prs2026/Witness/Hardware/Backplane/backplane v1/sideon_magswitch_output/sideon_preview.png

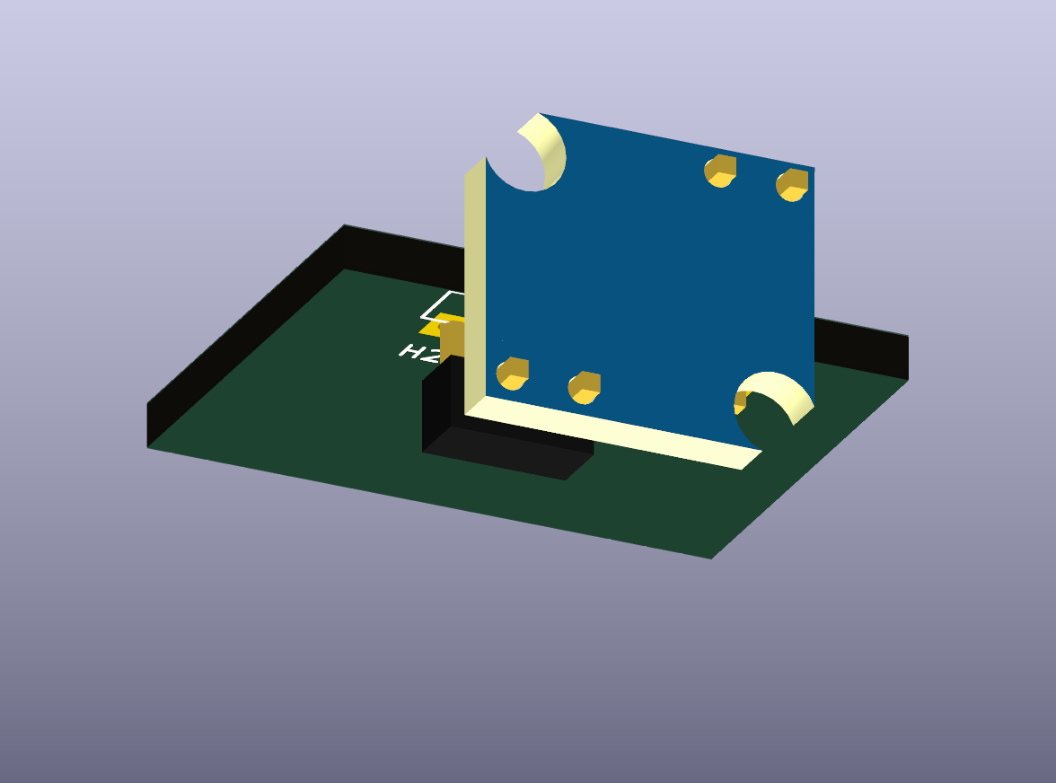
Hardware/Backplane/backplane v1/sideon_magswitch_output/sideon_preview.png
