prs2026/Witness/Hardware/Backplane/backplane v1/sideon_magswitch_output/sideon_front.png

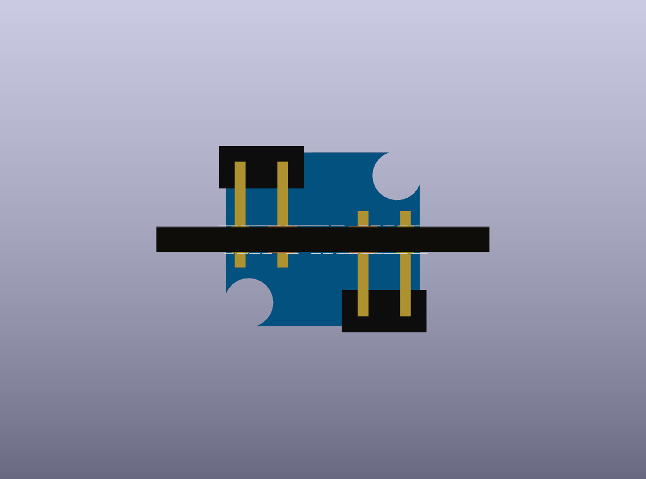
Hardware/Backplane/backplane v1/sideon_magswitch_output/sideon_front.png
