prs2026/Witness/Software/Horizon/GROUND_STATION_PROTOCOL.md

# Witness Ground-Station Communications Standard

This document describes the protocol implemented by the Witness firmware. The
authoritative machine-readable definitions remain in `main/comms.h`; this file
explains how a ground station should encode, transmit, find, and decode them.

## 1. Canonical application frame

All defined application packets use the same framing:

```text
+-----------+----------------------+------------+
| packet ID | fixed-length payload | EOF = 0x0A |
| 1 byte    | determined by ID     | 1 byte     |
+-----------+----------------------+------------+
```

- Multi-byte integers are big-endian.
- Signed integers use two's-complement representation.
- Floating-point values are big-endian IEEE-754 binary32 values.
- There is currently no application-level CRC. LoRa uses the SX1262 hardware
  CRC.
- `0x0A` is not escaped and may occur inside a payload. Never search for the
  next `0x0A` to find a frame boundary. Read the packet ID, select its fixed
  frame length, and check `0x0A` only at that frame's final byte.

Packet lengths include the packet ID and EOF:

| ID | Name | Payload bytes | Frame bytes | Local/USB rate | Default radio rate |
|---:|---|---:|---:|---|---|
| `0x01` | Sensor | 21 | 23 | 10 Hz | latest frame at 1 Hz |
| `0x02` | Estimated state | 63 | 65 | 1 Hz | latest frame at 1 Hz |
| `0x03` | Camera telemetry | 17 | 19 | Iris CAN, 1 Hz | latest frame at 1 Hz |
| `0x05` | Command | 8 | 10 | received externally | immediate; latest local frame at 1 Hz |
| `0x06` | Command acknowledgement | 11 | 13 | reply to each canonical command, on the link it arrived on | same, immediate |
| `0x07` | GPS-assist transfer status | 74 | 76 | reply to GPS-assist STATUS, on the link it arrived on | same, immediate |
| `0x0C` | HITL sensor input | 45 | 47 | host to Witness over USB only, ~100 Hz | never transmitted |
| `0x0E` | HITL IMU batch (8 samples at 960 Hz) | 148 | 150 | host to Witness over USB only, 120 Hz | never transmitted |
| `0xE0` | Witness debug | 101 | 103 | 10 Hz after debug enable | latest frame at 1 Hz |
| `0xE1` | IRIS debug | 12 | 14 | Iris CAN, 10 Hz after debug enable | latest frame at 1 Hz |
| `0xE2` | Kalman filter log | 101 | 103 | flash `P*.BIN` only, 25 Hz | never transmitted |
| `0xFF` | Heartbeat | 6 | 8 | 1 Hz | latest frame at 1 Hz |
| `0xF0` | Ground-station status | 27 | 29 | Aperture USB, 1 Hz | never transmitted |

All offsets in the packet tables below are absolute frame offsets: packet ID
is byte 0, the first payload byte is byte 1, and EOF is the last byte.

## 2. Common field encodings

| Field | Wire type | Conversion |
|---|---|---|
| Witness/IRIS uptime | `uint32` BE | milliseconds since boot; wraps after about 49.7 days |
| Witness/IRIS MCU temperature | `int8` | degrees C = raw |
| Witness/IRIS battery | `uint16` BE | millivolts = raw |
| Filtered acceleration | `int24` BE | g = raw x 0.000040 |
| Quaternion X/Y/Z/W | float32 BE | unitless normalized Hamilton quaternion, scalar last, body to ENU world; all zero = unavailable |
| Position X/Y/Z | float32 BE | meters, estimator local frame |
| Velocity X/Y/Z | float32 BE | meters/second, estimator local frame |
| LSM6 low-g acceleration | `int16` BE | g = raw x 0.000488 |
| LSM6 high-g acceleration | `int16` BE | g = raw x 0.010417 |
| LSM6 angular rate | `int16` BE | degrees/second = raw x 0.070 |
| LSM6 temperature | `int16` BE | degrees C = 25 + raw / 256 |
| MS5607 pressure | `uint24` BE | pascals = raw |
| MS5607 temperature | `int16` BE | degrees C = raw / 100 |
| MS5607 altitude | float32 BE | geometric meters, ISA (all layers to 47 km) relative to 1013.25 mbar |
| Latitude/longitude | `int24` BE | degrees = raw / 10,000; north/east positive |
| GPS time | `uint32` BE | Unix seconds |
| GPS altitude | float32 BE | meters above mean sea level |
| GPS satellites | `uint8` | satellites used in the solution (NMEA GGA field 7) |
| GPS fix quality | `uint8` | NMEA GGA field 6: 0 no fix, 1 GPS, 2 DGPS, ... |
| Channel current | `uint8` | amperes = raw x 0.02 |
| Command | `uint16` BE | enumeration; no scaling |

To decode a signed 24-bit integer:

```python
def i24be(data: bytes) -> int:
    value = int.from_bytes(data, "big", signed=False)
    return value - (1 << 24) if value & 0x800000 else value
```

## 3. Witness status bytes

The two-byte Witness status field appears in packets `0x01`, `0x02`, `0x05`,
`0xE0`, and `0xFF`.

Status byte 0 contains active-high flags:

| Bit | Mask | Meaning |
|---:|---:|---|
| 0 | `0x01` | Heartbeat phase; toggles once per heartbeat |
| 1 | `0x02` | Valid LSM6 low-g acceleration available |
| 2 | `0x04` | Valid LSM6 gyro sample available |
| 3 | `0x08` | Valid LSM6 temperature available |
| 4 | `0x10` | External NAND initialization or startup test failed |
| 5 | `0x20` | Valid LSM6 high-g acceleration available |
| 6 | `0x40` | Valid MS5607 sample available |
| 7 | `0x80` | Flash initialized but logging later failed |

Status byte 1 bits 0 through 2 contain the flight state. Bits 3, 4 and 5 are
flags; bits 6 and 7 are reserved and transmitted as zero.

| Bit | Mask | Meaning |
|---:|---:|---|
| 3 | `0x08` | GPS locked: a fresh GGA fix (quality >= 1, within 3 s) exists |
| 4 | `0x10` | HITL mode active: sensor, GPS and battery values are simulated |
| 5 | `0x20` | MAINTENANCE boot (Wi-Fi OTA / log download mode): flight logging is OFF and Witness is NOT flight ready (`IRIS_WITNESS_STATUS_MAINTENANCE_MASK`) |

In maintenance mode Witness's LoRa sends only one `0x02` state packet every 5 s
(a beacon), so over the radio only state packets arrive, about every 5 s; over
USB everything still arrives. Horizon shows a red banner and a
`MAINTENANCE - NOT FLIGHT READY` window-title prefix while the bit is set, and
clears them when a packet with the bit clear arrives (not on age alone).

Decode the flight state as `byte1 & 0x07`, not as the whole byte.

| Value | Flight state |
|---:|---|
| `0x00` | Pad idle |
| `0x01` | Boost |
| `0x02` | Coast |
| `0x03` | Descent |
| `0x04` | Landed |

## 4. Packet layouts

### `0x01` Sensor packet, 23 bytes

| Frame offset | Size | Field |
|---:|---:|---|
| 0 | 1 | Packet ID `0x01` |
| 1 | 2 | Witness status |
| 3 | 4 | Witness uptime, ms |
| 7 | 3 | Filtered acceleration X, signed int24 |
| 10 | 3 | Filtered acceleration Y, signed int24 |
| 13 | 3 | Filtered acceleration Z, signed int24 |
| 16 | 2 | Gyro X, signed int16 |
| 18 | 2 | Gyro Y, signed int16 |
| 20 | 2 | Gyro Z, signed int16 |
| 22 | 1 | EOF `0x0A` |

Filtered acceleration is the calibrated low-g accelerometer. From the first
sample where any axis of either accelerometer reaches 15 g, it is the high-g
accelerometer instead, back to low-g once all axes stay below 13 g for about
10 ms. It is low-pass filtered (2nd-order Butterworth, 100 Hz, about 2.5 ms
delay) on the 960 Hz sample stream and sent in the 40 micro-g/count format
(range about +/-335 g).

### `0x02` Estimated-state packet, 65 bytes

| Frame offset | Size | Field |
|---:|---:|---|
| 0 | 1 | Packet ID `0x02` |
| 1 | 2 | Witness status |
| 3 | 4 | Witness uptime, ms |
| 7 | 4 | Quaternion X, float32 |
| 11 | 4 | Quaternion Y, float32 |
| 15 | 4 | Quaternion Z, float32 |
| 19 | 4 | Quaternion W, float32 |
| 23 | 4 | Position X, float32 m |
| 27 | 4 | Position Y, float32 m |
| 31 | 4 | Position Z, float32 m |
| 35 | 4 | Velocity X, float32 m/s |
| 39 | 4 | Velocity Y, float32 m/s |
| 43 | 4 | Velocity Z, float32 m/s |
| 47 | 3 | Latitude, signed int24 |
| 50 | 3 | Longitude, signed int24 |
| 53 | 4 | GPS altitude, float32 m MSL |
| 57 | 4 | Kalman altitude, float32 m above the pad (see below) |
| 61 | 2 | Witness/FC battery voltage, uint16 mV |
| 63 | 1 | GPS satellites used, uint8 |
| 64 | 1 | EOF `0x0A` |

Status, uptime, the orientation quaternion, Kalman altitude, battery
voltage, valid UART1 GPS fixes and the satellite count are populated. Position
and velocity come from the position Kalman filter: ENU metres and m/s, origin
at the pad, zero until the attitude is initialized and held at zero while the
vehicle sits still on the pad. Satellites come from the most recent checksum-valid
GGA within 3 s and are reported even when that GGA has no fix (position fields
are then zero); they are 0 when stale.

The altitude at offset 57 is the position Kalman filter's up estimate (equal
to Position Z), in metres above the pad. Firmware before 2026-11-10 sent the
raw MS5607 barometric altitude (m, ISA 1013.25 mbar) in this slot. Raw pressure
is still in `0x01`/`0xE0` and the flash sensor log, from which Horizon
recomputes the barometric altitude.

Quaternion convention (`0x02` and `0xE0`): Hamilton quaternion sent X, Y, Z,
W (scalar last), rotating BODY vectors into WORLD (`v_world = q v_body q^-1`).
WORLD is local ENU (+X east, +Y north, +Z up). BODY is the LSM6 sensor frame,
with +X along the rocket nose axis, so an upright rocket on the pad has body +X
pointing to world +Z. **All four components zero means attitude is not
available**: before the first accepted 1 s stationary window on the pad,
after HITL entry/exit until a new window is accepted, or when no window was
accepted before launch. Heading (rotation about world +Z) is not observable without a
magnetometer; it is fixed arbitrarily by the shortest-arc tilt alignment at
initialization (an exactly upright rocket gets body +Y = north, body +Z =
west), so compare yaw only relative to that start. The attitude is gyro
propagated on the pad with a gated accelerometer tilt correction, purely gyro
integrated in Boost/Coast/Descent, and held constant from Landed onwards.

### `0x03` Camera telemetry packet, 19 bytes

| Frame offset | Size | Field |
|---:|---:|---|
| 0 | 1 | Packet ID `0x03` |
| 1 | 2 | Flight-controller/Witness status |
| 3 | 4 | Flight-controller/Witness uptime, ms |
| 7 | 2 | IRIS status |
| 9 | 4 | IRIS uptime, ms |
| 13 | 1 | Channel 1 current, 0.02 A/count |
| 14 | 1 | Channel 2 current, 0.02 A/count |
| 15 | 1 | Channel 3 current, 0.02 A/count |
| 16 | 2 | IRIS battery voltage, mV |
| 18 | 1 | EOF `0x0A` |

IRIS status flags are defined in `comms.h`: monitor error, battery error, command flag, OUT1/2/3 enabled, and 5 V enabled.

### `0x05` Command packet, 10 bytes

| Frame offset | Size | Field |
|---:|---:|---|
| 0 | 1 | Packet ID `0x05` |
| 1 | 2 | Witness status supplied by sender |
| 3 | 4 | Sender uptime in milliseconds |
| 7 | 2 | Command value, uint16 BE |
| 9 | 1 | EOF `0x0A` |

Example command packet with zero status/uptime and command `0x0051`:

```text
05 00 00 00 00 00 00 00 51 0A
```

Command values currently defined:

| Value | Meaning |
|---:|---|
| `0x0030` | Channel 1 load off |
| `0x0031` | Channel 1 load on |
| `0x0032` | Channel 2 load off |
| `0x0033` | Channel 2 load on |
| `0x0034` | Channel 3 load off |
| `0x0035` | Channel 3 load on |
| `0x0050` | 5 V regulator off |
| `0x0051` | 5 V regulator on |
| `0x00E0` | Enable Witness debug packets at 10 Hz |
| `0x4849` | Enter HITL mode (USB only, Pad Idle only; see section 4a) |
| `0x4858` | Exit HITL mode (USB or LoRa) |
| `0x6868` | Enter read-only USB mass-storage mode. USB only, and only in Pad Idle or Landed; over LoRa it is always refused (`IRIS_ACK_REFUSED`) |
| `0x6869` | Erase all stored log sessions (every block; slow). USB only, Pad Idle or Landed only; refused over LoRa |
| `0x686A` | Clear all stored log sessions (fast: only the two session headers are erased; the session number keeps counting). USB only, Pad Idle or Landed only; refused over LoRa |
| `0x4741` / `0x4744` / `0x4745` / `0x4751` | GPS assistance upload BEGIN / DATA / COMMIT / STATUS (ephemeris for the receiver; chunked, Witness-local, never forwarded; see section 4b) |
| `0x4752` | GPS cold start: the receiver forgets ephemerides, almanac, position and time; Witness then reconfigures it (Pad Idle only; Witness-local, never forwarded) |
| `0x4844` | Pad heading: body axis and azimuth (Pad Idle only; Witness-local; see section 4c) |
| `0x5250` | Radio power, RAM only: d0 target (`0x00` Witness, `0x01` ground station), d1 SX1262 drive in dBm as int8, -9..+3 (Ra-01SH-P output is about 26 dB higher). Both radios boot at -9 dBm. Witness applies target 0 from USB or radio. Aperture applies target 1 to its own radio, acks on USB and does not transmit it. The ack's detail is the drive now in use (int16); out of range is answered with "bad argument". |
| `0x5746` | Wi-Fi OTA / log download, Witness only, USB or radio, Pad Idle or Landed only (otherwise refused): d0 `0` off / `1` on, d1 Wi-Fi max TX power in dBm as int8 (`0` keeps the default +8; 2..20), d2 auto-off minutes (`0` = 15; up to 240). Never starts at boot. `0x5746` now reboots Witness into maintenance mode (status byte 1 bit 5); d0 `2` is a status query whose ack detail is: bit 8 AP up, bit 9 start watchdog fired, low byte last start step (`0xEE` = start failed). While on, Witness stops all LoRa transmission (telemetry and acks) but keeps receiving; the ack of a radio off command is sent after Wi-Fi is off. Turns off by itself without HTTP activity and on any flight state change out of Pad Idle/Landed. Out-of-range arguments are answered with "bad argument". Use `witness_ota.py` on the access point `witness-XXXX` (192.168.4.1). |
| `0x7300` through `0x7304` | Set flight state using the values above. Over LoRa only Landed -> Pad Idle (`0x7300` while Landed, to re-arm after recovery) is accepted; everything else, including the `0x7301` launch trigger, is refused. Over USB any state is accepted from Pad Idle or Landed, but from Boost/Coast/Descent only Landed (`0x7304`) is; other requests are refused. Refusals ack `IRIS_ACK_REFUSED` |

The last three commands also have legacy compact USB forms described in
section 7. Canonical commands received from USB or LoRa are retransmitted
byte-for-byte through the Iris CAN link. The firmware does not rewrite their status or uptime.
Radio commands are additionally interpreted locally.

### `0x06` Command acknowledgement packet, 13 bytes

Witness sends one `0x06` for each canonical 10-byte `0x05` command it handles,
on the link the command arrived on (USB, or radio through Aperture, which
forwards the frame to USB unchanged). Two commands are not acknowledged this
way: GPS-assist DATA (`0x4744`) is confirmed in bulk by `0x07`, and GPS-assist
STATUS (`0x4751`) is answered only by `0x07`. The host matches an
acknowledgement to a command by opcode and the six data bytes.

| Frame offset | Size | Field |
|---:|---:|---|
| 0 | 1 | Packet ID `0x06` |
| 1 | 2 | Opcode of the command acknowledged, uint16 BE (command bytes 7-8) |
| 3 | 6 | The command's six data bytes (frame bytes 1-6), echoed |
| 9 | 1 | Result (table below) |
| 10 | 2 | Detail, uint16 BE; zero unless stated below |
| 12 | 1 | EOF `0x0A` |

| Value | Name | Meaning |
|---:|---|---|
| `0x00` | ok | Applied or accepted |
| `0x01` | refused | Not allowed now (flight state or mode) |
| `0x02` | bad argument | Malformed or out-of-range data, or a GPS-assist BEGIN/COMMIT with no matching transfer |
| `0x03` | unknown command | Opcode not recognized |
| `0x04` | busy | Try again later; GPS-assist COMMIT could not be queued to the receiver |
| `0x05` | incomplete | GPS-assist COMMIT with chunks missing; detail = chunks received; transfer stays open |
| `0x06` | bad CRC | GPS-assist COMMIT: CRC mismatch; transfer discarded |
| `0x07` | bad format | GPS-assist COMMIT: records do not parse; transfer discarded |

Example, pad heading command accepted:

```text
06 48 44 00 69 78 00 00 00 00 00 0A
```

### `0x07` Transfer status packet, 76 bytes

Witness sends this in reply to GPS-assist STATUS (`0x4751`), on the link the
STATUS arrived on. The STATUS data bytes d0-d1 give the first chunk of the
bitmap window; `0xFFFF` (or zero) means the window starts at the first missing
chunk. Chunks are 4 bytes each (section 4b).

| Frame offset | Size | Field |
|---:|---:|---|
| 0 | 1 | Packet ID `0x07` |
| 1 | 1 | Transfer id |
| 2 | 1 | State: 0 idle, 1 receiving, 2 complete (last transfer committed and passed to the receiver), 3 failed (CRC or format) |
| 3 | 2 | Blob length, uint16 BE |
| 5 | 2 | Chunks expected, uint16 BE |
| 7 | 2 | Chunks received, uint16 BE |
| 9 | 2 | First chunk of the bitmap window, uint16 BE |
| 11 | 64 | Bitmap: bit `i` of byte `i // 8` (LSB first) is chunk `window + i`; set = received. Chunks past the end of the blob read as set |
| 75 | 1 | EOF `0x0A` |

### 4b. GPS assistance upload (ground -> Witness -> GPS)

The SkyTraq PX1120S has no almanac-upload message (AN0037), but it accepts
GPS ephemeris over UART: message 0x41 "Set GPS Ephemeris", 87 bytes (SV id,
then subframes 1-3 as a reserved byte plus the 24 data bits of words 2-10),
answered by ACK `83 41` or NACK `84 41`. Ephemeris is more useful than an
almanac: the receiver needs no subframe decoding before its first fix.

The ground builds a blob of records `[u16 length][SkyTraq body]` (at most
4096 bytes; 29 ephemerides are 2,581 bytes) and sends it in ordinary
canonical command frames `05 d0 d1 d2 d3 d4 d5 HH LL 0A`:

| Opcode | Data bytes d0-d5 |
|---|---|
| `0x4741` BEGIN | total length (u16 BE), CRC-16/CCITT-FALSE of the blob (u16 BE), format 1 (SkyTraq), transfer id |
| `0x4744` DATA | byte offset (u16 BE, multiple of 4), 4 data bytes (last chunk zero padded) |
| `0x4745` COMMIT | transfer id |
| `0x4751` STATUS | none; Witness logs the transfer and receiver progress |

Chunks may arrive out of order or repeated. COMMIT checks every chunk and the
CRC; Witness then writes the records to the receiver one at a time (waiting
up to 1 s for each ACK/NACK, one retry) and logs `GPS assist done: A/N
acknowledged, R rejected, U unanswered`. A COMMIT with missing chunks logs
how many arrived, so the ground can resend. The frames work over USB and the
radio; they are never forwarded to CAN or retransmitted by radio.
`Horizon/gps_assist.py` builds them from a RINEX broadcast-ephemeris file;
Horizon's Witness monitor has an "Upload GPS ephemeris…" button and the HITL
bench sends the RF scenario's ephemerides before a run.

**Resume.** A BEGIN with the same id, length and CRC as the transfer in progress
is accepted without clearing it, so chunks already received are kept. A BEGIN
with any other id, length or CRC starts over and discards the chunks. A COMMIT
repeated after a successful commit is answered `ok` again (`AlreadyComplete` in
the firmware) without passing the records to the receiver a second time, so a
lost COMMIT acknowledgement is harmless.

**Acknowledgements.** BEGIN is acknowledged `ok` when accepted (detail 0) and
`bad argument` when rejected. DATA is never acknowledged; a rejected DATA frame
is dropped silently. STATUS is answered only by `0x07`. COMMIT is answered with
the result codes of section 4 (`0x06`).

### 4c. Pad heading command (ground -> Witness)

Canonical command `0x4844` tells Witness which body axis points to which
azimuth while the rocket is on the pad. Witness has no magnetometer, so without
it the heading stays arbitrary until GPS shows the course. The data bytes are
the usual six bytes of frame offsets 1-6:

| Frame offset | Data | Field |
|---:|---:|---|
| 1 | d0 | Body axis: `0` +Y, `1` -Y, `2` +Z, `3` -Z; `0xFF` clears the setting |
| 2-3 | d1-d2 | Azimuth in 0.01 degree clockwise from true north, uint16 BE, 0 to 35999 |
| 4-6 | d3-d5 | Zero |

Examples (the axis is set so that it points to the azimuth):

```text
05 00 69 78 00 00 00 48 44 0A    +Y points to 270.00 degrees
05 FF 00 00 00 00 00 48 44 0A    clear
```

Witness applies the setting by turning its attitude about the vertical, and
re-applies it after every attitude re-initialization on the pad. Pad Idle only:
otherwise the acknowledgement is `refused`. An unknown axis code or an azimuth of
36000 or more is `bad argument`. Accepted over USB and radio. Horizon's
"Set pad heading…" button builds the frame with `build_pad_heading_packet`.

### 4d. Ground-station acknowledgement and retry (Horizon)

Horizon (`command_link.py`, `monitor_core.py`) handles acknowledged commands as
follows:

- Each canonical command except GPS-assist DATA is written and then waited on
  for a matching `0x06`. It waits 0.5 s per try on USB or 1.5 s via TCP
  (Aperture/radio), resending the frame before each retry, for up to 5 tries.
- Console lines: `ACK[target] label: ok`, `NAK[target] label: <result> (detail n)`,
  or `NO_ACK[target] label: no acknowledgement after 5 tries`.

GPS-assist upload (`upload_gps_assist` / `CommandLink.upload_assist`):

1. BEGIN is sent and acknowledged (3 tries per round). Without an answer Horizon
   waits 1 s and tries again, for up to 600 s.
2. All DATA chunks are sent, paced at 3 ms per frame on USB or 60 ms via TCP.
3. A STATUS (window from the first missing chunk) is sent and the `0x07` bitmap is
   read. If there is no reply, Horizon waits 1 s, sends BEGIN again (resume, which
   must be acknowledged) and asks STATUS again, until the 600 s limit.
4. Only the chunks the bitmap reports missing are resent, followed by STATUS, until
   every chunk is held.
5. If the reply shows a different transfer id or a state other than receiving (for
   example after a Witness reboot), Horizon sends BEGIN again and resends every
   chunk. A complete transfer with the same id ends the upload as already complete.
6. COMMIT is sent and acknowledged (5 tries). `ok` ends the upload; any other
   result is reported as a refusal with its detail.

### `0xFF` Heartbeat packet, 8 bytes

| Frame offset | Size | Field |
|---:|---:|---|
| 0 | 1 | Packet ID `0xFF` |
| 1 | 2 | Witness status |
| 3 | 4 | Witness uptime, ms |
| 7 | 1 | EOF `0x0A` |

### `0xF0` Ground-station status packet, 29 bytes

Aperture emits this frame only over USB once per second. It is never sent over
LoRa. Its GPS fields come from Aperture's own Quectel LC86 receiver in the pad
box and give the launch pad position when the Featherweight ground station's
location is not available.

| Frame offset | Size | Field |
|---:|---:|---|
| 0 | 1 | Packet ID `0xF0` |
| 1 | 1 | Last valid LoRa RSSI, int8 dBm (`-127` before the first packet) |
| 2 | 4 | Station uptime, uint32 ms |
| 6 | 1 | GPS fix quality, uint8, NMEA GGA field 6 (0 = no fix) |
| 7 | 1 | GPS satellites used, uint8 (GGA field 7) |
| 8 | 4 | Latitude, int32, 1e-7 degree/count, north positive |
| 12 | 4 | Longitude, int32, 1e-7 degree/count, east positive |
| 16 | 4 | GPS altitude, float32 m above mean sea level |
| 20 | 4 | GPS time, uint32 Unix seconds (0 = unknown) |
| 24 | 2 | HDOP, uint16, 0.01/count (`0xFFFF` = unknown) |
| 26 | 2 | Fix age, uint16 ms since the reported position (`0xFFFF` = none, or 65.535 s or older) |
| 28 | 1 | EOF `0x0A` |

Payload offsets in `comms.h` (`IRIS_PACKET_GROUND_STATION_STATUS_*_OFFSET`)
are these frame offsets minus one. All multi-byte fields are big-endian.

- Fix quality, satellites and HDOP come from the most recent checksum-valid
  GGA, including a no-fix GGA. When that GGA is 3 s old or older (or none has
  arrived), quality and satellites are 0 and HDOP is `0xFFFF`.
- Latitude, longitude and altitude hold the last valid fix (GGA quality 1..8
  with a parseable position), however old; use the fix-age field to judge it.
  They are zero, with fix age `0xFFFF`, until a fix has been seen since boot.
- GPS time is the UTC of the last RMC with status `A`, advanced by the
  station's elapsed time since that RMC arrived, so it keeps counting through a
  dropout. It is 0 until such an RMC has been received.
- Hosts should still accept the pre-GPS 13-byte form (11-byte payload: RSSI,
  uptime, six zero bytes; `IRIS_PACKET_GROUND_STATION_STATUS_LEGACY_DATA_LENGTH`).

### `0xE0` Witness debug packet, 103 bytes

| Frame offset | Size | Field |
|---:|---:|---|
| 0 | 1 | Packet ID `0xE0` |
| 1 | 2 | Witness status |
| 3 | 4 | Witness uptime, ms |
| 7 | 1 | Witness MCU temperature, int8 C |
| 8 | 2 | Witness battery voltage, uint16 mV |
| 10, 13, 16 | 3 each | Filtered acceleration X/Y/Z, int24 |
| 19, 23, 27, 31 | 4 each | Quaternion X/Y/Z/W, float32 |
| 35, 39, 43 | 4 each | Position X/Y/Z, float32 m |
| 47, 51, 55 | 4 each | Velocity X/Y/Z, float32 m/s |
| 59, 61, 63 | 2 each | LSM6 low-g X/Y/Z, int16 |
| 65 | 2 | LSM6 temperature, int16 |
| 67, 69, 71 | 2 each | LSM6 high-g X/Y/Z, int16 |
| 73, 75, 77 | 2 each | LSM6 gyro X/Y/Z, int16 |
| 79 | 3 | MS5607 pressure, uint24 Pa |
| 82 | 2 | MS5607 temperature, int16 centi-C |
| 84 | 4 | Kalman altitude, float32 m above the pad (as `0x02`) |
| 88 | 3 | Latitude, int24 |
| 91 | 3 | Longitude, int24 |
| 94 | 4 | GPS Unix time, uint32 s |
| 98 | 4 | GPS altitude, float32 m MSL |
| 102 | 1 | EOF `0x0A` |

Position and velocity are the Kalman filter estimate, as in `0x02`. MCU
temperature and GPS Unix time remain zero. The
quaternion is populated exactly as in `0x02` (same convention; all zero until
the estimator is initialized), so enabling debug output with command `0x00E0`
gives 10 Hz quaternions on USB (LoRa still sends the newest debug frame at its
1 Hz radio rate). GPS latitude, longitude and MSL altitude come from UART1 NMEA
GGA fixes.

### `0xE2` Kalman filter log packet, 103 bytes (flash log only)

Witness writes one per position-filter update cycle (25 Hz) into the flash
packet stream (`P*.BIN`, record source 5) for post-flight review of the
filter. It is never sent over LoRa, USB or CAN. Floats are big-endian
float32; axes are East, North, Up relative to the pad.

| Frame offset | Size | Field |
|---:|---:|---|
| 0 | 1 | Packet ID `0xE2` |
| 1 | 1 | Flight state (0 Pad Idle .. 4 Landed) |
| 2 | 1 | Flags (below) |
| 3 | 1 | GPS satellites in the latest fix |
| 4, 8, 12 | 4 each | Position E/N/U, m |
| 16, 20, 24 | 4 each | Velocity E/N/U, m/s |
| 28, 32, 36 | 4 each | Position variance P00 E/N/U, m^2 |
| 40, 44, 48 | 4 each | Velocity variance P11 E/N/U, (m/s)^2 |
| 52, 56, 60 | 4 each | Position-velocity covariance P01 E/N/U, m^2/s |
| 64 | 4 | Barometer innovation (measurement - prediction), m |
| 68 | 4 | Barometer innovation variance S = P00 + R, m^2 |
| 72 | 4 | Barometer measurement sigma (sqrt R) of the latest update, m |
| 76, 80, 84 | 4 each | GPS innovation E/N/U, m |
| 88 | 4 | Mach (filter speed / ISA speed of sound) |
| 92 | 2 | Barometer updates used, uint16 running total |
| 94 | 2 | Barometer updates skipped by the Mach gate, uint16 |
| 96 | 2 | Barometer updates rejected by the 5-sigma gate, uint16 |
| 98 | 2 | GPS fixes used, uint16 |
| 100 | 2 | GPS axis updates rejected, uint16 |
| 102 | 1 | EOF `0x0A` |

Variances are after the cycle's updates. Innovations are NaN when that
measurement was not offered in the cycle; they are recorded whether or not the
gate accepted them. GPS R is (2.5 m horizontal, 5 m vertical, doubled below 6
satellites)^2. Counters wrap at 65536.

Flags: `0x01` filter initialized (attitude known), `0x02` IMU ignored (attitude
lost after gyro saturation), `0x04` pad hold, `0x08` barometer Mach gate
active, `0x10` barometer update accepted this cycle, `0x20` at least one GPS
axis accepted this cycle, `0x40` GPS origin set, `0x80` HITL active.

Horizon `converter.py` decodes it in `P*.BIN` exports (`packet_type`
`kalman_log`), adding `kf_*` flag columns and `position_sigma_*` /
`velocity_sigma_*` (square roots of the variances).

### `0xE1` IRIS debug packet, 14 bytes

| Frame offset | Size | Field |
|---:|---:|---|
| 0 | 1 | Packet ID `0xE1` |
| 1 | 2 | IRIS status |
| 3 | 4 | IRIS uptime, ms |
| 7 | 1 | IRIS MCU temperature, int8 C |
| 8 | 2 | IRIS battery voltage, uint16 mV |
| 10 | 1 | Channel 1 current, 0.02 A/count |
| 11 | 1 | Channel 2 current, 0.02 A/count |
| 12 | 1 | Channel 3 current, 0.02 A/count |
| 13 | 1 | EOF `0x0A` |

## 4a. HITL (hardware-in-the-loop) mode

HITL replaces Witness's IMU, barometer, GPS and battery readings with values
from host `0x0C` packets, so the flight state machine, telemetry and flash
logging run on simulated data. Real IMU, barometer and battery reads stop;
LoRa, CAN and logging continue.

- **Enter**: canonical 10-byte command `0x4849` (for example
  `05 00 00 00 00 00 00 48 49 0A`), accepted only from USB and only in Pad
  Idle. From LoRa, in another flight state, or in compact `05 48 49` form it is
  rejected and logged. Reboot always starts with HITL off.
- **Exit**: canonical command `0x4858` from USB or LoRa, or automatically when
  no valid `0x0C` packet arrives for 1000 ms (from entry or from the last
  packet). Exit does not change the flight state; send `0x7300` to return to
  Pad Idle if the simulation launched.
- **Detect**: status byte 1 bit 4 (`0x10`) is set while HITL is active.
- **Between enter and the first `0x0C` packet** all readiness flags (byte 0
  bits 1, 2, 3, 5, 6) are clear, battery and barometer fields are zero, the
  GPS reports no fix and 0 satellites, no `0x01` packet is produced and the
  flight state machine receives no input. No real reading is mixed in. The
  same reset happens on exit until real sensors produce new data.
- While active, each `0x0C` packet sets the low-g, high-g, gyro and IMU
  temperature ready flags; the barometer flag is set when pressure is non-zero.
  Barometric altitude is computed from the pressure with the MS5607 formula.
  The GPS fields feed state, debug and the GPS-locked bit exactly like a UART
  GGA (quality 1..8 is a fix; satellites are reported without one).
- The attitude estimator is reset on HITL entry and exit, then runs on the
  `0x0C` gyro and low-g accelerometer counts exactly as on real data: the
  quaternion stays all zero until a 1 s stationary window of simulated
  samples is accepted in Pad Idle (every |a| 0.95..1.05 g, accel scatter
  <= 0.02 g, gyro median <= 5 dps with at most 40% of samples more than 10 dps
  from it). Its time step is the Witness time of the sensor pass that consumed
  each frame (the `sim_time_ms` field is not used); a pass without a new frame
  is skipped and the next step spans 20 ms. The gyro passes through a 5-sample
  running median, so the reported attitude lags by 2 samples (20 ms). Send
  frames at a steady 100 Hz.
- HITL commands are bridged to Iris like any other `0x05` command (Iris ignores
  them). `0x0C` packets are never forwarded to CAN or LoRa.
- **`0x0E` HITL IMU batch** (optional, USB only): payload u32 index of the first
  sample (counting from 0 in each run), then 8 samples of int16 low-g x,y,z,
  high-g x,y,z, gyro x,y,z in the same counts as `0x0C`, followed by EOF
  `0x0A`. The samples are consecutive at 960 Hz. While these arrive, Witness
  runs its estimators and IMU log on them at 960 Hz and ignores the IMU fields
  of `0x0C`.
- Witness stops its attitude (all-zero quaternion) for the rest of a flight
  once any gyro axis saturates (>= 1950 dps for 2 samples) in Boost, Coast or
  Descent. Its position filter then ignores the IMU.

### `0x0C` HITL sensor input packet, 47 bytes (host to Witness, USB only)

| Frame offset | Size | Field |
|---:|---:|---|
| 0 | 1 | Packet ID `0x0C` |
| 1 | 2 | Sender status, ignored |
| 3 | 4 | Simulation time, uint32 ms (logged only) |
| 7, 9, 11 | 2 each | LSM6 low-g X/Y/Z, int16, 0.488 mg/count |
| 13, 15, 17 | 2 each | LSM6 high-g X/Y/Z, int16, 10.417 mg/count |
| 19, 21, 23 | 2 each | LSM6 gyro X/Y/Z, int16, 70 mdps/count |
| 25 | 2 | LSM6 temperature, int16, C = 25 + raw / 256 |
| 27 | 3 | Pressure, uint24 Pa (0 = no barometer data) |
| 30 | 2 | Barometer temperature, int16 centi-C |
| 32 | 3 | Latitude, int24, 0.0001 degree |
| 35 | 3 | Longitude, int24, 0.0001 degree |
| 38 | 4 | GPS altitude, float32 m MSL |
| 42 | 1 | GPS satellites used, uint8 |
| 43 | 1 | GGA fix quality, uint8 (0 = no fix) |
| 44 | 2 | Battery voltage, uint16 mV |
| 46 | 1 | EOF `0x0A` |

Send one complete frame per write, back to back at about 100 Hz (at least
every 1000 ms to stay in HITL). Witness frames them by fixed length and checks
EOF at byte 46; on a bad EOF it resynchronizes on the next `0x0C` byte. A `0x0C`
byte starts a frame unless an unfinished binary `0x05` command is in
progress; a `0x0C` or `0x05` byte discards any unterminated text line first.
Send commands as complete canonical frames between `0x0C` frames. Bytes consumed as `0x0C` frames, valid or not,
are **not echoed**; all other USB input is still echoed. Frames received while
HITL is inactive are discarded with a rate-limited log line.

## 5. LoRa/RA-01 settings

Witness radio is enabled in the checked-in configuration (`HW_RADIO_ENABLED=1`).
The RA-01/SX1262 link uses:

| Setting | Value |
|---|---|
| Packet type | LoRa |
| RF frequency | 926,000,000 Hz |
| TX power | -8 dBm (Witness), -2 dBm (Aperture) |
| Spreading factor | SF7 |
| Bandwidth | 500 kHz (SX1262 erratum 15.1 applied before every TX; see HITL/LORA_MODULATION_OPTIONS.md) |
| Coding rate | 4/5 |
| Preamble | 8 symbols |
| Header | Explicit |
| Payload CRC | Enabled |
| IQ | Normal, not inverted |
| Payload length | Variable; set to the canonical frame length for TX |

The firmware does not currently program the LoRa sync-word registers. Both
ends must use the same SX1262 reset/default sync-word setting, or the firmware
should be updated to configure an explicit value before deployment.

Every locally generated canonical packet updates a latest-frame cache keyed by
packet ID. The radio scheduler sends the newest cached frame at the independent
per-type rates declared as `kRadio*PacketRateHz` in `main/sensors.h`. All seven
rates default to 1 Hz. Changing a radio rate does not change the packet's normal
producer or USB rate. A packet type that has not yet been produced is skipped.
Rates must be non-zero integer divisors of 1000 Hz.

Only one scheduled frame is transmitted per sensor-task pass. Due packet types
are serviced round-robin, so simultaneous deadlines do not permanently favor
one ID. The requested rates are upper targets: LoRa airtime and immediate
traffic can reduce the achieved aggregate rate. Transmission is non-blocking:
the sensor task loads the frame and issues SetTx, then checks DIO1 for TxDone on
later 10 ms passes (about 43 ms of airtime for a 103-byte frame at SF7/500
kHz), so radio traffic no longer slows the 100 Hz sensor loop. A new frame is
started only after the previous one completes; reception is impossible while
transmitting. After each transmission the radio is returned to continuous
receive mode. DIO1 indicates RX or TX completion, and all radio work is
performed by the sensor task so SPI3 access does not race the sensors.

`SpiDataForwarder::kForwardExternalPacketsImmediately` controls the immediate
forwarding path and defaults to `true`. With it enabled, complete command frames
received over USB are
queued ahead of scheduled telemetry. Radio-originated packets are never sent
back to the radio, preventing an RF echo loop. Set the flag to `false` to make
all radio output use only the per-packet latest-frame schedule.

Every valid received radio packet up to the canonical maximum of 103 bytes is
forwarded unchanged to USB. A received packet beginning with `0x05` is also
queued unchanged for Iris CAN transmission and local interpretation. Debug enable,
debug enable and HITL-exit execute locally; mass storage and log erase/clear are refused over LoRa (USB only, Pad Idle/Landed); flight-state commands are limited to Landed -> Pad Idle over LoRa;
HITL enter is rejected over LoRa. Load and
5 V regulator commands have no Witness-local hardware action because they are
implemented by the external device. The GPS UART never receives these
AMA load/regulator commands. SX1262 packets with a CRC error are
discarded.

## 6. Iris CAN and GPS UART1 interfaces

### Iris CAN device link

Iris and Witness use TCAN3414-compatible transceivers with the ESP32 Classical
CAN controller at **500 kbit/s**, standard 11-bit identifiers. Witness TX is
GPIO37 and RX GPIO36. Iris TX is GPIO3 and RX GPIO1. Witness-to-Iris uses
`0x120`; Iris-to-Witness uses `0x121`. CAN FD is not used.

Each CAN data frame carries `[sequence, fragment_index, canonical_length]`
followed by up to five consecutive application-frame bytes. Indices start at
zero; every fragment repeats the sequence and total length. DLC is exactly
three plus the bytes carried. Reassembly requires ordered fragments, matching
sequence/length, and completion within 250 ms. The common implementation is
`Software/Intercomm/can_transport.h`; packets retain their canonical ID and EOF.

USB compact commands are normalized to canonical 10-byte command frames;
malformed commands are rejected before forwarding. Commands go to Iris through
CAN, never to the GPS UART. Iris replies and camera/debug telemetry are mirrored
to Witness USB and cached for the normal radio schedule; replies are not echoed
back to CAN. Witness sends a 1 Hz heartbeat over CAN, and Iris uses its status
and uptime in camera telemetry, clearing those FC fields after 3 s without a
fresh heartbeat. Iris current fields use **20 mA/count**, with a 5.10 A maximum.
Camera currents are one-second peaks; debug currents are latest samples.

Both bus ends require 120 ohm termination and a common ground. TCAN3414 STB must
be low and SHDN low or left at its specified internal pull-down for normal mode;
these boards ground STB and have no MCU standby-control signal.

### GPS UART1 receiver

GPS uses UART1; the I2C driver is not started or included in the build.

| Setting | Value |
|---|---|
| ESP32 RX | GPIO4 <- GPS TX (GPIO5 while `HW_MCU_UART_SWAP_RX_TX` is 1, as currently built) |
| ESP32 TX | GPIO5 -> GPS RX (GPIO4 while swapped) |
| Ground | Shared with receiver |
| Logic voltage | 3.3 V |
| Operational baud | 115200, 8N1, no flow control |

At startup `GpsReceiver` (`main/gps_receiver.h`) identifies the receiver as a
SkyTraq PX1120S or a u-blox NEO-M8N by which binary protocol answers a poll,
then sets airborne 4 g dynamics, the receiver's maximum update rate, and NMEA
output of GGA + RMC only. A receiver already streaming NMEA at 115200 is never
baud-probed; only a silent link is retried at 9600 (the u-blox factory rate),
and a u-blox found there is switched to 115200. A five-second `GPS RX`
diagnostic reports host baud, total bytes, valid GGA sentence count, fix
validity and time since the last UART byte. A failed startup configuration does
not stop raw collection, sensors, heartbeat or flash logging.

| Receiver | Dynamics | Update rate | NMEA output |
|---|---|---|---|
| PX1120S | navigation mode 5, airborne (4 g rated) | 25 Hz (part maximum) | GGA + RMC |
| NEO-M8N | `dynModel` 8, airborne <4 g | 10 Hz (concurrent-GNSS maximum) | GGA + RMC |

Checksum-validated NMEA GGA sentences (including GP/GN talkers) populate
latitude, longitude and GPS MSL altitude in state (0x02) and Witness debug (0xE0)
packets. Arbitrarily fragmented UART reads are supported. Coordinates convert
from NMEA degrees/minutes and hemisphere into signed decimal degrees, then are
rounded to the canonical signed int24 scale of 0.0001 degree/count.
Altitude is big-endian float32 metres above mean sea level, not ellipsoid height.
GPS Unix time remains zero (GGA contains no date).

A no-fix GGA invalidates the current fix immediately, but its satellite count
is still reported. A GGA (and its fix) expires after
`NmeaGps::kFixTimeoutMs` (3000 ms). Invalid/missing/stale fixes emit zero in all
three GPS position fields and clear status byte 1 bit 3 (GPS locked); stale
GGA data also reports 0 satellites. Zero is not a unique invalid marker: a
legitimate zero coordinate/altitude has the same representation; use the
GPS-locked bit. Bad checksums are discarded and cannot refresh the fix age.
Raw UART bytes are logged unchanged regardless of fix validity.

Settings are in `main/gps_receiver.h`: `kConfigureAtStartup`,
`kSkytraqAirborneMode`, `kSkytraqUpdateRateHz`, `kUbloxAirborne4gModel`,
`kUbloxMeasurementPeriodMs`, startup delay, reply timeout and retry count. All
settings go to receiver RAM and are reapplied on every boot without writing
receiver flash. The PX1120S datasheet specifies a 4 g dynamics capability; its
binary protocol selects `airborne` rather than a separate numeric `4 g` profile.

SkyTraq binary frames use `A0 A1`, a two-byte big-endian payload length, the
payload, its XOR checksum, and `0D 0A`. PX1120S commands (SRAM-only attributes):

| Action | Complete frame (hex) | Reply |
|---|---|---|
| Query navigation mode (also the identification poll) | `A0 A1 00 02 64 18 7C 0D 0A` | `A0 A1 00 03 64 8B 05 EA 0D 0A` when airborne |
| Set airborne navigation | `A0 A1 00 04 64 17 05 00 76 0D 0A` | ACK `83 64 17` |
| NMEA output GGA + RMC every fix | `A0 A1 00 09 08 01 00 00 00 01 00 00 00 08 0D 0A` | ACK `83 08` |
| Position update rate 25 Hz | `A0 A1 00 03 0E 19 00 17 0D 0A` | ACK `83 0E` |
| Query update rate | `A0 A1 00 01 10 10 0D 0A` | `A0 A1 00 02 86 19 9F 0D 0A` at 25 Hz |

u-blox UBX frames use `B5 62`, class, id, a little-endian payload length, the
payload and a two-byte Fletcher checksum. NEO-M8N commands (RAM only):

| Action | Complete frame (hex) | Reply |
|---|---|---|
| Identification poll `MON-VER` | `B5 62 0A 04 00 00 0E 34` | any valid UBX frame |
| `CFG-PRT` UART1 115200, UBX+NMEA (only when found at 9600) | `B5 62 06 00 14 00 01 00 00 00 D0 08 00 00 00 C2 01 00 03 00 03 00 00 00 00 00 BC 5E` | host follows after 150 ms |
| `CFG-MSG` GLL / GSA / GSV / VTG off | `B5 62 06 01 03 00 F0 01 00 FB 11`, `… F0 02 00 FC 13`, `… F0 03 00 FD 15`, `… F0 05 00 FF 19` | `ACK-ACK` each |
| `CFG-MSG` GGA / RMC on every fix | `B5 62 06 01 03 00 F0 00 01 FB 10`, `… F0 04 01 FF 18` | `ACK-ACK` each |
| `CFG-NAV5` dynamic model 8 (mask 0x0001) | `B5 62 06 24 24 00 01 00 08 00` + 32 zero bytes + `57 F8` | `ACK-ACK` |
| `CFG-RATE` 100 ms, 1 cycle, GPS time | `B5 62 06 08 06 00 64 00 01 00 01 00 7A 12` | `ACK-ACK` |
| Readback | `CFG-NAV5` and `CFG-RATE` polls (empty payload) | `dynModel` 8, `measRate` 100 |

References: [SkyTraq AN0037 binary message protocol](https://www.skytraq.com.tw/homesite/AN0037.pdf)
and the u-blox M8 receiver description (UBX-13003221).
The supplied [PX1120S manual](c4dba7.pdf) lists the receiver's dynamics rating
and factory baud rate on PDF page 3.

Every received UART byte is also queued unchanged for flash before USB forwarding or
GPS parsing. Each boot exports three files with a
matching hexadecimal session number:

| File | Contents |
|---|---|
| `U0000001.BIN` | Raw external GPS payload bytes, received over UART1 |
| `S0000001.BIN` | Existing 48-byte sensor records, using the flight-state logging gate |
| `S0000001.TXT` | ESP-IDF diagnostic output |

GPS capture runs in every flight state, including Pad Idle and Landed. A
32 KiB RAM queue absorbs flash write delays. Flash staging uses 4,080-byte batches and flushes partial batches every
second. Entering read-only mass storage (`05 68 68`) stops capture and writes
all accepted bytes before publishing the files. GPS data arriving after
capture stops is not part of the exported snapshot. Sudden power loss can lose
the bytes still buffered in RAM; use the export command before disconnecting.

New sessions use storage layout version 4, built for one flight at a time:
two slots of 502 blocks. Each holds:
- 96 NAND blocks for the 24-byte IMU stream (`I*.BIN`, 960 Hz until Descent,
  then 96 Hz);
- 40 for sensor data (24-byte WL v2 records at 50 Hz: status, uptime, pressure
  and temperatures; the IMU samples and altitude/battery live in the I*/P* streams);
- 24 for diagnostics;
- 120 for the packet stream (`P*.BIN`: Witness state packets at 50 Hz, every
  packet sent or received over CAN, and radio commands);
- 221 (about 28.8 MB) for external GPS data.

The diagnostic, packet and GPS sections are circular on the pad, so a long pad
wait loses only the oldest pad data. From launch on they keep everything
written since launch. The slot holding the newest flight is kept until the
next flight; pad-only power cycles reuse the other slot. Version 3 sessions
(no packet stream) still export; older versions do not. No format or erase is required to upgrade. Buffer overflow or
flash write failure sets the existing flash-log-failed status bit. When the IMU,
sensor or diagnostic allocation fills, that stream stops with a diagnostic and
the other streams continue. These are
finite buffers, not an unlimited lossless recorder.

Radio initialization failure disables radio RX/TX for the rest of the boot,
without repeated initialization attempts in the sensor loop. An SPI packet-RAM
round trip rejects an absent radio even when SPI writes return success.
`HW_RADIO_ENABLED` in `hardware_pins.h` may be set to `0` to skip initialization
entirely on boards with no radio fitted. GPS logging, USB, sensors and flash
continue operating without a radio.

## 7. USB command input

The preferred ground-station command format is a complete canonical 10-byte
binary frame. For command `0x0051`:

```text
05 00 00 00 00 00 00 00 51 0A
```

USB also accepts a newline-terminated ASCII-hex representation:

```text
05 00 00 00 00 00 00 00 51 0A\r\n
```

The spaces are part of the ASCII representation. They are removed during hex
decoding, and the ten decoded bytes are queued for Iris CAN. A terminal's "send hex"
mode should instead send the ten binary bytes with no extra newline.

Legacy compact binary commands are accepted after a 20 ms idle interval:

```text
05 68 68       enter mass storage
05 68 69       erase stored sessions
05 73 00..04   set flight state
05 43 47       IMU calibration: capture gyro bias (4 s, board still)
05 43 41       IMU calibration: capture one face (2 s); six faces solve the accels
05 43 58       IMU calibration: clear
05 43 53       IMU calibration: log status
```

IMU calibration commands are USB-only and accepted only in Pad Idle with real
sensors. The calibration is stored in Witness NVS. Telemetry IMU values (`0x01`
gyro and filtered acceleration, `0xE0` low-g, high-g and gyro) are calibrated
counts; the gyro also has the attitude estimator's live pad bias removed. The
NAND `I*.BIN` stream keeps raw counts.

HITL enter/exit (`0x4849`/`0x4858`) are accepted only as canonical 10-byte
frames (binary or ASCII hex), not in compact form.

The same compact commands may be typed as ASCII hex followed by Enter. `TX 05
...` is another accepted ASCII form and queues the decoded bytes for Iris CAN.

USB input is echoed back byte-for-byte, except bytes consumed as `0x0C` HITL
frames (section 4a). A ground station using the same USB connection for
commands and telemetry must therefore recognize or suppress its own echoed
command bytes.

## 8. USB stream parsing

USB Serial/JTAG is not currently a telemetry-only channel. It may contain:

- canonical binary telemetry frames;
- received GPS UART1 or radio bytes;
- echoed ground-station input; and
- human-readable ESP-IDF log lines.

A practical stream decoder should scan for known binary packet IDs and accept
a candidate only when the fixed-length final byte is `0x0A`:

```python
FRAME_LENGTH = {
    0x01: 23,
    0x02: 65,
    0x03: 19,
    0x05: 10,
    0x06: 13,
    0x07: 76,
    0xE0: 103,
    0xE1: 14,
    0xFF: 8,
    0xF0: 29,  # pre-GPS Aperture firmware sent 13
}

def extract_frames(buffer: bytearray):
    frames = []
    while buffer:
        length = FRAME_LENGTH.get(buffer[0])
        if length is None:
            del buffer[0]
            continue
        if len(buffer) < length:
            break
        if buffer[length - 1] != 0x0A:
            del buffer[0]
            continue
        frames.append(bytes(buffer[:length]))
        del buffer[:length]
    return frames
```

This is a resynchronizing parser, not a guarantee against false positives in a
mixed byte stream. For flight use, a dedicated binary channel or an additional
sync word plus application CRC would be more robust. `0x0C` is input only and
is never emitted by Witness, so it is absent from this table.

## 9. Ground-station transmit checklist

1. Configure the LoRa modem exactly as described in section 5.
2. Build the complete canonical command frame in a byte array.
3. Encode status and uptime even if both are zero.
4. Encode the command as a big-endian uint16 at bytes 7 and 8.
5. Put `0x0A` at byte 9.
6. Send exactly ten LoRa payload bytes; do not send ASCII hexadecimal text over
   LoRa.
7. By default, expect the newest available frame of every produced packet type
   as its own LoRa payload at 1 Hz. Packet `0x02` remains a complete 65-byte
   payload.

## Aperture host input

Aperture accepts only full canonical 10-byte binary command frames. ASCII-hex
and compact forms in section 7 apply to a direct Witness USB connection. Horizon
shortcuts emit full frames for both routes. Aperture transparently forwards
received LoRa payloads unchanged to USB. CAN fragment headers are never carried
over LoRa or exposed to the host.

Shared CAN transport reference: [Intercomm](../Intercomm/README.md).
