prs2026/Witness/Software/Aperture/softwareattempt2/main/GROUND_STATION_PROTOCOL.md

# Witness Ground-Station Communications Standard

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

## 1. Canonical application frame

All defined application packets use the same framing:

```text
+-----------+----------------------+------------+
| packet ID | fixed-length payload | EOF = 0x0A |
| 1 byte    | determined by ID     | 1 byte     |
+-----------+----------------------+------------+
```

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

Packet lengths include the packet ID and EOF:

| ID | Name | Payload bytes | Frame bytes | Local/USB rate | Default radio rate |
|---:|---|---:|---:|---|---|
| `0x01` | Sensor | 21 | 23 | 10 Hz | latest frame at 1 Hz |
| `0x02` | Estimated state | 63 | 65 | 1 Hz | latest frame at 1 Hz |
| `0x03` | Camera telemetry | 17 | 19 | Iris CAN, 1 Hz | latest frame at 1 Hz |
| `0x05` | Command | 8 | 10 | received externally | immediate; latest local frame at 1 Hz |
| `0x0C` | HITL sensor input | 45 | 47 | host to Witness over USB only, ~100 Hz | never transmitted |
| `0xE0` | Witness debug | 101 | 103 | 10 Hz after debug enable | latest frame at 1 Hz |
| `0xE1` | IRIS debug | 12 | 14 | Iris CAN, 10 Hz after debug enable | latest frame at 1 Hz |
| `0xFF` | Heartbeat | 6 | 8 | 1 Hz | latest frame at 1 Hz |
| `0xF0` | Ground-station status | 27 | 29 | Aperture USB, 1 Hz | never transmitted |

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

## 2. Common field encodings

| Field | Wire type | Conversion |
|---|---|---|
| Witness/IRIS uptime | `uint32` BE | milliseconds since boot; wraps after about 49.7 days |
| Witness/IRIS MCU temperature | `int8` | degrees C = raw |
| Witness/IRIS battery | `uint16` BE | millivolts = raw |
| Filtered acceleration | `int24` BE | g = raw x 0.000040 |
| Quaternion X/Y/Z/W | float32 BE | unitless normalized Hamilton quaternion, scalar last, body to ENU world; all zero = unavailable |
| Position X/Y/Z | float32 BE | meters, estimator local frame |
| Velocity X/Y/Z | float32 BE | meters/second, estimator local frame |
| LSM6 low-g acceleration | `int16` BE | g = raw x 0.000488 |
| LSM6 high-g acceleration | `int16` BE | g = raw x 0.010417 |
| LSM6 angular rate | `int16` BE | degrees/second = raw x 0.070 |
| LSM6 temperature | `int16` BE | degrees C = 25 + raw / 256 |
| MS5607 pressure | `uint24` BE | pascals = raw |
| MS5607 temperature | `int16` BE | degrees C = raw / 100 |
| MS5607 altitude | float32 BE | meters relative to 1013.25 mbar |
| Latitude/longitude | `int24` BE | degrees = raw / 10,000; north/east positive |
| GPS time | `uint32` BE | Unix seconds |
| GPS altitude | float32 BE | meters above mean sea level |
| GPS satellites | `uint8` | satellites used in the solution (NMEA GGA field 7) |
| GPS fix quality | `uint8` | NMEA GGA field 6: 0 no fix, 1 GPS, 2 DGPS, ... |
| Channel current | `uint8` | amperes = raw x 0.02 |
| Command | `uint16` BE | enumeration; no scaling |

To decode a signed 24-bit integer:

```python
def i24be(data: bytes) -> int:
    value = int.from_bytes(data, "big", signed=False)
    return value - (1 << 24) if value & 0x800000 else value
```

## 3. Witness status bytes

The two-byte Witness status field appears in packets `0x01`, `0x02`, `0x05`,
`0xE0`, and `0xFF`.

Status byte 0 contains active-high flags:

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

Status byte 1 bits 0 through 2 contain the flight state. Bits 3 and 4 are
flags; bits 5 through 7 are reserved and transmitted as zero.

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

Decode the flight state as `byte1 & 0x07`, not as the whole byte.

| Value | Flight state |
|---:|---|
| `0x00` | Pad idle |
| `0x01` | Boost |
| `0x02` | Coast |
| `0x03` | Descent |
| `0x04` | Landed |

## 4. Packet layouts

### `0x01` Sensor packet, 23 bytes

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

No acceleration filter is implemented yet. The firmware currently generates the
"filtered acceleration" fields from the most recent low-g accelerometer
samples, converted to the defined 40 micro-g/count format.

### `0x02` Estimated-state packet, 65 bytes

| Frame offset | Size | Field |
|---:|---:|---|
| 0 | 1 | Packet ID `0x02` |
| 1 | 2 | Witness status |
| 3 | 4 | Witness uptime, ms |
| 7 | 4 | Quaternion X, float32 |
| 11 | 4 | Quaternion Y, float32 |
| 15 | 4 | Quaternion Z, float32 |
| 19 | 4 | Quaternion W, float32 |
| 23 | 4 | Position X, float32 m |
| 27 | 4 | Position Y, float32 m |
| 31 | 4 | Position Z, float32 m |
| 35 | 4 | Velocity X, float32 m/s |
| 39 | 4 | Velocity Y, float32 m/s |
| 43 | 4 | Velocity Z, float32 m/s |
| 47 | 3 | Latitude, signed int24 |
| 50 | 3 | Longitude, signed int24 |
| 53 | 4 | GPS altitude, float32 m MSL |
| 57 | 4 | MS5607 barometric altitude, float32 m |
| 61 | 2 | Witness/FC battery voltage, uint16 mV |
| 63 | 1 | GPS satellites used, uint8 |
| 64 | 1 | EOF `0x0A` |

Status, uptime, the orientation quaternion, barometric altitude, battery
voltage, valid UART1 GPS fixes and the satellite count are populated; position
and velocity remain zero. Satellites come from the most recent checksum-valid
GGA within 3 s and are reported even when that GGA has no fix (position fields
are then zero); they are 0 when stale.

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

### `0x03` Camera telemetry packet, 19 bytes

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

### `0x05` Command packet, 10 bytes

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

Example command packet with zero status/uptime and command `0x0051`:

```text
05 00 00 00 00 00 00 00 51 0A
```

Command values currently defined:

| Value | Meaning |
|---:|---|
| `0x0030` | Channel 1 load off |
| `0x0031` | Channel 1 load on |
| `0x0032` | Channel 2 load off |
| `0x0033` | Channel 2 load on |
| `0x0034` | Channel 3 load off |
| `0x0035` | Channel 3 load on |
| `0x0050` | 5 V regulator off |
| `0x0051` | 5 V regulator on |
| `0x00E0` | Enable Witness debug packets at 10 Hz |
| `0x4849` | Enter HITL mode (USB only, Pad Idle only; see section 4a) |
| `0x4858` | Exit HITL mode (USB or LoRa) |
| `0x6868` | Enter read-only USB mass-storage mode |
| `0x6869` | Erase all stored log sessions |
| `0x7300` through `0x7304` | Set flight state using the values above |

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

### `0xFF` Heartbeat packet, 8 bytes

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

### `0xF0` Ground-station status packet, 29 bytes

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

### `0xE0` Witness debug packet, 103 bytes

| Frame offset | Size | Field |
|---:|---:|---|
| 0 | 1 | Packet ID `0xE0` |
| 1 | 2 | Witness status |
| 3 | 4 | Witness uptime, ms |
| 7 | 1 | Witness MCU temperature, int8 C |
| 8 | 2 | Witness battery voltage, uint16 mV |
| 10, 13, 16 | 3 each | Filtered acceleration X/Y/Z, int24 |
| 19, 23, 27, 31 | 4 each | Quaternion X/Y/Z/W, float32 |
| 35, 39, 43 | 4 each | Position X/Y/Z, float32 m |
| 47, 51, 55 | 4 each | Velocity X/Y/Z, float32 m/s |
| 59, 61, 63 | 2 each | LSM6 low-g X/Y/Z, int16 |
| 65 | 2 | LSM6 temperature, int16 |
| 67, 69, 71 | 2 each | LSM6 high-g X/Y/Z, int16 |
| 73, 75, 77 | 2 each | LSM6 gyro X/Y/Z, int16 |
| 79 | 3 | MS5607 pressure, uint24 Pa |
| 82 | 2 | MS5607 temperature, int16 centi-C |
| 84 | 4 | MS5607 altitude, float32 m |
| 88 | 3 | Latitude, int24 |
| 91 | 3 | Longitude, int24 |
| 94 | 4 | GPS Unix time, uint32 s |
| 98 | 4 | GPS altitude, float32 m MSL |
| 102 | 1 | EOF `0x0A` |

MCU temperature, position, velocity and GPS Unix time remain zero. The
quaternion is populated exactly as in `0x02` (same convention; all zero until
the estimator is initialized), so enabling debug output with command `0x00E0`
gives 10 Hz quaternions on USB (LoRa still sends the newest debug frame at its
1 Hz radio rate). GPS latitude, longitude and MSL altitude come from UART1 NMEA
GGA fixes.

### `0xE1` IRIS debug packet, 14 bytes

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

## 4a. HITL (hardware-in-the-loop) mode

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

### `0x0C` HITL sensor input packet, 47 bytes (host to Witness, USB only)

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

## 5. LoRa/RA-01 settings

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

Every valid received radio packet up to the canonical maximum of 103 bytes is
forwarded unchanged to USB. A received packet beginning with `0x05` is also
queued unchanged for Iris CAN transmission and local interpretation. Debug enable,
mass storage, log erase, flight-state and HITL-exit commands execute locally;
HITL enter is rejected over LoRa. Load and
5 V regulator commands have no Witness-local hardware action because they are
implemented by the external device. The GPS UART never receives these
AMA load/regulator commands. SX1262 packets with a CRC error are
discarded.

## 6. Iris CAN and GPS UART1 interfaces

### Iris CAN device link

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

### GPS UART1 receiver

GPS uses UART1; the I2C driver is not started or included in the build.

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

New sessions use storage layout version 2: 10 NAND blocks for sensor data,
40 for external GPS data and 12 for diagnostics, retaining 16 rotating sessions.
The GPS allocation holds up to 5,222,400 raw bytes per session; recording duration
depends on the receiver's actual output rate.
Old version-1 sensor and diagnostic sessions remain readable. No format or
erase is required to upgrade. Buffer overflow or flash write failure sets the
existing flash-log-failed status bit. When a file's allocation fills, that
stream stops with a diagnostic and the other streams continue. These are
finite buffers, not an unlimited lossless recorder.

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

## 7. USB command input

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

```text
05 00 00 00 00 00 00 00 51 0A
```

USB also accepts a newline-terminated ASCII-hex representation:

```text
05 00 00 00 00 00 00 00 51 0A\r\n
```

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

Legacy compact binary commands are accepted after a 20 ms idle interval:

```text
05 68 68       enter mass storage
05 68 69       erase stored sessions
05 73 00..04   set flight state
```

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

## 8. USB stream parsing

USB Serial/JTAG is not currently a telemetry-only channel. It may contain:

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

```python
FRAME_LENGTH = {
    0x01: 23,
    0x02: 65,
    0x03: 19,
    0x05: 10,
    0xE0: 103,
    0xE1: 14,
    0xFF: 8,
    0xF0: 29,  # pre-GPS Aperture firmware sent 13
}

def extract_frames(buffer: bytearray):
    frames = []
    while buffer:
        length = FRAME_LENGTH.get(buffer[0])
        if length is None:
            del buffer[0]
            continue
        if len(buffer) < length:
            break
        if buffer[length - 1] != 0x0A:
            del buffer[0]
            continue
        frames.append(bytes(buffer[:length]))
        del buffer[:length]
    return frames
```

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

## 9. Ground-station transmit checklist

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

## Aperture host input

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

Shared CAN transport reference: [Intercomm](../../../Intercomm/README.md).
