prs2026/Witness/candiagram.png

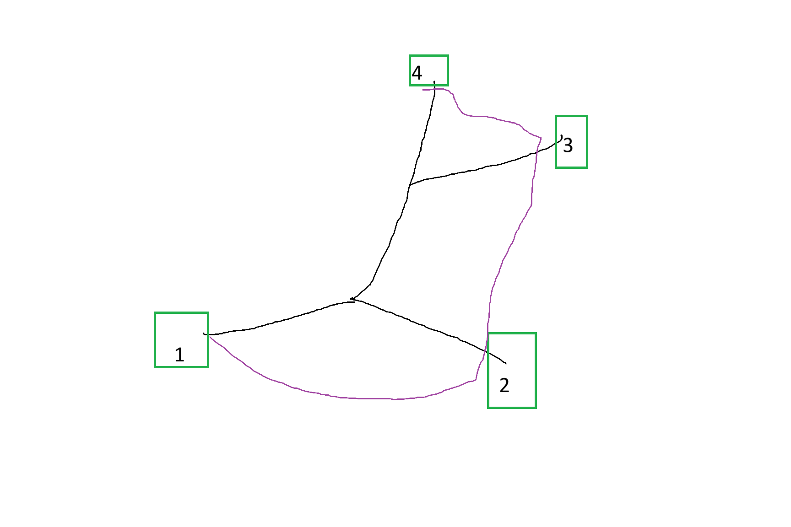
candiagram.png
