prs2026/Witness/Hardware/Backplane/backplane v1/emi_bracket_output/EMI_Bracket_1101008_preview.png

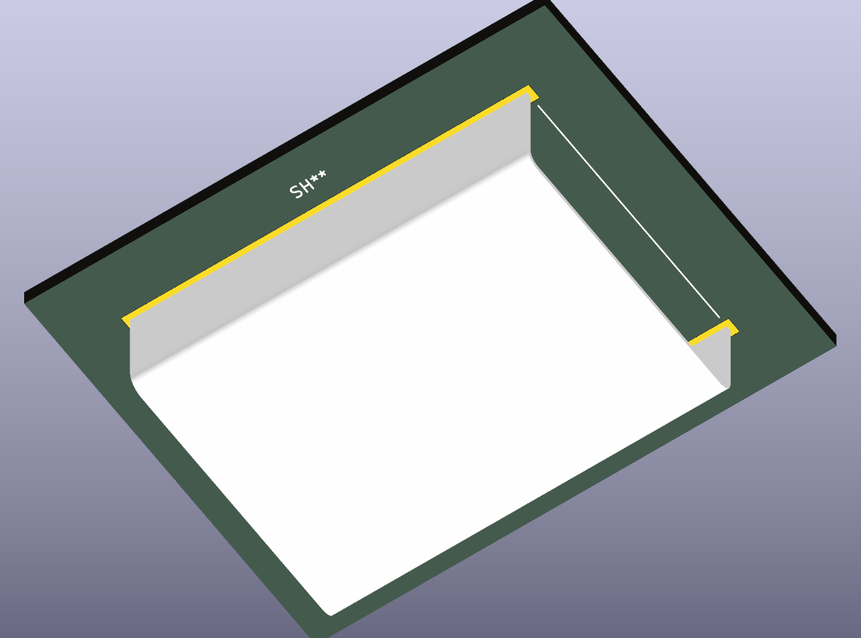
Hardware/Backplane/backplane v1/emi_bracket_output/EMI_Bracket_1101008_preview.png
