prs2026/Witness/Hardware/Backplane/backplane v1/emi_bracket_output/EMI_Bracket_1101008_assembly.step

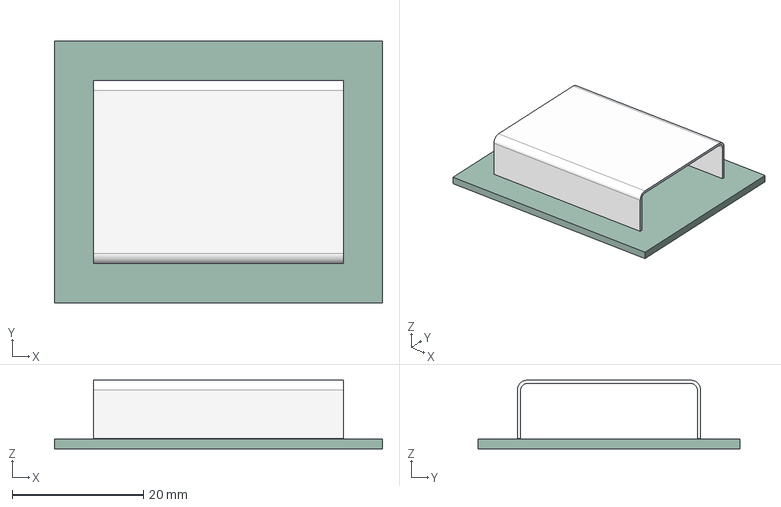
[picture p6: CAD file, 2026-11-05]
Hardware/Backplane/backplane v1/emi_bracket_output/EMI_Bracket_1101008_assembly.step
50.0 x 40.0 x 10.5 mm
1101008 - EMI bracket
EMI_Bracket_1101008_preview_PCB
