prs2026/Witness/Hardware/Backplane/backplane v1/emi_bracket_widened_output/EMI_Bracket_Widened_assembly.step

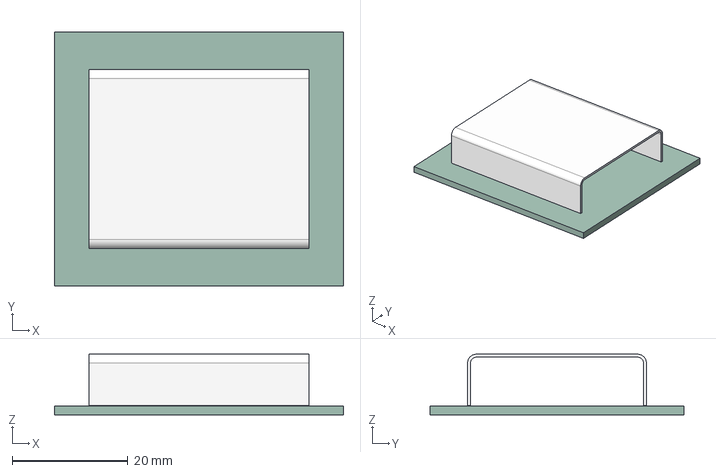
[picture p7: CAD file, 2026-11-05]
Hardware/Backplane/backplane v1/emi_bracket_widened_output/EMI_Bracket_Widened_assembly.step
50.0 x 44.0 x 10.5 mm
1101008 - EMI bracket
EMI_Bracket_Widened_preview_PCB
