prs2026/Witness/Hardware/Backplane/backplane v1/sideon_magswitch_output/sideon_assembly.step

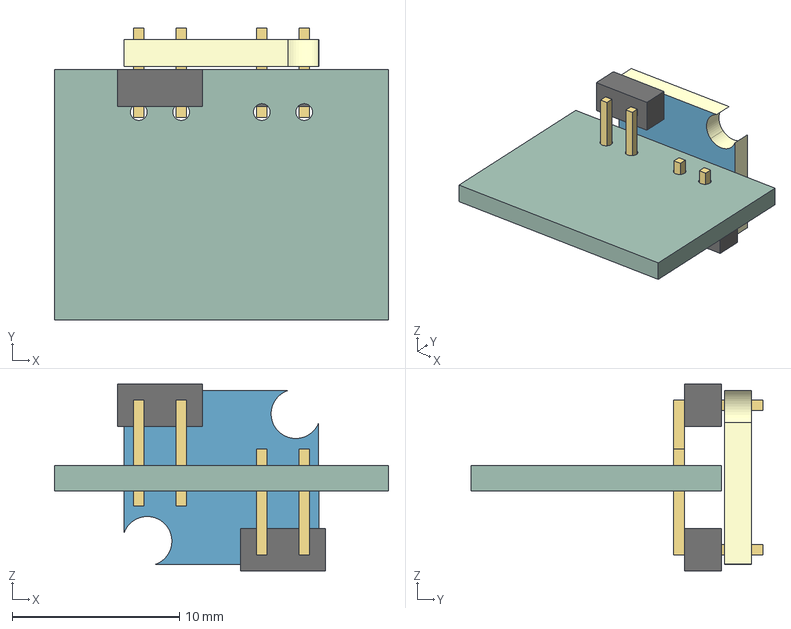
[picture p8: CAD file, 2026-11-04]
Hardware/Backplane/backplane v1/sideon_magswitch_output/sideon_assembly.step
20.0 x 17.5 x 11.2 mm
TopTrack
BottomTrack
Board
Dual right-angle headers
sideon_preview_PCB
