prs2026/Witness/Hardware/Breakouts/ubloxm8breakout/ubloxbreakout.step

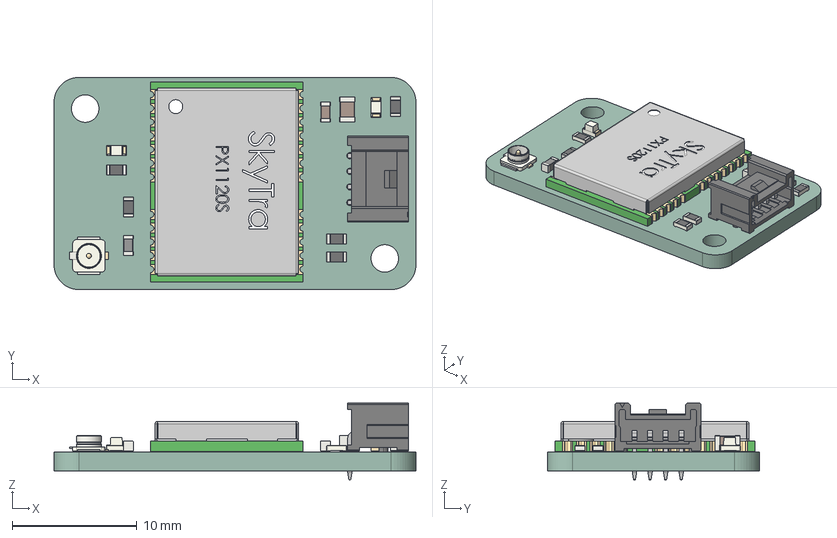
[picture p10: CAD file, 2026-11-05]
Hardware/Breakouts/ubloxm8breakout/ubloxbreakout.step
29.0 x 17.0 x 6.15 mm
LED_0603_1608Metric x 2
R_0603_1608Metric x 5
L_0603_1608Metric
C_0603_1608Metric
U.FL_Hirose_U.FL-R-SMT-1_Vertical
C_0805_2012Metric
ubloxm8breakout_PCB
