prs2026/Witness/Hardware/KicadLibs/1101 - Nosecone - 1101008 - EMI bracket(1).step

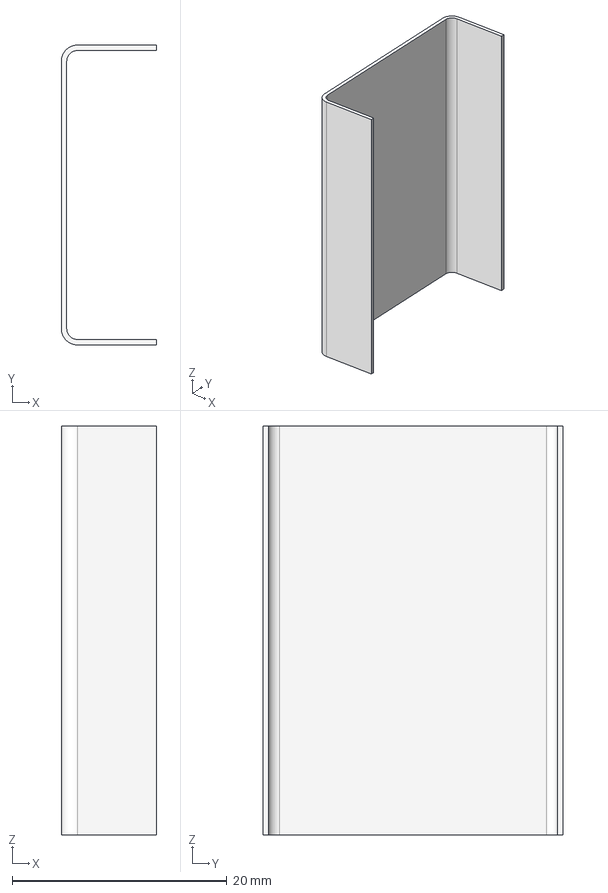
[picture p11: CAD file, 2026-11-05]
Hardware/KicadLibs/1101 - Nosecone - 1101008 - EMI bracket(1).step
8.89 x 27.9 x 38.1 mm
