prs2026/Witness/Hardware/R2/IRIS R2/1101 - Nosecone - 1101005 - Foward Sled.dxf

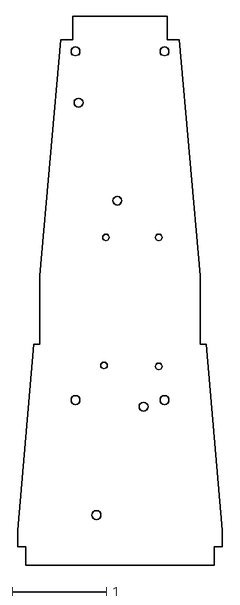
[picture p12: CAD file, 2026-11-04]
Hardware/R2/IRIS R2/1101 - Nosecone - 1101005 - Foward Sled.dxf
2.17 x 5.83
