prs2026/Witness/Hardware/witnessv0.2/witness/witnessv0.2.step

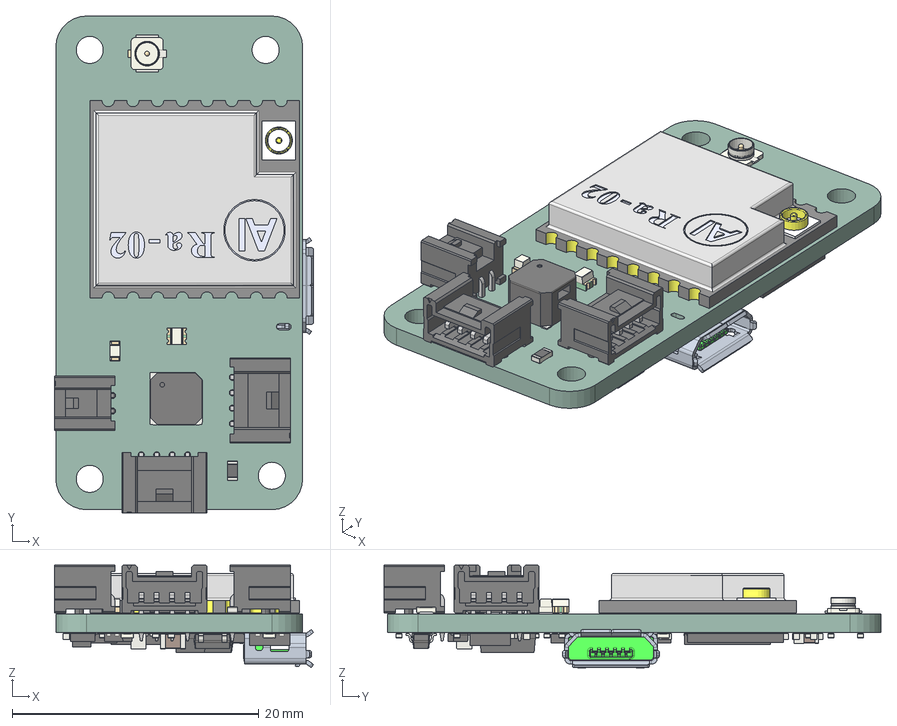
[picture p13: CAD file, 2026-09-03]
Hardware/witnessv0.2/witness/witnessv0.2.step
21.0 x 40.3 x 8.31 mm
User_Library-RA-02__Imported1
U.FL_Hirose_U.FL-R-SMT-1_Vertical
R_0603_1608Metric
LED_RGB_1210
PUIAudio_SMT_0825_S_4_R
LED_0603_1608Metric
C_0402_1005Metric x 16
WSON-8-1EP_6x5mm_P1.27mm_EP3.4x4.3mm
R_0402_1005Metric x 20
VSON_8_33x33mm_Pitch065mm_NexFET
A4A0504-MODIFY-1106_ASM
C_0603_1608Metric x 2
SOT-23
a48c614c-8773-11ed-8f9d-58fb8493fcfb_part
a48c63fe-8773-11ed-8f9d-58fb8493fcfb_part
a48c65a2-8773-11ed-8f9d-58fb8493fcfb_part
a48c66d8-8773-11ed-8f9d-58fb8493fcfb_part
DFN-6-1EP_2x2mm_Pitch0.65mm x 2
LGA_8_3x5mm_P125mm
D_SOD_123F
C_0805_2012Metric x 2
D_SOD_523 x 2
L_0402_1005Metric
Bosch_LGA_14_3x25mm_P05mm
adbeea57-9c39-11ed-93f0-dde97e994e83_part
adbeea58-9c39-11ed-93f0-dde97e994e83_part
adbeea59-9c39-11ed-93f0-dde97e994e83_part
Oscillator_SMD_SeikoEpson_SG210-4Pin_2.5x2.0mm
SOT-23-6
witness_PCB
