prs2026/Witness/Hardware/KicadLibs/GPS Tracker 2.step

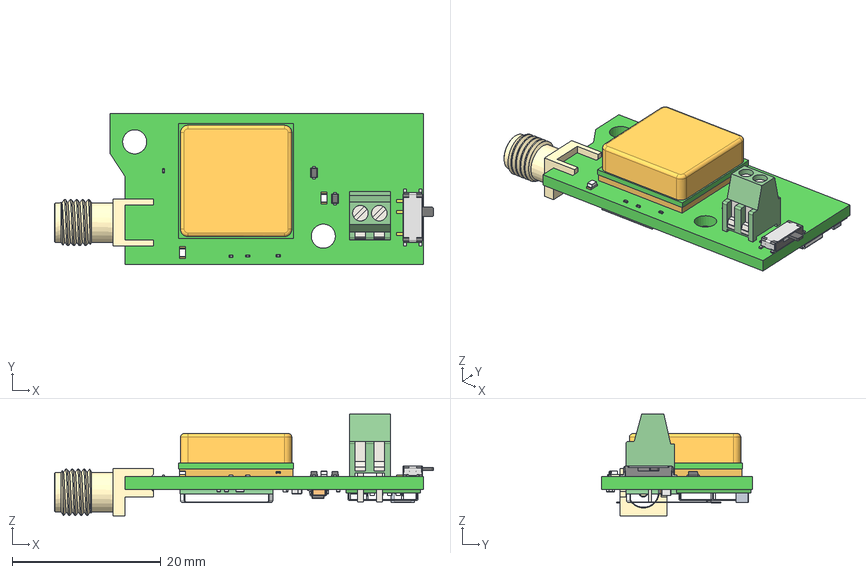
[picture p14: CAD file, 2026-11-05]
Hardware/KicadLibs/GPS Tracker 2.step
51.0 x 20.3 x 13.7 mm
Wire Terminal 2 Pin v4:1__Body2
SOD-523 v1:1__Body1 x 2
Part 2:1__Body1 x 19
Part 3:1__Body1 x 19
Part 1:1__Body1 x 19
SAMTEC_SMA-J-P-H-ST-EM1 v2:1__Body2
SAMTEC_SMA-J-P-H-ST-EM1 v2:1__Body3
SAMTEC_SMA-J-P-H-ST-EM1 v2:1__Body1
SOT23-5 v1:1__Body5
SOT23-5 v1:1__Body3
SOT23-5 v1:1__Body2
SOT23-5 v1:1__Body1
SOT23-5 v1:1__Body6
SOT23-5 v1:1__Body4
Part 4:1__Body1 x 12
Part 6:1__Body1 x 12
Part 5:1__Body1 x 12
PCB:1__Body1
Shield:1__Body2
Label:1__Body1
0603 v1:1__Body3 x 2
0603 v1:1__Body2 x 2
0603 v1:1__Body1 x 2
SOT-666 v1:1__Body1
_CUS-12-body:1__Body1
_CUS-12-slider:1__Body1
SAM-MQ8-0-10 v1:1__13
SAM-MQ8-0-10 v1:1__2
SAM-MQ8-0-10 v1:1__19
SAM-MQ8-0-10 v1:1__6
SAM-MQ8-0-10 v1:1__15
SAM-MQ8-0-10 v1:1__10
SAM-MQ8-0-10 v1:1__4
SAM-MQ8-0-10 v1:1__1
SAM-MQ8-0-10 v1:1__12
SAM-MQ8-0-10 v1:1__3
SAM-MQ8-0-10 v1:1__Substrate
SAM-MQ8-0-10 v1:1__7
SAM-MQ8-0-10 v1:1__8
SAM-MQ8-0-10 v1:1__Antenna
SAM-MQ8-0-10 v1:1__9
SAM-MQ8-0-10 v1:1__14
SAM-MQ8-0-10 v1:1__18
SAM-MQ8-0-10 v1:1__11
SAM-MQ8-0-10 v1:1__5
SAM-MQ8-0-10 v1:1__PCB
SAM-MQ8-0-10 v1:1__16
SAM-MQ8-0-10 v1:1__20
SAM-MQ8-0-10 v1:1__17
Cap0603x030(0201):1__Body1 x 15
L0603x033(0201):1__Body1 x 2
Sheild:1__Body1
Xtal 2.5x2.0x0:1__Body6
Xtal 2.5x2.0x0:1__Body3
Xtal 2.5x2.0x0:1__Body5
Xtal 2.5x2.0x0:1__Body2
Xtal 2.5x2.0x0:1__Body1
Xtal 2.5x2.0x0:1__Body4
Xtal 1.6x1.0x0:1__Body3
Xtal 1.6x1.0x0:1__Body4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
