prs2026/Witness/Hardware/R2/IRIS R2/irisv0.2.step

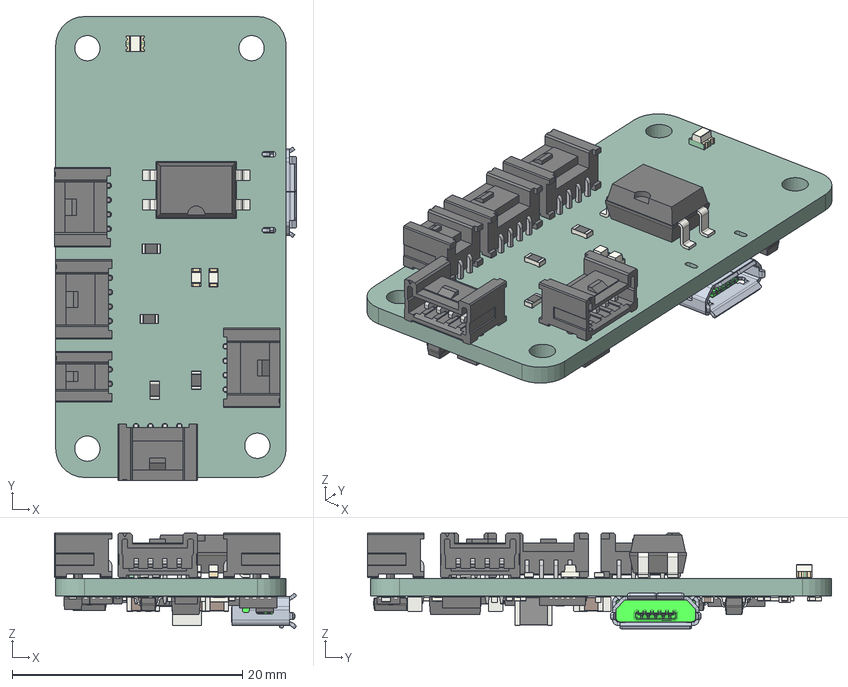
[picture p15: CAD file, 2026-09-03]
Hardware/R2/IRIS R2/irisv0.2.step
21.0 x 40.3 x 8.31 mm
R_0603_1608Metric x 7
SMDIP_4_W953mm
LED_RGB_1210
LED_0603_1608Metric x 2
R_0402_1005Metric x 34
C_0805_2012Metric x 7
DFN-6-1EP_2x2mm_Pitch0.65mm x 5
VSON_8_33x33mm_Pitch065mm_NexFET
C_0402_1005Metric x 13
C_0603_1608Metric x 2
A4A0504-MODIFY-1106_ASM
D_SOD_523
SOT-23 x 2
QFN-20-1EP_4x4mm_Pitch0.5mm
WSON-8-1EP_6x5mm_P1.27mm_EP3.4x4.3mm
QFN-32-1EP_5x5mm_P0.5mm_EP3.7x3.7mm
D_SOD_123F
QFN-24-1EP_4x4mm_Pitch0.5mm
L_1210_3225Metric
adbeea57-9c39-11ed-93f0-dde97e994e83_part
adbeea58-9c39-11ed-93f0-dde97e994e83_part
adbeea59-9c39-11ed-93f0-dde97e994e83_part
Oscillator_SMD_SeikoEpson_SG210-4Pin_2.5x2.0mm
SOT-23-6
iris_PCB
