prs2026/Witness/Hardware/Backplane/backplane v1/avsled.step

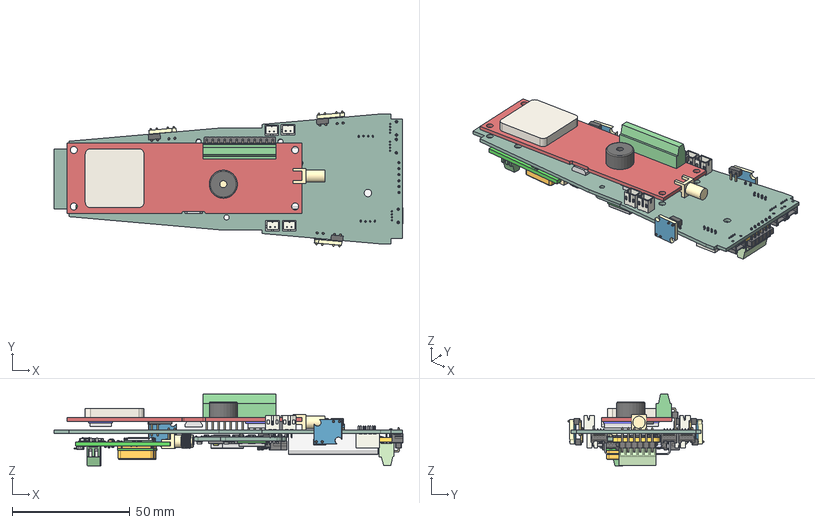
[picture p16: CAD file, 2026-11-05]
Hardware/Backplane/backplane v1/avsled.step
148.2 x 57.7 x 30.4 mm
JST_B2B_PH_K x 4
Boss-Extrude16
PinHeader_1x12_P254mm_Horizontal
TopTrack x 3
BottomTrack x 3
Board x 3
Dual right-angle headers x 3
1101008 - EMI bracket
LED_0603_1608Metric x 3
L_0603_1608Metric
C_0603_1608Metric x 3
R_0603_1608Metric x 4
U.FL_Hirose_U.FL-R-SMT-1_Vertical x 2
ubloxm8breakout_PCB
JST_B4B_PH_K x 2
a48c65a2-8773-11ed-8f9d-58fb8493fcfb_part x 57
SOT-23
C_0402_1005Metric_1
R_0402_1005Metric_3
R_0402_1005Metric_1
LGA_8_3x5mm_P125mm
R_0402_1005Metric_7
R_0402_1005Metric_2
a48c66d8-8773-11ed-8f9d-58fb8493fcfb_part
Oscillator_SMD_SeikoEpson_SG210-4Pin_2.5x2.0mm x 8
C_0402_1005Metric_10
C_0805_2012Metric_1
PUIAudio_SMT_0825_S_4_R
WSON-8-1EP_6x5mm_P1.27mm_EP3.4x4.3mm
R_0402_1005Metric_18
R_0402_1005Metric_5
SOT-23-6
C_0402_1005Metric_6
C_0805_2012Metric
R_0402_1005Metric_8
C_0402_1005Metric_8
witness_PCB
DFN-6-1EP_2x2mm_Pitch0.65mm
C_0402_1005Metric_2
R_0402_1005Metric_15
C_0402_1005Metric_13
R_0402_1005Metric_14
D_SOD_523
R_0402_1005Metric_13
R_0402_1005Metric_11
R_0402_1005Metric_12
R_0402_1005Metric_4
C_0402_1005Metric_15
adbeea58-9c39-11ed-93f0-dde97e994e83_part
C_0402_1005Metric_11
L_0402_1005Metric
R_0402_1005Metric_16
C_0402_1005Metric
C_0402_1005Metric_7
C_0402_1005Metric_4
LED_RGB_1210
C_0402_1005Metric_12
VSON_8_33x33mm_Pitch065mm_NexFET
adbeea57-9c39-11ed-93f0-dde97e994e83_part
adbeea59-9c39-11ed-93f0-dde97e994e83_part x 3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
