prs2026/Witness/Hardware/KicadLibs/gpsbreakout.step

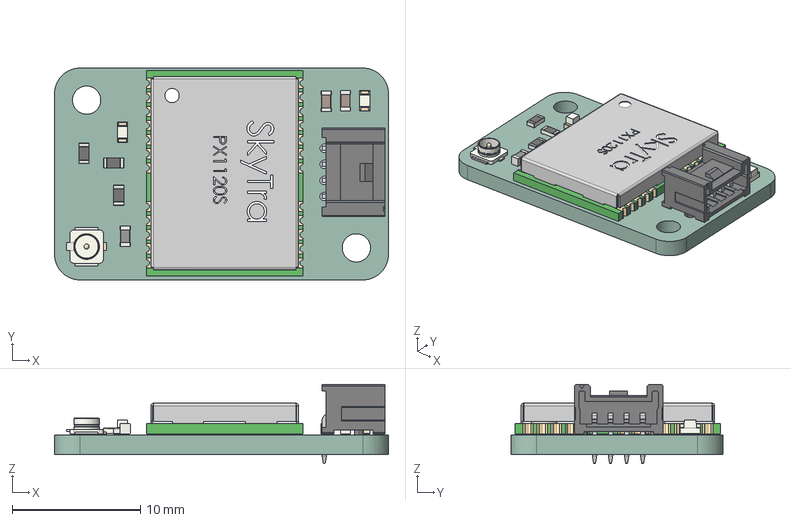
[picture p17: CAD file, 2026-11-05]
Hardware/KicadLibs/gpsbreakout.step
26.0 x 16.5 x 6.15 mm
LED_0603_1608Metric x 2
L_0603_1608Metric
C_0603_1608Metric x 2
R_0603_1608Metric x 3
U.FL_Hirose_U.FL-R-SMT-1_Vertical
ubloxm8breakout_PCB
