prs2026/Witness/Hardware/R2/IRIS R2/witnessv0.2.step

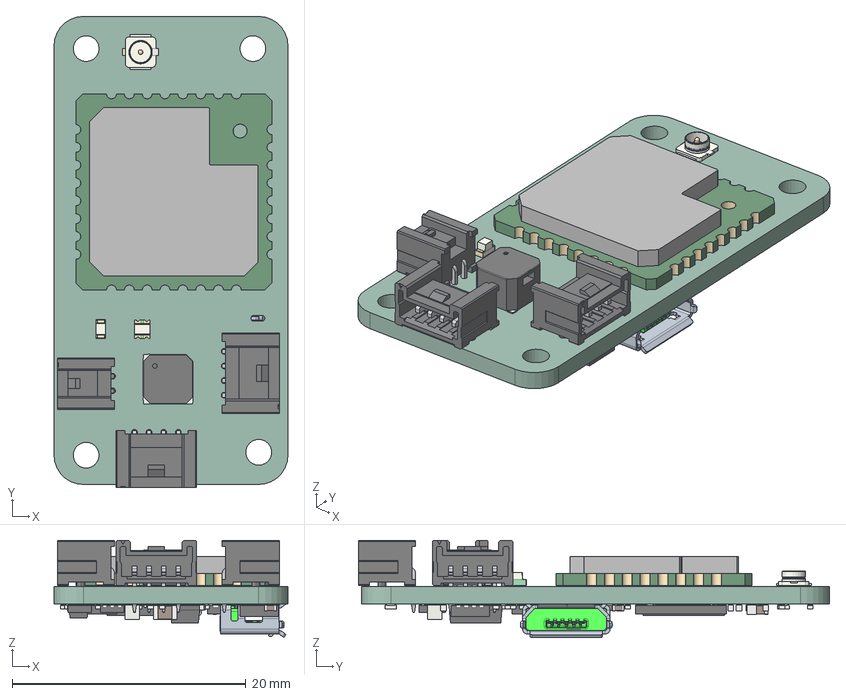
[picture p18: CAD file, 2026-09-01]
Hardware/R2/IRIS R2/witnessv0.2.step
20.0 x 40.3 x 8.31 mm
MonoWireless_TWE-L-WX
U.FL_Hirose_U.FL-R-SMT-1_Vertical
LED_RGB_1210
PUIAudio_SMT_0825_S_4_R
LED_0603_1608Metric
C_0402_1005Metric x 15
WSON-8-1EP_6x5mm_P1.27mm_EP3.4x4.3mm
R_0402_1005Metric x 18
VSON_8_33x33mm_Pitch065mm_NexFET
C_0603_1608Metric x 2
A4A0504-MODIFY-1106_ASM
a48c614c-8773-11ed-8f9d-58fb8493fcfb_part
a48c63fe-8773-11ed-8f9d-58fb8493fcfb_part
a48c65a2-8773-11ed-8f9d-58fb8493fcfb_part
a48c66d8-8773-11ed-8f9d-58fb8493fcfb_part
DFN-6-1EP_2x2mm_Pitch0.65mm x 2
LGA_8_3x5mm_P125mm
D_SOD_123F
C_0805_2012Metric x 2
L_0402_1005Metric
Bosch_LGA_14_3x25mm_P05mm
adbeea57-9c39-11ed-93f0-dde97e994e83_part
adbeea58-9c39-11ed-93f0-dde97e994e83_part
adbeea59-9c39-11ed-93f0-dde97e994e83_part
Oscillator_SMD_SeikoEpson_SG210-4Pin_2.5x2.0mm
SOT-23-6
wit56DC_PCB
