prs2026/Witness/Hardware/Backplane/backplane v1/bluraven_2025_v9 - 16-copper-1__Body1.step

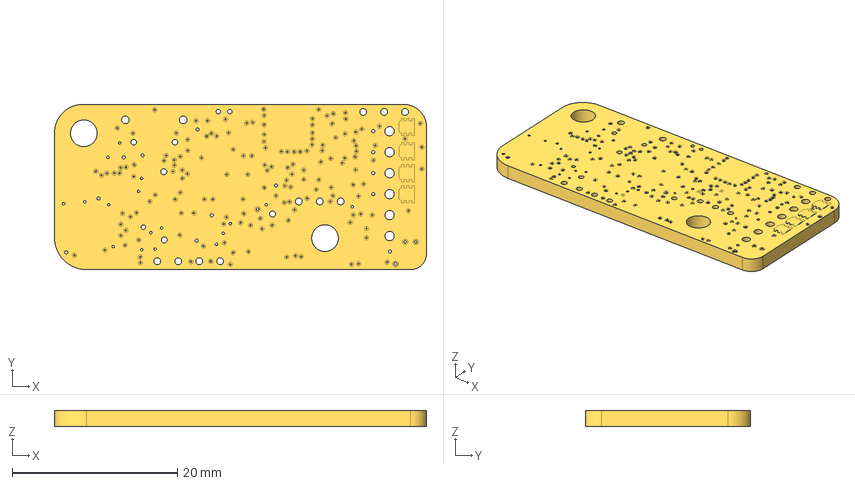
[picture p19: CAD file, 2026-11-04]
Hardware/Backplane/backplane v1/bluraven_2025_v9 - 16-copper-1__Body1.step
45.1 x 20.0 x 1.99 mm
