prs2026/Witness/Hardware/Backplane/backplane v1/GPS Tracker v15 parts - FWGPS.step

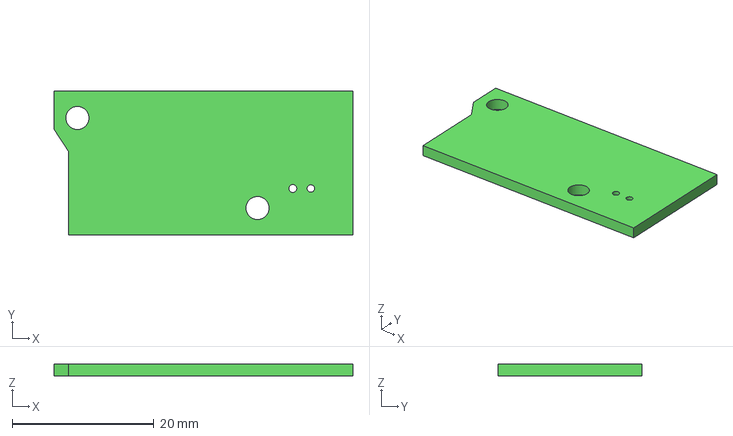
[picture p20: CAD file, 2026-11-04]
Hardware/Backplane/backplane v1/GPS Tracker v15 parts - FWGPS.step
42.2 x 20.3 x 1.73 mm
