prs2026/Witness/Hardware/KicadLibs/Blue Raven.step

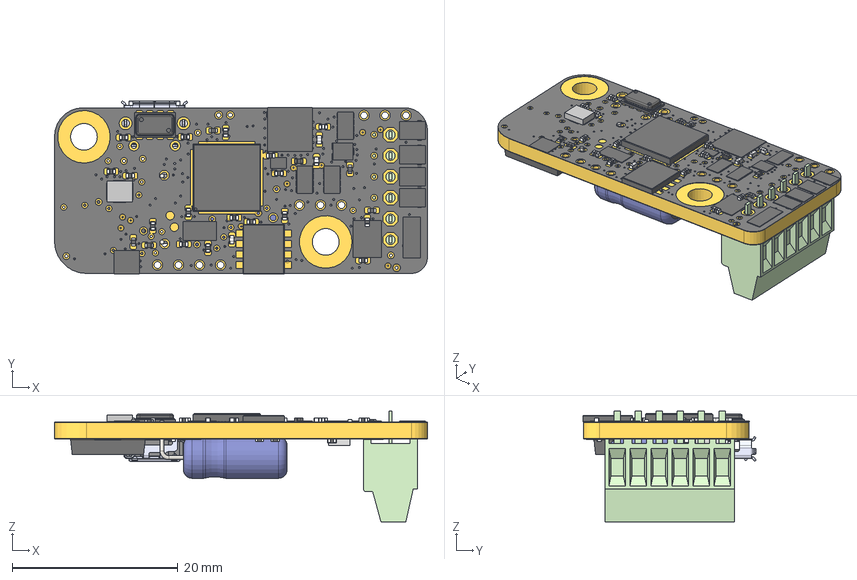
[picture p22: CAD file, 2026-11-04]
Hardware/KicadLibs/Blue Raven.step
45.1 x 20.9 x 13.4 mm
Model:1__Body2_10
Model:1__Body2_11
Model:1__Body1_19
Model (1):1__Body2_1
1-soldermask:1__Body1 x 2
Model:1__Body3_14
Model:1__Body2_2
Model:1__Body1_7
10118194-0001LF v1:1__Body13
Model (5):1__Body7
Model (4):1__Body1
Model:1__Body1_4
Model:1__Body3_23
Model:1__Body3_5
Model:1__Body2_7
Model:1__Body2_6
3P2X1P5:X2__Body1
10118194-0001LF v1:1__Body5
Model (5):1__Body2
Model:1__Body3_17
603X4:R16__Body1_1
2X3_CHIPFET:Q2__Body1 x 2
c-ms560702ba03-50-a-3d v1:1__Body1
Model (1):1__Body3_3
Model:1__Body1_1
Model:1__Body3_11
SOT23-5L:U5__Body1
WQFN14_BQA_TEX v1:1__Body16
10118194-0001LF v1:1__Body10
16-copper:1__Body1
Model (1):1__Body3_1
Model:1__Body1_13
10118194-0001LF v1:1__Body14
Model:1__Body3_18
Model (1):1__Body2_3
LED-0603:BLUE__Body1 x 3
Model (1):1__Body3_5
Model (5):1__Body4
Model:1__Body3_9
603X4:R16__Body1 x 2
Model (6):1__Body1
Model (1):1__Body3_6
10118194-0001LF v1:1__Body8
Model (1):1__Body1_7
Model:1__Body1_3
NN02-101_MID:A1__Body1
Model:1__Body1_21
10118194-0001LF v1:1__Body7
Model (5):1__Body8
Model (1):1__Body1
Model (4):1__Body3
Model:1__Body2_15
Model:1__Body3_13
Model (1):1__Body1_6
Model:1__Body2_4
Model (1):1__Body3_4
Model:1__Body3_10
Model:1__Body1_20
Model (5):1__Body6
282834-6 v1:1__Body18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
