prs2026/Witness/Hardware/KicadLibs/AIM_XTRA_4.0_No_Antenna - Boss-Extrude16.step

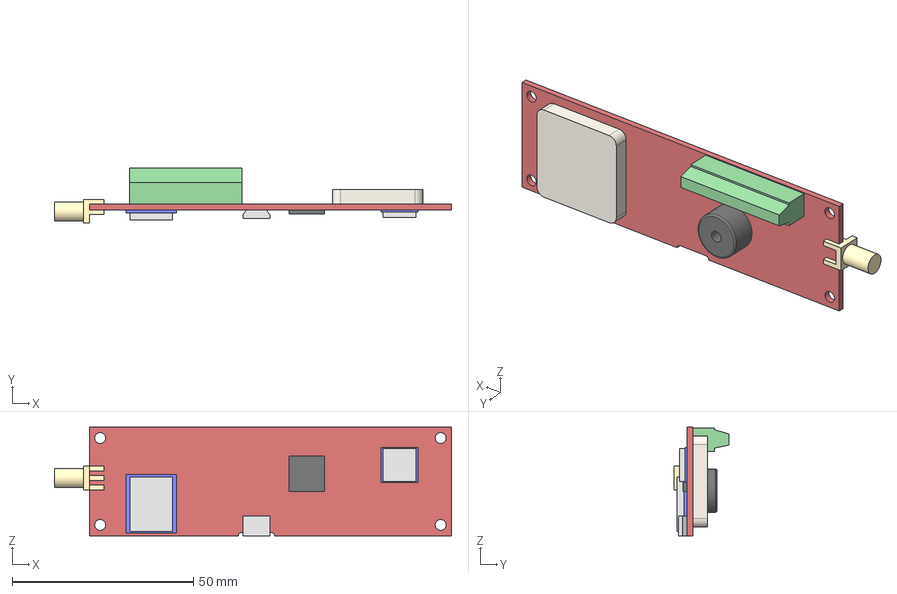
[picture p23: CAD file, 2026-11-04]
Hardware/KicadLibs/AIM_XTRA_4.0_No_Antenna - Boss-Extrude16.step
109.6 x 15.2 x 30.0 mm
