prs2026/Witness/Hardware/KicadLibs/PX1120S.STEP

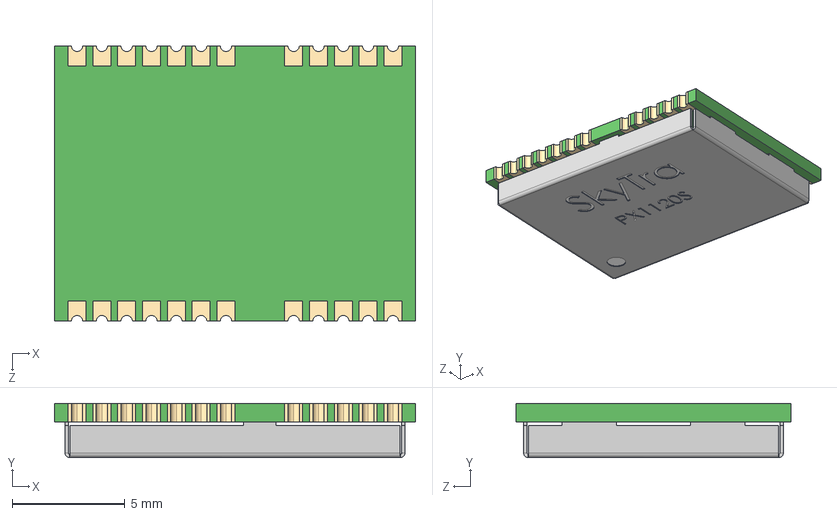
[picture p24: CAD file, 2026-11-01]
Hardware/KicadLibs/PX1120S.STEP
16.0 x 2.40 x 12.2 mm
