prs2026/Witness/Hardware/KicadLibs/User Library-l86-1.STEP

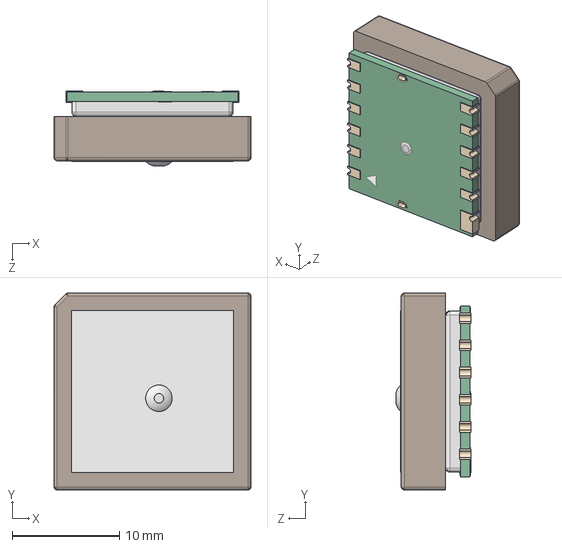
[picture p25: CAD file, 2026-09-06]
Hardware/KicadLibs/User Library-l86-1.STEP
18.4 x 18.4 x 7.05 mm
