prs2026/Witness/Hardware/KicadLibs/RA-01 SH.step

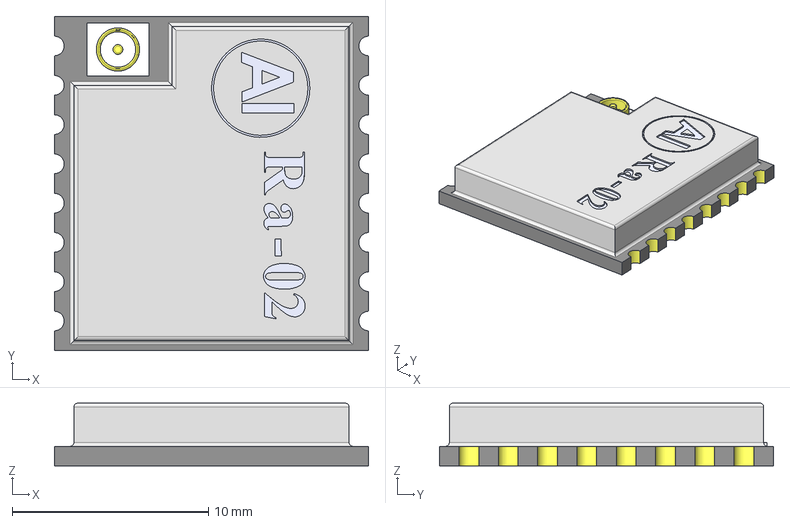
[picture p26: CAD file, 2026-09-03]
Hardware/KicadLibs/RA-01 SH.step
16.0 x 17.0 x 3.20 mm
