prs2026/Witness/Hardware/KicadLibs/Micro SD Card.STEP

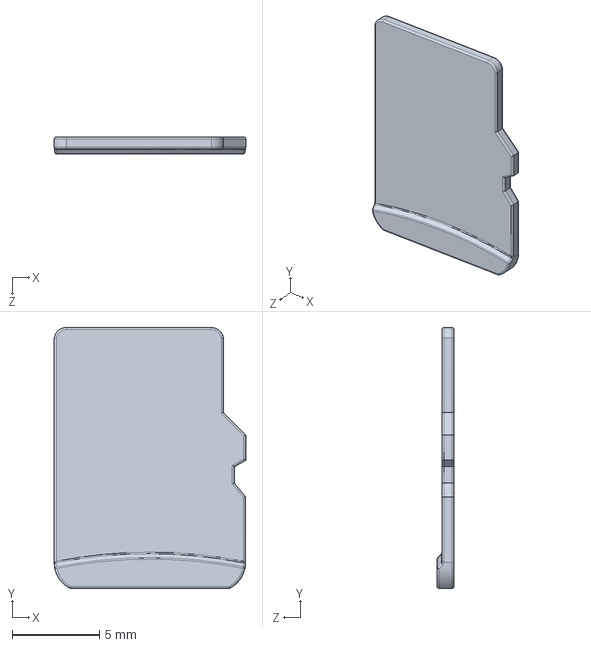
[picture p27: CAD file, 2026-08-29]
Hardware/KicadLibs/Micro SD Card.STEP
11.0 x 15.0 x 1.00 mm
