prs2026/Witness/(list of files, cad)

Other CAD files:
Hardware/Backplane/backplane v1/backplane.step
Hardware/KicadLibs/GPS Tracker.step
Hardware/Backplane/backplane v1/emi_bracket_widened_output/1101008_EMI_Bracket_Wide_30.94mm.step
Hardware/KicadLibs/10118193-0001lfc.stp
Hardware/KicadLibs/10164359-00011LF.STEP
Hardware/KicadLibs/2200980271.stp
Hardware/KicadLibs/2200980471.stp
