prs2026/Witness/Software/Witness/softwarev1/build/px1120s_eval.jpg

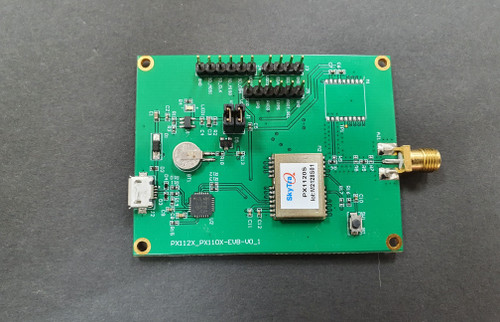
Software/Witness/softwarev1/build/px1120s_eval.jpg
