prs2026/Witness/Hardware/R2/IRIS R2/irisv0.2.pdf

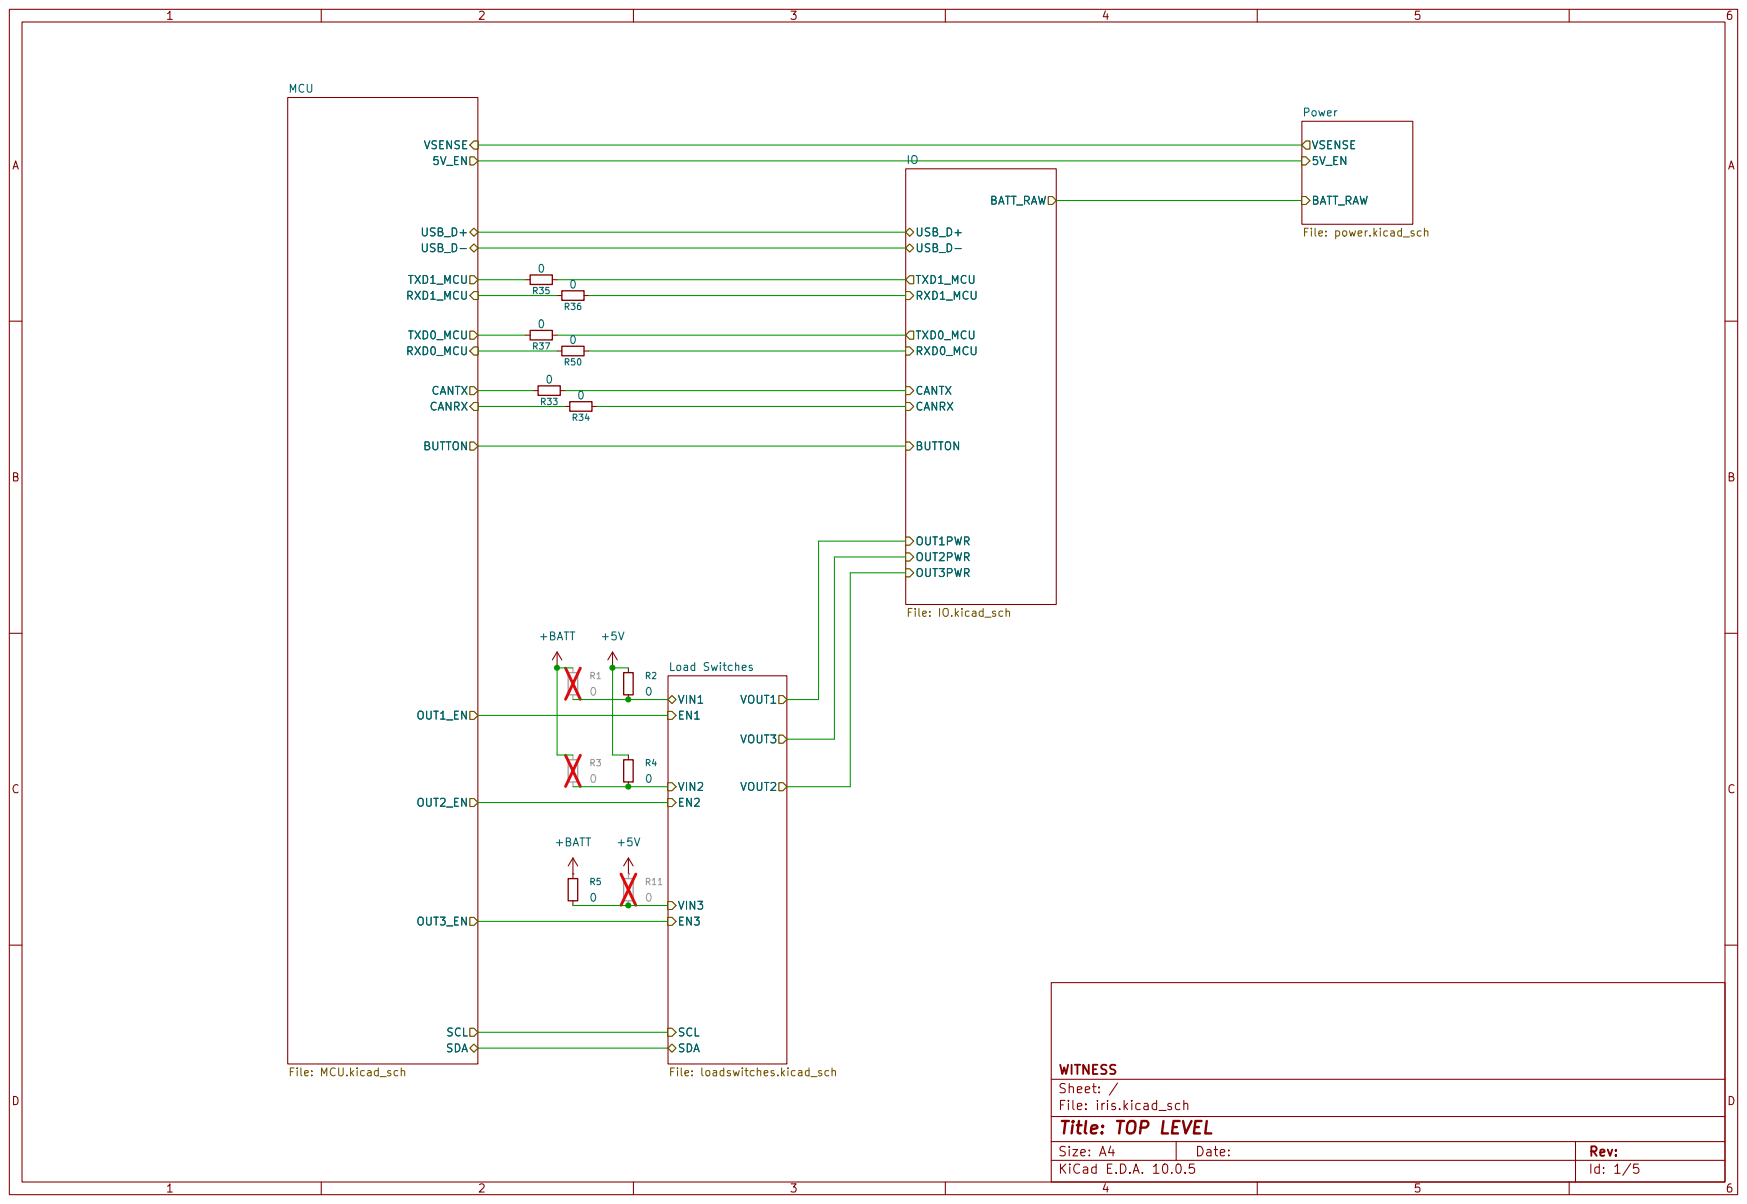
[picture p29: page 1]

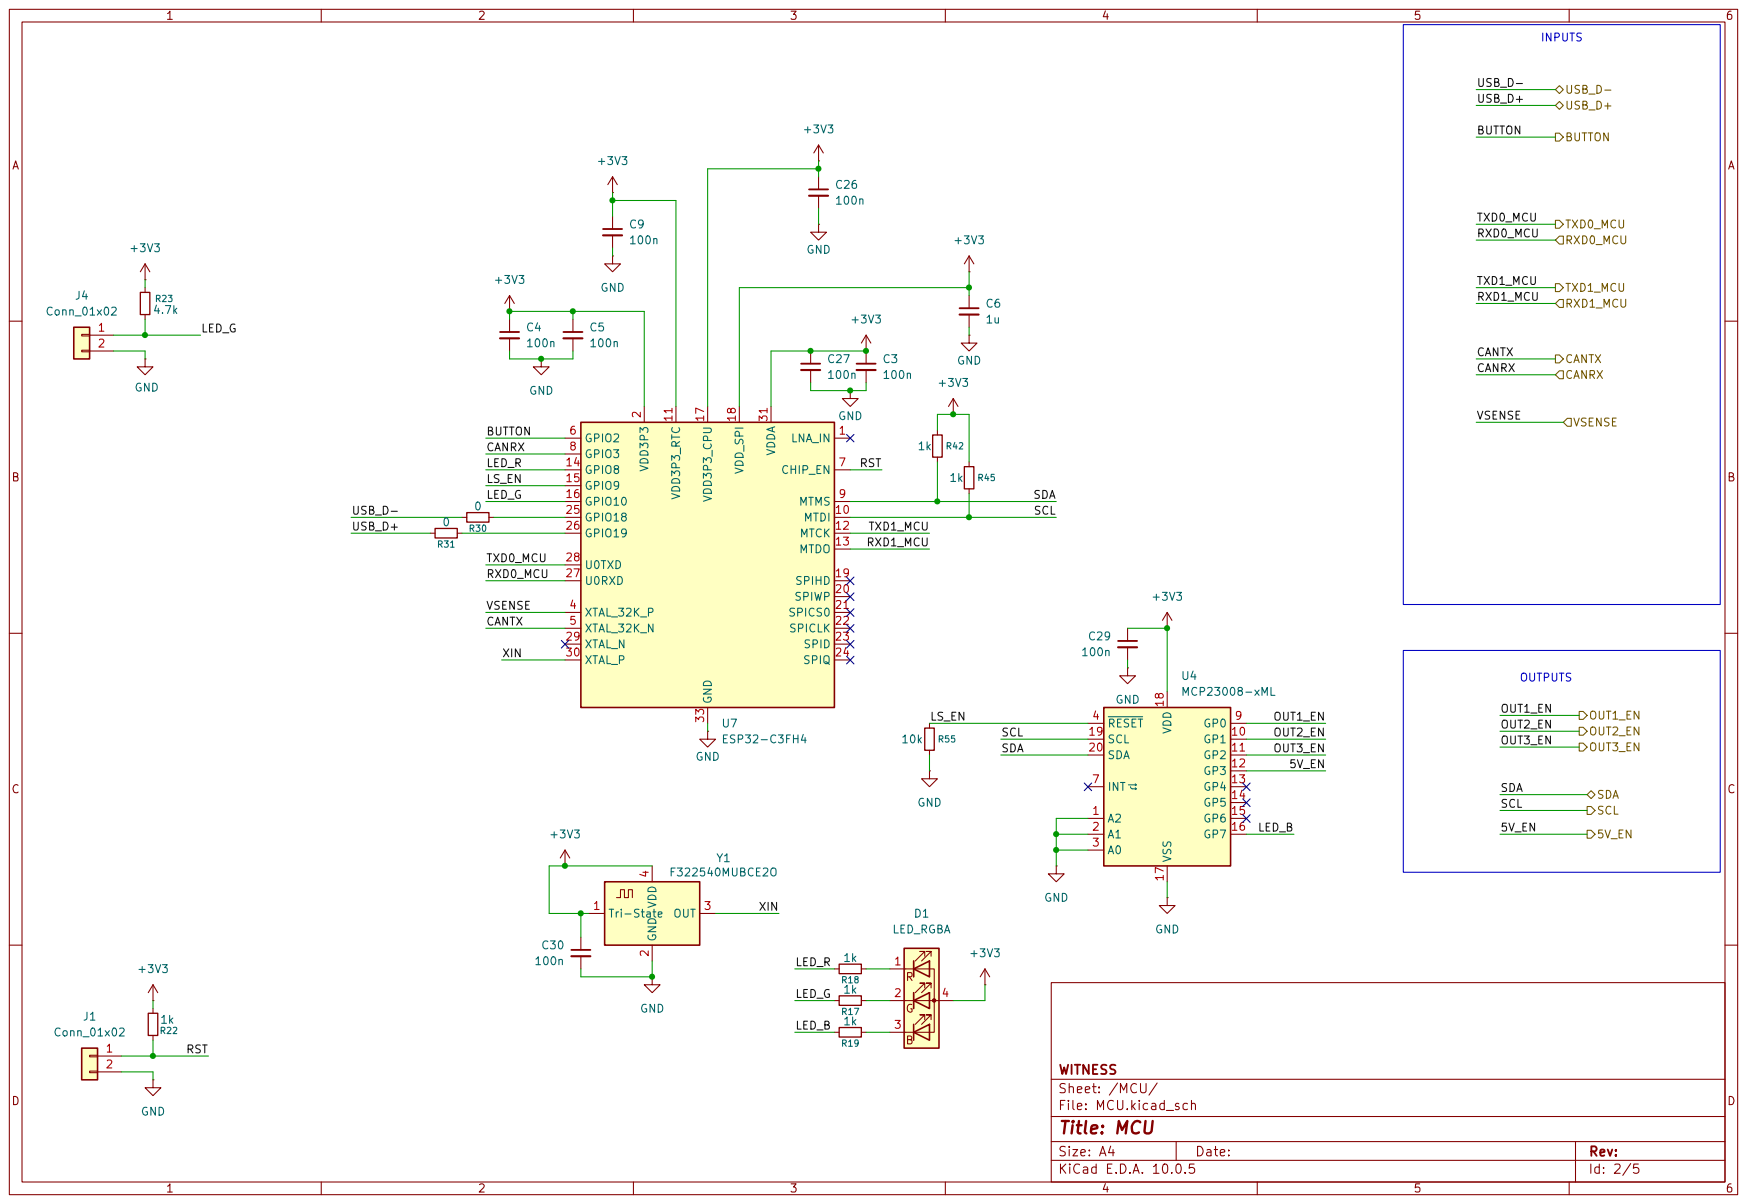
[picture p30: page 2]

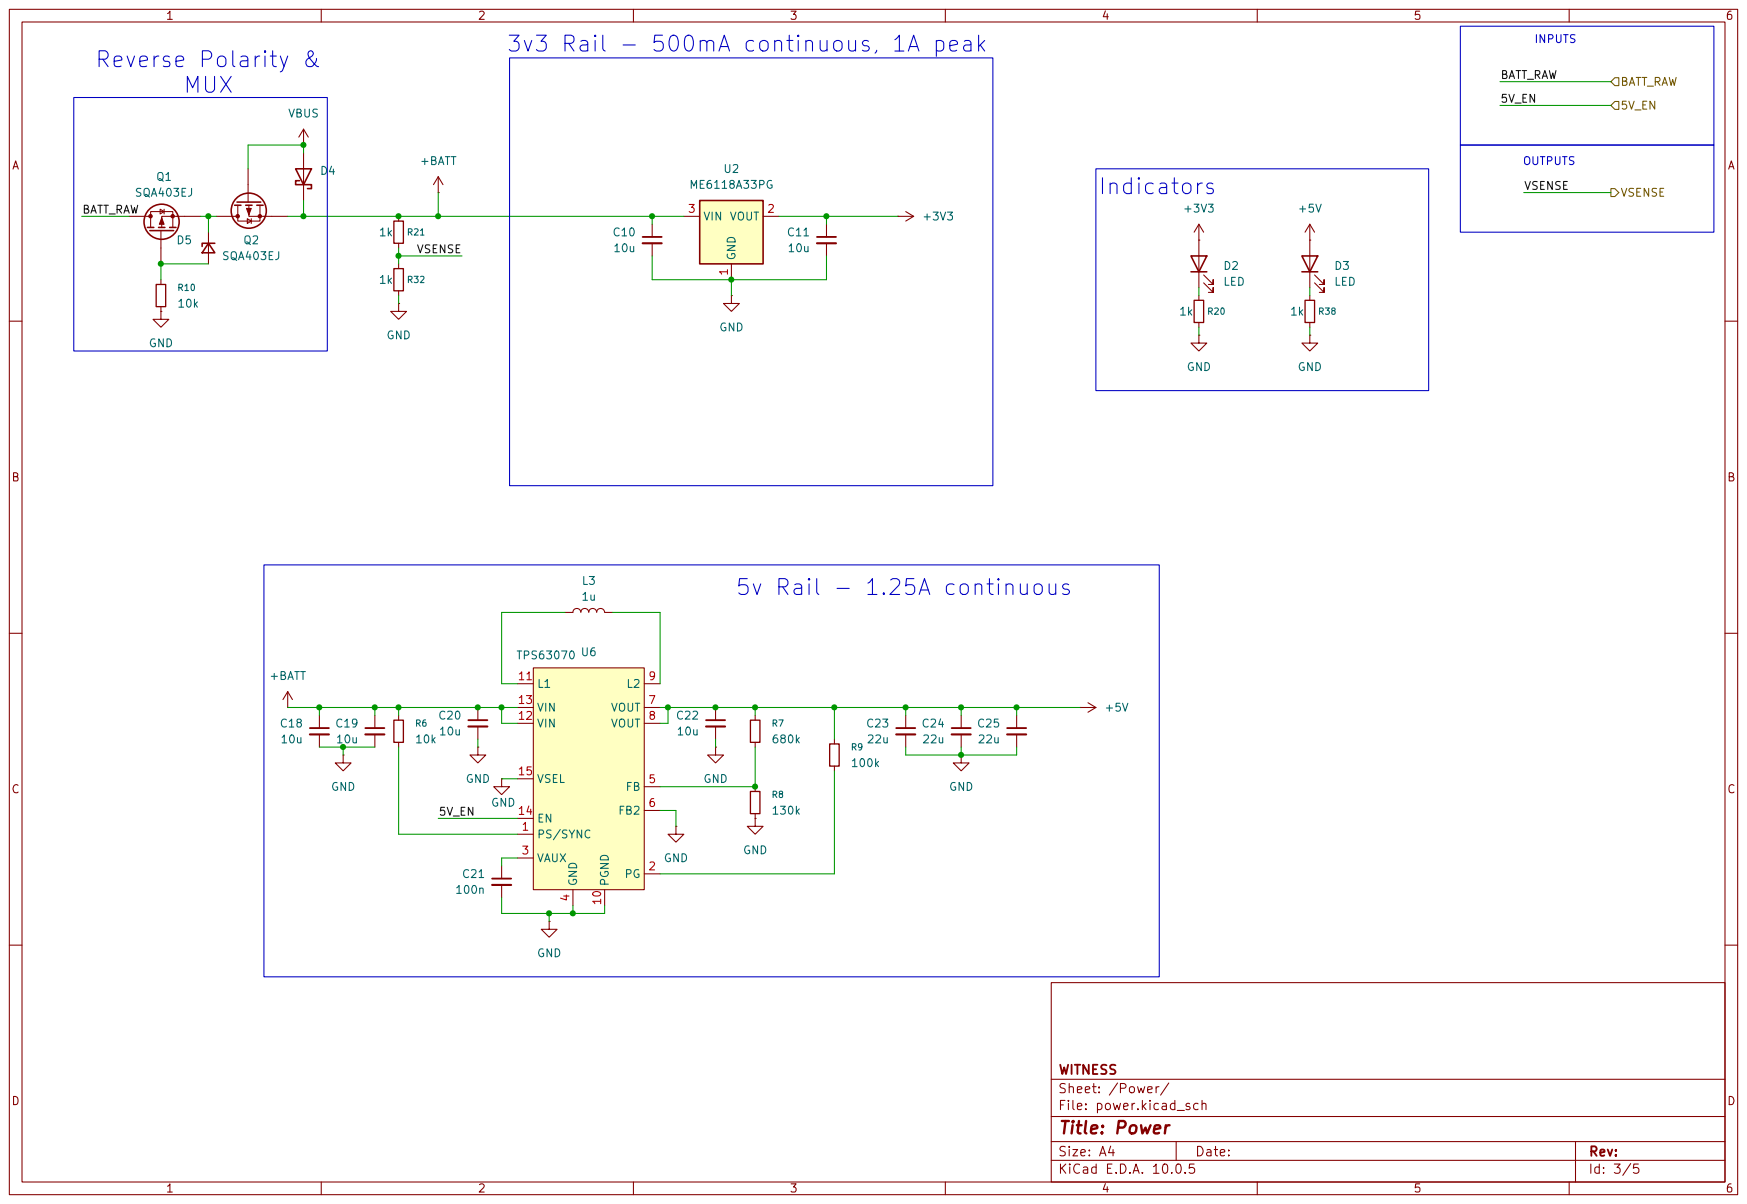
[picture p31: page 3]

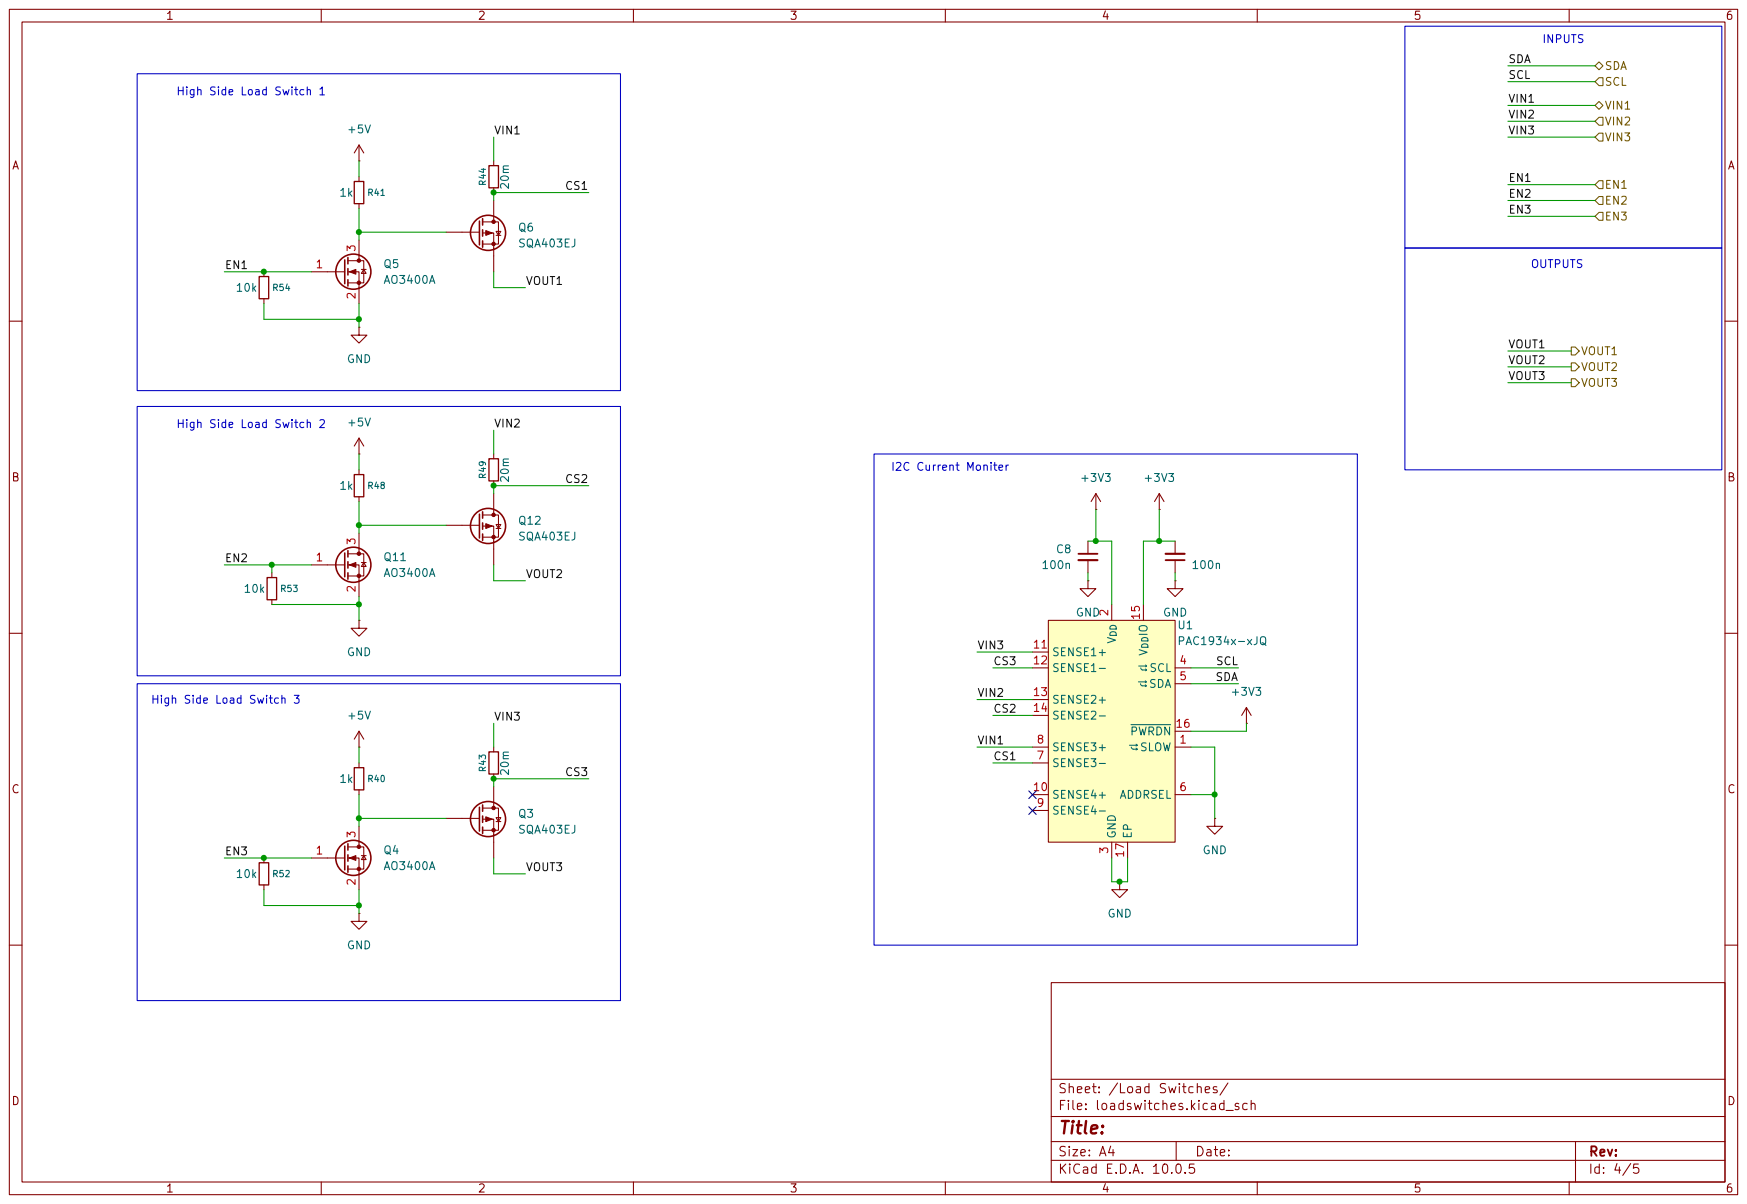
[picture p32: page 4]

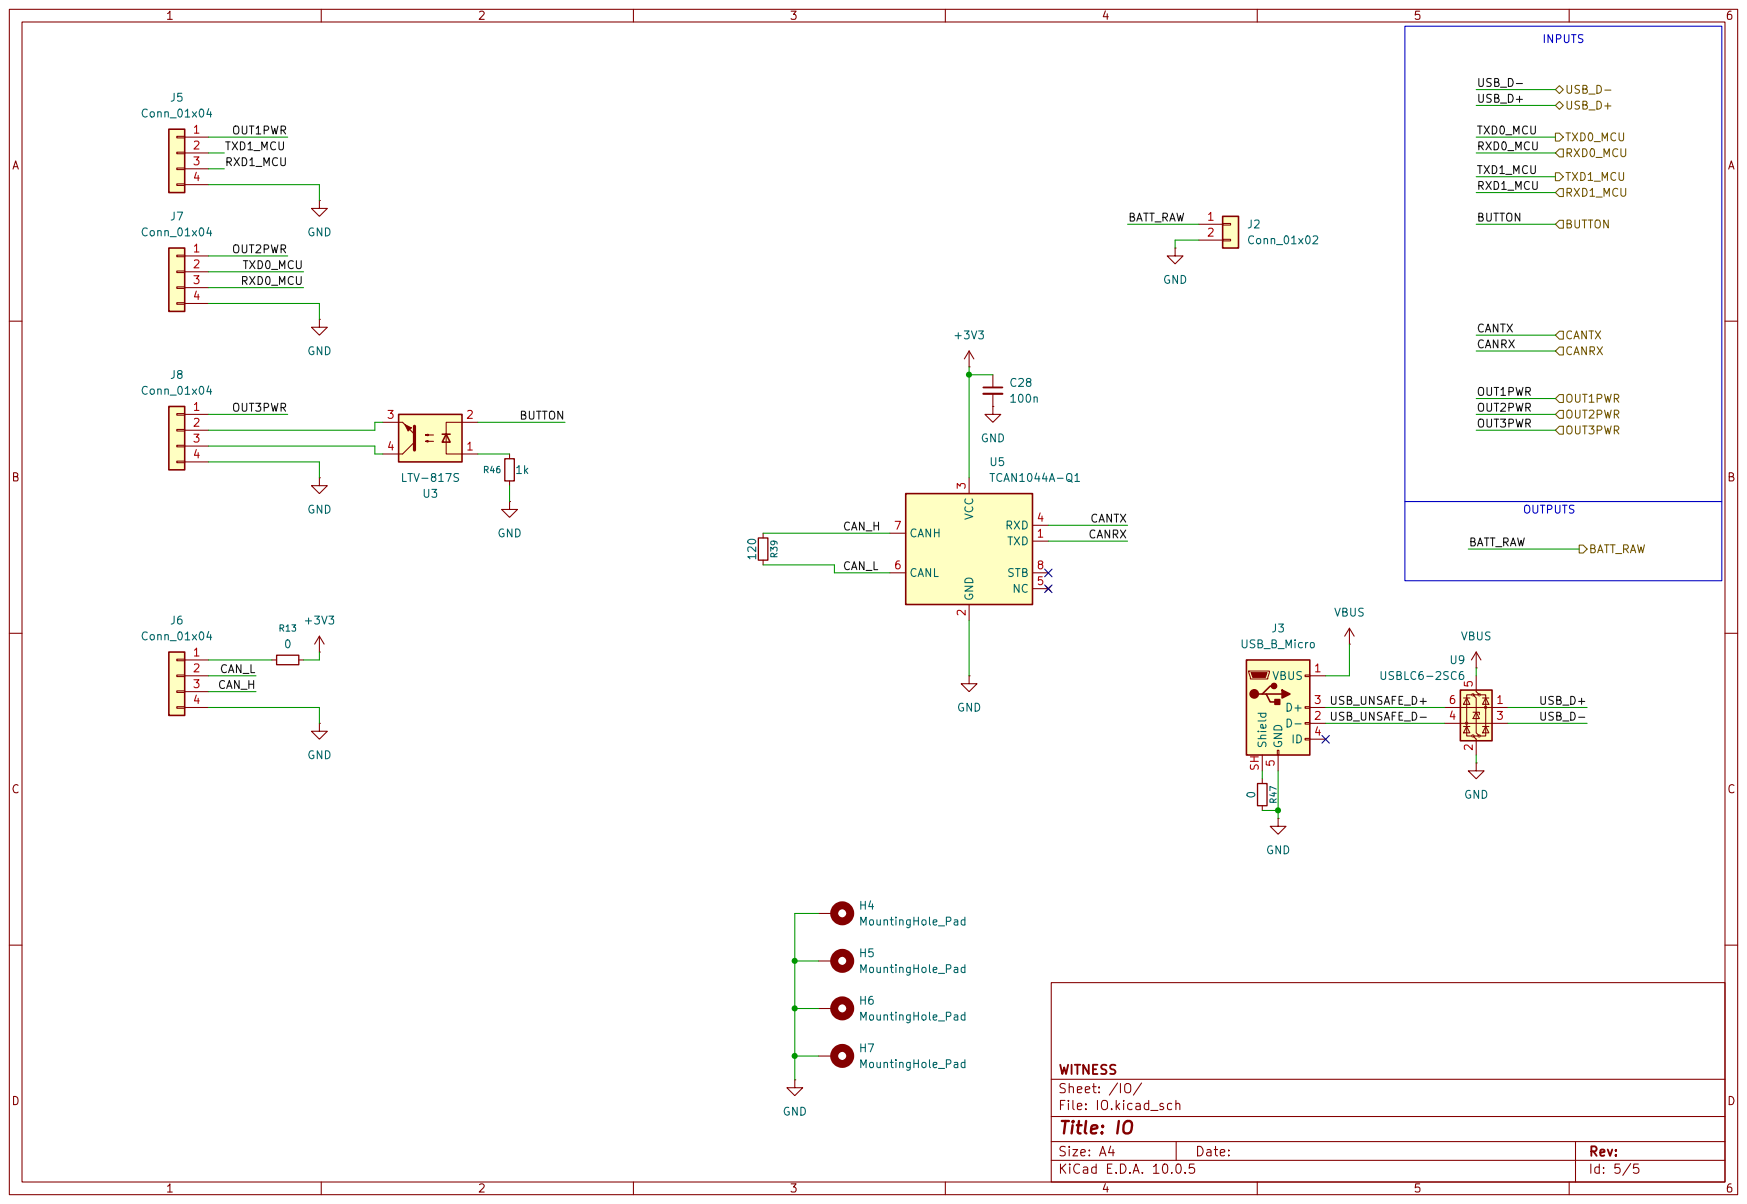
[picture p33: page 5]
