prs2026/Witness/Hardware/R2/IRIS R2/IRIS R2.kicad_pcb

## KiCad design Hardware/R2/IRIS R2/IRIS R2.kicad_pcb (2026-11-08)

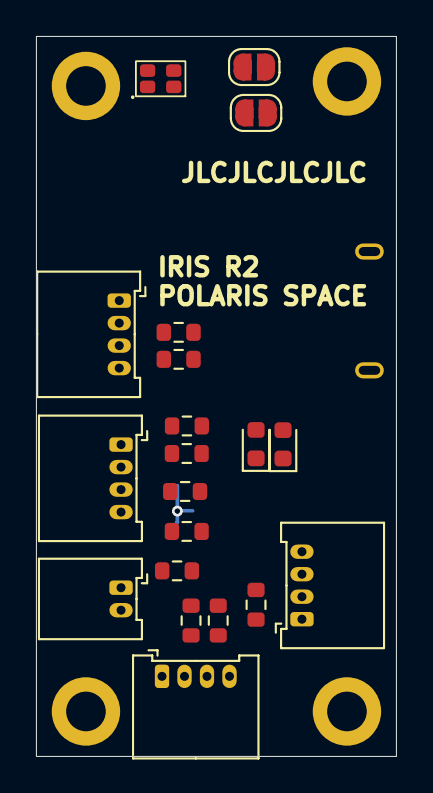
[picture p40: board IRIS R2.kicad_pcb from above]

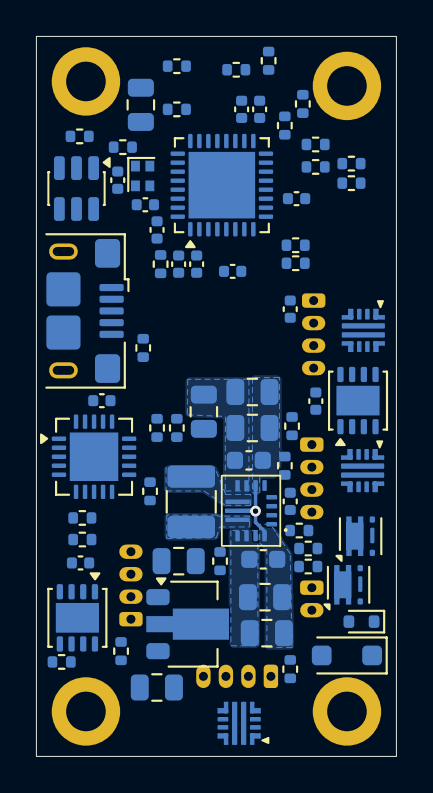
[picture p41: board IRIS R2.kicad_pcb from below]

Board: 4 copper layers, 20.0 x 40.0 mm, 95 parts (71 on the bottom side), 65 nets.

Parts:
C3, C4, C5, C7, C8, C9, C13, C21, C26, C27, C28, C29, C30: 100n; C_0402_1005Metric
C6: 1u; C_0402_1005Metric
C10, C11, C12, C18, C19: 10u; C_0805_2012Metric
C20, C22: 10u; C_0603_1608Metric
C23, C24, C25: 22u; C_0805_2012Metric
D1: LED_RGBA; 0603x2 RGB
D2, D3: LED; LED_0603_1608Metric
D4: PMEG2020EH,115; D_SOD-123F
D5: BZX584C10; D_SOD-523
H4, H5, H6, H7: MountingHole_Pad; MountingHole_2.2mm_M2_DIN965_Pad
J1, J4: Conn_01x02; SolderJumper-2_P1.3mm_Open_RoundedPad1.0x1.5mm
J2: Conn_01x02; Molex_Micro_Lock_2200980271_01x02_Horizontal
J3: USB_B_Micro; USB_Micro-B_Amphenol_10118193-0002LF_Horizontal
J5, J6, J7, J8: Conn_01x04; Molex_MicroLock-2200980471-01x04-Horizontal
L3: 1u; L_1210_3225Metric
Q1, Q2: SQA403EJ; Vishay_PowerPAK_SC70-6L_Single
R1, R2, R3, R4, R5, R11, R13: 0; R_0603_1608Metric
R6, R10, R12, R55: 10k; R_0402_1005Metric
R7: 680k; R_0402_1005Metric
R8: 130k; R_0402_1005Metric
R9: 100k; R_0402_1005Metric
R17, R18, R19, R20, R22, R38: 1k; R_0402_1005Metric
R21: 15k; R_0402_1005Metric
R23, R24, R25, R26: 4.7k; R_0402_1005Metric
R30, R31, R33, R34, R35, R36, R37, R47, R50, R51: 0; R_0402_1005Metric
R32: 5k; R_0402_1005Metric
R39: 120; R_0402_1005Metric
R45, R46, R56: 20m; R_0603_1608Metric
U1, U5, U10: TPS259472ARPWR; QFN-10-2x2-hotrod
U2: ME6118A33PG; SOT-89-3
U3: TLA2528IR; VSON-8-1EP_3x3mm_P0.65mm_EP1.65x2.4mm
U4: MCP23008-xML; QFN-20-1EP_4x4mm_P0.5mm_EP2.7x2.7mm
U6: TPS63070; RNM0015A
U7: ESP32-C3FH4; QFN-32-1EP_5x5mm_P0.5mm_EP3.7x3.7mm
U8: TCAN3414DRBR; VSON-8-1EP_3x3mm_P0.65mm_EP1.65x2.4mm
U9: USBLC6-2SC6; SOT-23-6
Y1: F322540MUBCE2O; Oscillator_SMD_Abracon_ASCO-4Pin_1.6x1.2mm

Connections:
+3V3: C3.1, C4.1, C5.1, C6.1, C7.2, C8.1, C9.1, C11.1, C12.1, C26.1, C27.1, C28.1, C29.1, C30.1, D1.4 (A), D2.2 (A), R13.2, R22.2, R23.2, R24.2, R25.2, R26.2, U2.2 (VOUT), U3.7 (AVDD), U4.18 (VDD), U7.2 (VDD3P3), U7.3 (VDD3P3), U7.11 (VDD3P3_RTC), U7.17 (VDD3P3_CPU), U7.18 (VDD_SPI), U7.31 (VDDA), U7.32 (VDDA), U8.3 (VCC), Y1.1 (Tri-State), Y1.4 (VDD)
+5V: C22.1, C23.1, C24.1, C25.1, D3.2 (A), R2.1, R4.1, R7.1, R9.1, R11.1, R46.2, U6.7 (VOUT), U6.8 (VOUT)
+BATT: C18.1, C19.1, C20.1, D4.1 (K), Q2.4 (S), R1.1, R3.1, R5.1, R6.1, R12.1, R21.2, R45.1, U6.12 (VIN), U6.13 (VIN)
/IO/BATT_RAW: J2.1, Q1.1 (D)
/IO/CANRX: R34.2, U8.1 (TXD)
/IO/CANTX: R33.2, U8.4 (RXD)
/IO/CAN_H: J6.3, R39.2, U8.7 (CANH)
/IO/CAN_L: J6.2, R39.1, U8.6 (CANL)
/IO/OUT1PWR: J5.1, U5.5 (OUT)
/IO/OUT2PWR: J7.1, U3.3 (AIN4), U10.5 (OUT)
/IO/OUT3PWR: J8.1, U1.5 (OUT), U3.1 (AIN2)
/IO/RXD0_MCU: J7.3, R50.2
/IO/RXD1_MCU: J5.3, R36.2
/IO/TXD0_MCU: J7.2, R37.2
/IO/TXD1_MCU: J5.2, R35.2
/IO/USB_D+: J3.3 (D+), R31.1, U9.1 (I/O1), U9.6 (I/O1)
/IO/USB_D-: J3.2 (D-), R30.1, U9.3 (I/O2), U9.4 (I/O2)
/Load Switches/CS2: U1.9 (ILM), U3.2 (AIN3)
/Load Switches/CS3: U3.4 (AIN5), U10.9 (ILM)
/Load Switches/EN1: U4.9 (GP0), U5.1 (EN/UVLO)
/Load Switches/EN2: U1.1 (EN/UVLO), U4.10 (GP1)
/Load Switches/EN3: U4.11 (GP2), U10.1 (EN/UVLO)
/Load Switches/SCL: R26.1, U4.19 (SCL), U7.10 (MTDI)
/Load Switches/SDA: R25.1, U4.20 (SDA), U7.9 (MTMS)
/Load Switches/VIN1: R1.2, R2.2, U5.6 (VIN)
/Load Switches/VIN2: R3.2, R4.2, U1.6 (VIN)
/Load Switches/VIN3: R5.2, R11.2, U10.6 (VIN)
/MCU/5V_EN: R12.2, U4.12 (GP3), U6.14 (EN)
/MCU/BUTTON: R24.1, U7.6 (GPIO2)
/MCU/CANRX: R34.1, U7.8 (GPIO3)
/MCU/CANTX: R33.1, U7.5 (XTAL_32K_N)
/MCU/LED_B: R19.1, U4.16 (GP7)
/MCU/LED_G: R17.1, U7.16 (GPIO10)
/MCU/LED_R: R18.1, U7.14 (GPIO8)
/MCU/LS_EN: J4.1, R23.1, R55.2, U4.4 (~RESET), U7.15 (GPIO9)
/MCU/RST: J1.1, R22.1, U7.7 (CHIP_EN)
/MCU/RXD0_MCU: R50.1, U7.27 (U0RXD)
/MCU/RXD1_MCU: R36.1, U7.13 (MTDO)
/MCU/TXD0_MCU: R37.1, U7.28 (U0TXD)
/MCU/TXD1_MCU: R35.1, U7.12 (MTCK)
/MCU/VSENSE: R21.1, R32.2, U7.4 (XTAL_32K_P)
/MCU/XIN: U7.30 (XTAL_P), Y1.3 (OUT)
GND: C3.2, C4.2, C5.2, C6.2, C7.1, C8.2, C9.2, C10.2, C11.2, C12.2, C13.1, C18.2, C19.2, C20.2, C21.2, C22.2, C23.2, C24.2, C25.2, C26.2, C27.2, C28.2, C29.2, C30.2, H4.1 (1_1), H5.1 (1_1), H6.1 (1_1), H7.1 (1_1), J1.2, J2.2, J3.5 (GND), J4.2, J5.4, J6.4, J7.4, J8.4, R8.2, R10.2, R20.1, R32.1, R38.1, R47.1, R51.1, R55.1, U1.2 (OVLO/OVCSEL), U1.8 (GND), U2.1 (GND), U3.9 (GND), U4.1 (A2), U4.2 (A1), U4.3 (A0), U4.17 (VSS), U5.2 (OVLO/OVCSEL), U5.8 (GND), U6.4 (GND), U6.6 (FB2), U6.10 (PGND), U6.15 (VSEL), U7.33 (GND), U8.2 (GND), U9.2 (GND), U10.2 (OVLO/OVCSEL), U10.8 (GND), Y1.2 (GND)
unnamed: D1.3 (BK), R19.2
unnamed: D1.2 (GK), R17.2
unnamed: D1.1 (RK), R18.2
unnamed: D2.1 (K), R20.2
unnamed: D3.1 (K), R38.2
unnamed: D5.2 (A), Q1.3 (G), R10.1
unnamed: D5.1 (K), Q1.4 (S), Q2.1 (D)
unnamed: J3.SH (Shield), R47.2
unnamed: J3.1 (VBUS), R56.1
unnamed: J6.1, R13.1
unnamed: C10.1, R45.2, R46.1, U2.3 (VIN)
unnamed: C13.2, U3.8 (DECAP)
unnamed: R7.2, R8.1, U6.5 (FB)
unnamed: L3.1, U6.11 (L1)
unnamed: L3.2, U6.9 (L2)
unnamed: R9.2, U6.2 (PG)
unnamed: R6.2, U6.1 (PS/SYNC)
unnamed: C21.1, U6.3 (VAUX)
unnamed: R30.2, U7.25 (GPIO18)
unnamed: R31.2, U7.26 (GPIO19)
unnamed: R51.2, U8.8 (STB)
VBUS: D4.2 (A), Q2.3 (G), R56.2, U9.5 (VBUS)
