prs2026/Witness/Hardware/Backplane/backplane v1/backplane v1.kicad_pcb

## KiCad design Hardware/Backplane/backplane v1/backplane v1.kicad_pcb (2026-11-08)

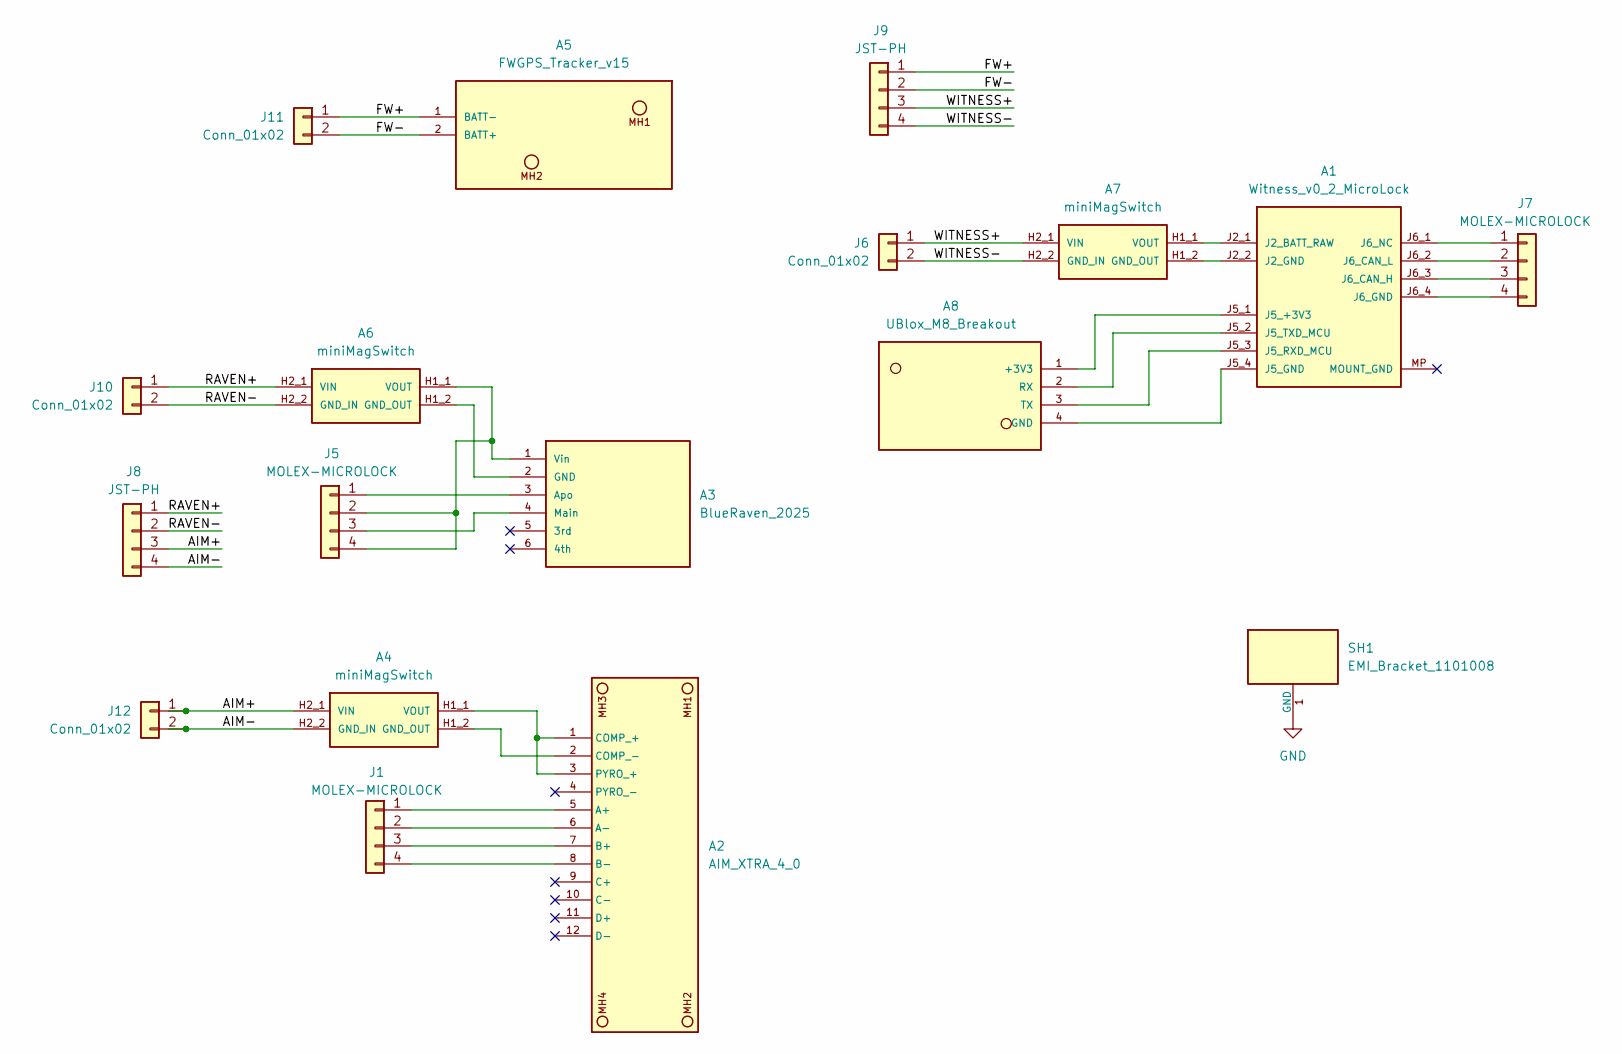
[picture p42: schematic backplane v1.kicad_sch]

Parts:
A1: Witness_v0_2_MicroLock
A2: AIM_XTRA_4_0; AIM_XTRA_4_0_Location_Template
A3: BlueRaven_2025; BlueRaven_2025_Location_Template
A4, A6, A7: miniMagSwitch; miniMagSwitch_SideOn_DualHeader
A5: FWGPS_Tracker_v15; FWGPS_Tracker_v15_Location_Template
A8: UBlox_M8_Breakout
J1, J5, J7: MOLEX-MICROLOCK; CONN_2200980000-SD_04P_MOL
J6, J10, J11, J12: Conn_01x02; CONN_B02B-PASK-1_JST
J8, J9: JST-PH; JST_PH_B4B-PH-K_1x04_P2.00mm_Vertical
SH1: EMI_Bracket_1101008

Connections:
/AIM+: A4.H2_1 (VIN), J8.3, J12.1
/AIM-: A4.H2_2 (GND_IN), J8.4, J12.2
/FW+: A5.1 (BATT-), J9.1, J11.1
/FW-: A5.2 (BATT+), J9.2, J11.2
/RAVEN+: A6.H2_1 (VIN), J8.1, J10.1
/RAVEN-: A6.H2_2 (GND_IN), J8.2, J10.2
/WITNESS+: A7.H2_1 (VIN), J6.1, J9.3
/WITNESS-: A7.H2_2 (GND_IN), J6.2, J9.4
GND: SH1.1 (GND_1)
unnamed: A1.J2_1 (J2_BATT_RAW), A7.H1_1 (VOUT)
unnamed: A1.J2_2 (J2_GND), A7.H1_2 (GND_OUT)
unnamed: A1.J5_1 (J5_+3V3), A8.1 (+3V3)
unnamed: A1.J5_4 (J5_GND), A8.4 (GND)
unnamed: A1.J5_3 (J5_RXD_MCU), A8.3 (TX)
unnamed: A1.J5_2 (J5_TXD_MCU), A8.2 (RX)
unnamed: A1.J6_3 (J6_CAN_H), J7.3
unnamed: A1.J6_2 (J6_CAN_L), J7.2
unnamed: A1.J6_4 (J6_GND), J7.4
unnamed: A1.J6_1 (J6_NC), J7.1
unnamed: A2.5 (A+), J1.1
unnamed: A2.6 (A-), J1.2
unnamed: A2.7 (B+), J1.3
unnamed: A2.8 (B-), J1.4
unnamed: A2.1 (COMP_+), A2.3 (PYRO_+), A4.H1_1 (VOUT)
unnamed: A2.2 (COMP_-), A4.H1_2 (GND_OUT)
unnamed: A3.3 (Apo), J5.1
unnamed: A3.2 (GND), A6.H1_2 (GND_OUT)
unnamed: A3.4 (Main), J5.3
unnamed: A3.1 (Vin), A6.H1_1 (VOUT), J5.2, J5.4

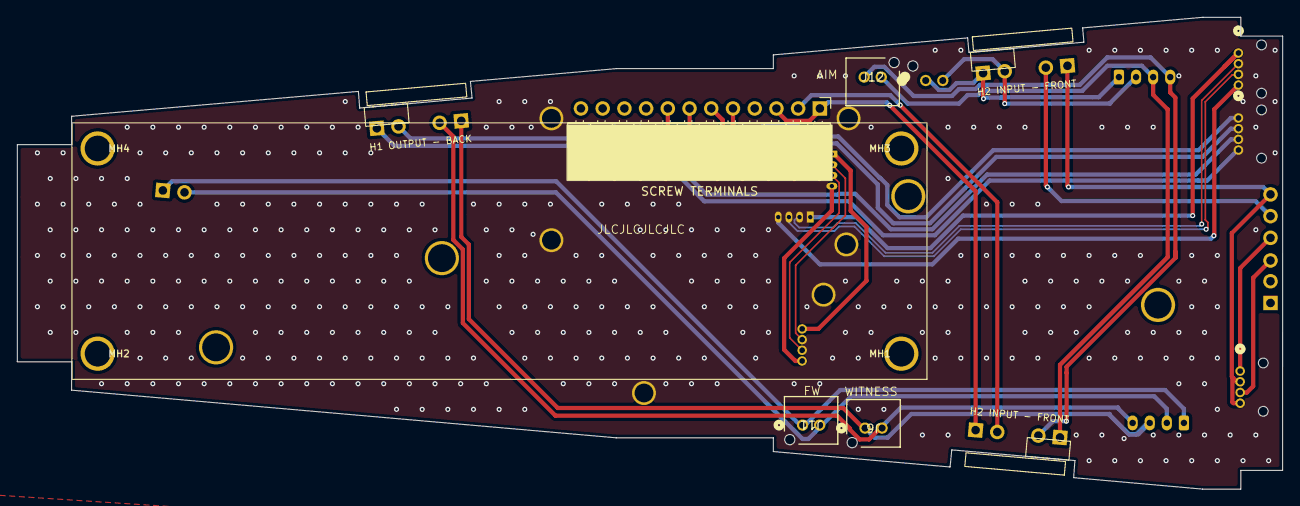
[picture p43: board backplane v1.kicad_pcb from above]

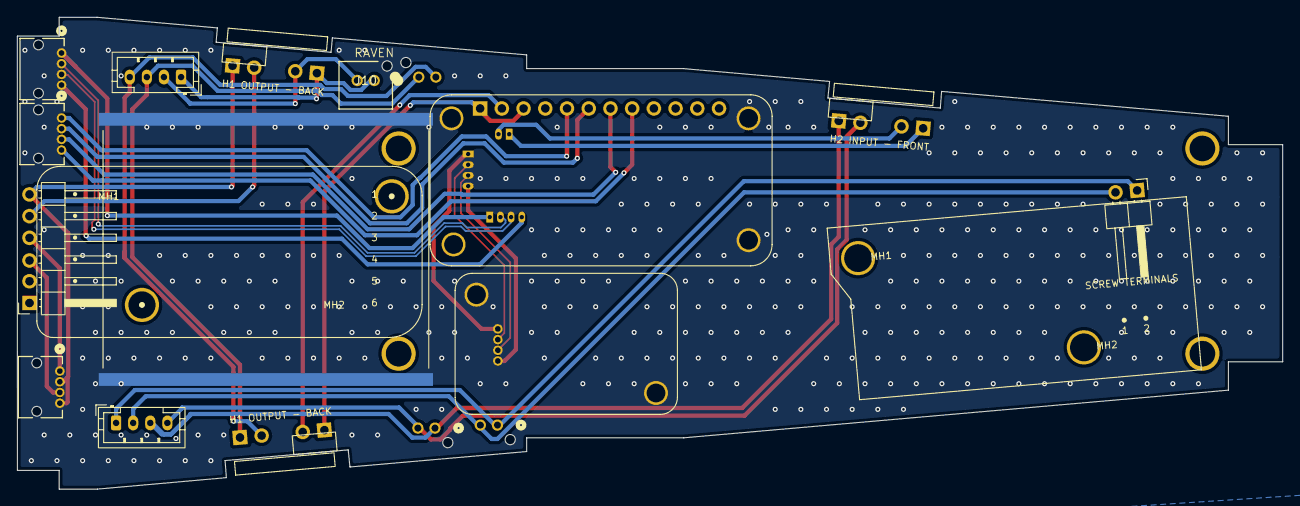
[picture p44: board backplane v1.kicad_pcb from below]

Board: 2 copper layers, 148.0 x 55.2 mm, 18 parts (12 on the bottom side), 28 nets.
