prs2026/Witness/Hardware/Breakouts/ubloxm8breakout/ubloxm8breakout.kicad_pcb

## KiCad design Hardware/Breakouts/ubloxm8breakout/ubloxm8breakout.kicad_pcb (2026-11-08)

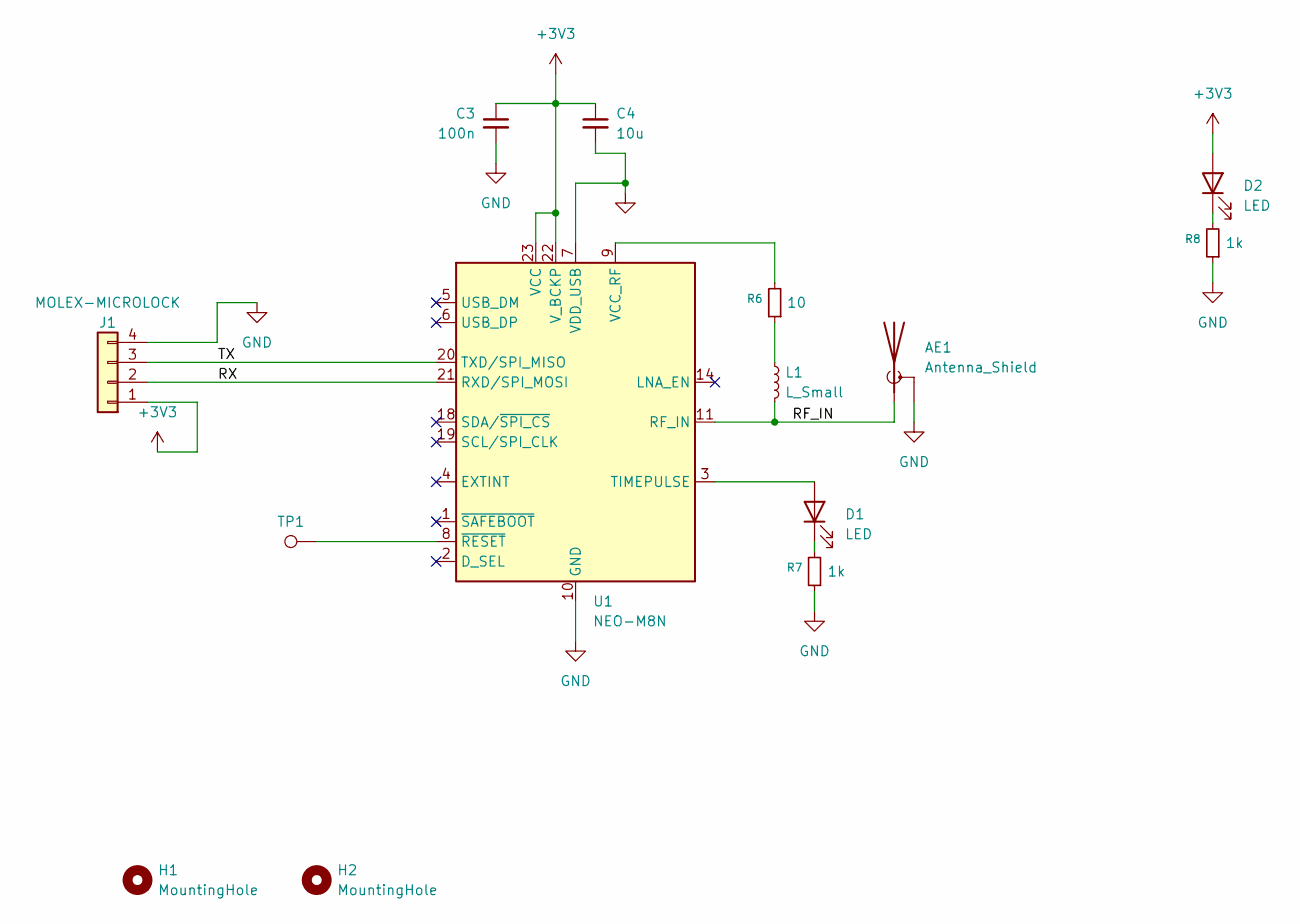
[picture p45: schematic ubloxm8breakout.kicad_sch, Ublox M8 Breakout]

Parts:
AE1: Antenna_Shield; U.FL_Molex_MCRF_73412-0110_Vertical
C3: 100n; C_0603_1608Metric
C4: 10u; C_0603_1608Metric
D1, D2: LED; LED_0603_1608Metric
H1, H2: MountingHole; MountingHole_2.2mm_M2
J1: MOLEX-MICROLOCK; CONN_2200980000-SD_04P_MOL
L1: L_Small; L_0603_1608Metric
R6: 10; R_0603_1608Metric
R7, R8: 1k; R_0603_1608Metric
TP1: TestPoint; TestPoint_Pad_1.5x1.5mm
U1: NEO-M8N; ublox_NEO

Connections:
+3V3: C3.1, C4.1, D2.2 (A), J1.1, U1.22 (V_BCKP), U1.23 (VCC)
/RF_IN: AE1.1 (A), L1.2, U1.11 (RF_IN)
/RX: J1.2, U1.21 (RXD/SPI_MOSI)
/TX: J1.3, U1.20 (TXD/SPI_MISO)
GND: AE1.2 (Shield), C3.2, C4.2, J1.4, R7.1, R8.1, U1.7 (VDD_USB), U1.10 (GND), U1.12 (GND), U1.13 (GND), U1.24 (GND)
unnamed: D1.2 (A), U1.3 (TIMEPULSE)
unnamed: D1.1 (K), R7.2
unnamed: D2.1 (K), R8.2
unnamed: L1.1, R6.1
unnamed: R6.2, U1.9 (VCC_RF)
unnamed: TP1.1 (1_1), U1.8 (~RESET)

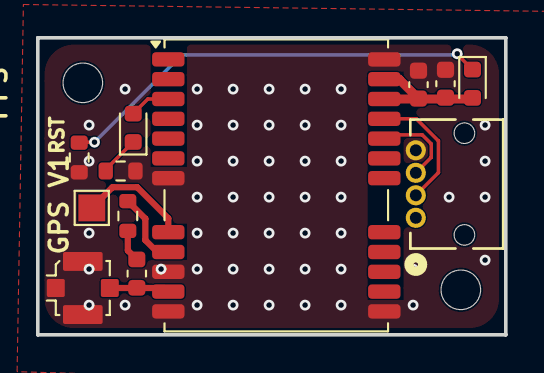
[picture p46: board ubloxm8breakout.kicad_pcb from above]

Board: 4 copper layers, 26.0 x 16.5 mm, 14 parts (0 on the bottom side), 11 nets.
