prs2026/Witness/Hardware/Breakouts/px1120sbreakout/px1120sbreakout.kicad_pcb

## KiCad design Hardware/Breakouts/px1120sbreakout/px1120sbreakout.kicad_pcb (2026-11-01)

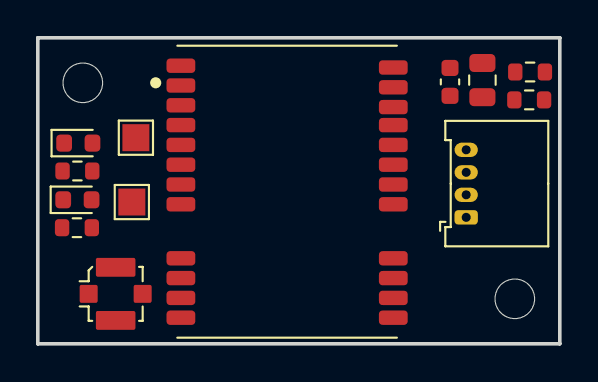
[picture p47: board px1120sbreakout.kicad_pcb from above]

Board: 2 copper layers, 29.0 x 17.0 mm, 15 parts (0 on the bottom side), 12 nets, no tracks yet.

Parts:
AE1: Antenna_Shield; U.FL_Molex_MCRF_73412-0110_Vertical
C1: 10u; C_0805_2012Metric
C3: 100n; C_0603_1608Metric
D1, D2: LED; LED_0603_1608Metric
H1, H2: MountingHole; MountingHole_2.2mm_M2
J1: MOLEX-MICROLOCK; Molex_MicroLock-2200980471-01x04-Horizontal
R3, R4: 0; R_0603_1608Metric
R7, R8: 1k; R_0603_1608Metric
TP1, TP2: TestPoint; TestPoint_Pad_1.5x1.5mm
U1: PX1120S

Connections:
+3V3: C1.1, C3.1, D2.2 (A), J1.1, U1.22 (V_BCKP), U1.23 (VCC)
GND: AE1.2 (Shield), C1.2, C3.2, J1.4, R7.1, R8.1, U1.10 (GND), U1.12 (GND), U1.13 (GND), U1.24 (GND)
unnamed: AE1.1 (A), U1.11 (RF_IN)
unnamed: D1.2 (A), U1.3 (1PPS)
unnamed: D1.1 (K), R7.2
unnamed: D2.1 (K), R8.2
unnamed: J1.2, R3.2
unnamed: J1.3, R4.2
unnamed: TP1.1 (1_1), U1.1 (BOOT_SEL)
unnamed: TP2.1 (1_1), U1.8 (RSTN)
unnamed: R3.1, U1.21 (RXD)
unnamed: R4.1, U1.20 (TXD)
