prs2026/Witness/Hardware/witnessv0.2/witness/witness.kicad_pcb

## KiCad design Hardware/witnessv0.2/witness/witness.kicad_pcb (2026-09-07)

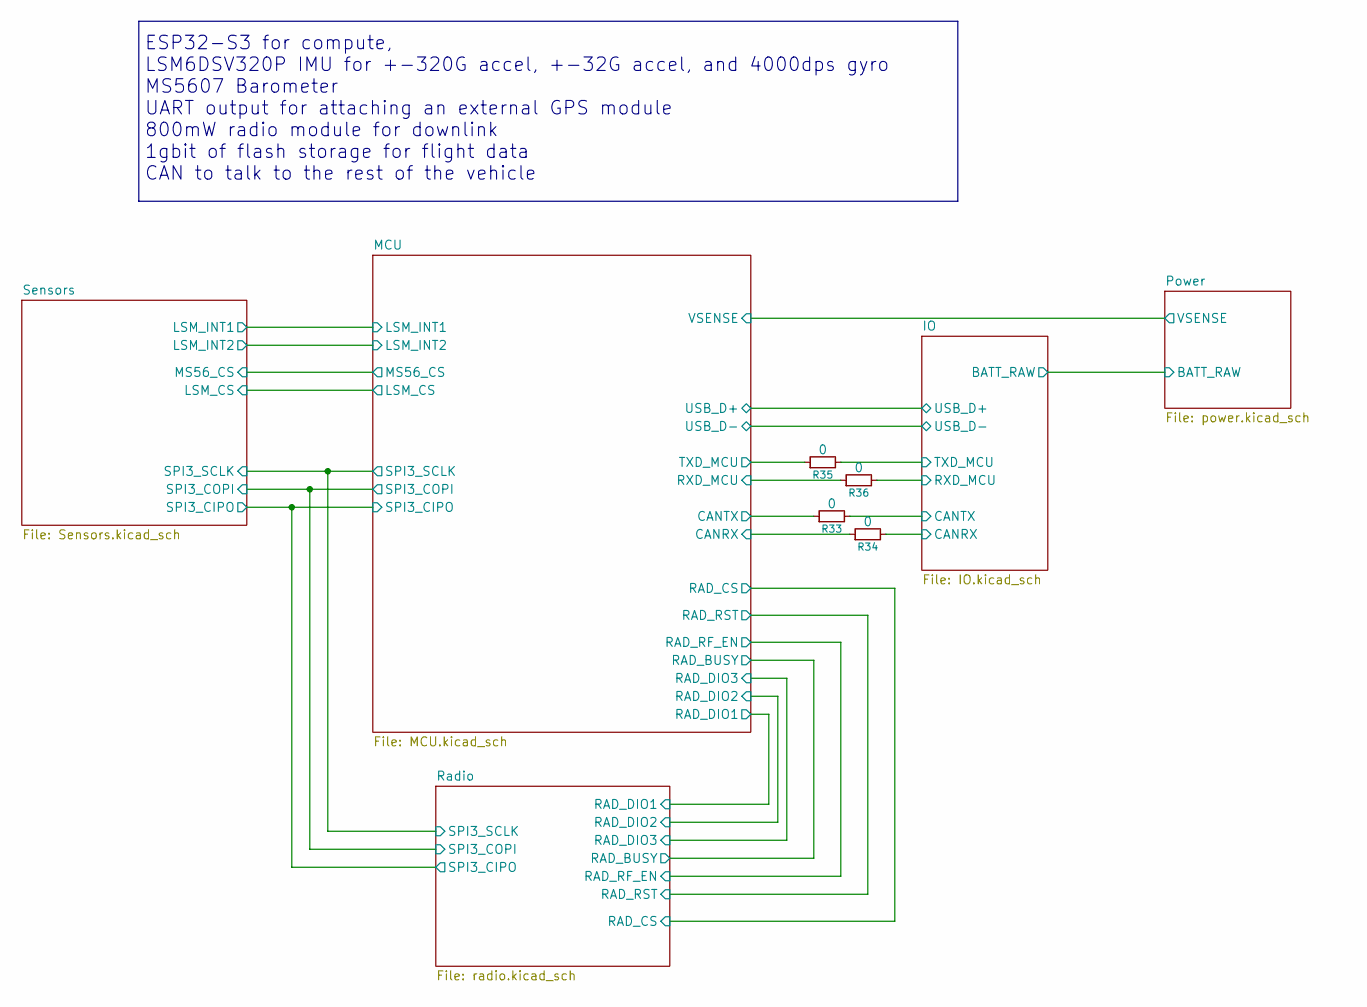
[picture p48: schematic witness.kicad_sch, TOP LEVEL]

Parts:
R33, R34, R35, R36: 0; R_0402_1005Metric; LCSC_Part C17168

Connections:
/IO/CANRX: R34.2; also elsewhere on the board
/IO/CANTX: R33.2; also elsewhere on the board
/IO/RXD_MCU: R36.2; also elsewhere on the board
/IO/TXD_MCU: R35.2; also elsewhere on the board
/MCU/CANRX: R34.1; also elsewhere on the board
/MCU/CANTX: R33.1; also elsewhere on the board
/MCU/RXD_MCU: R36.1; also elsewhere on the board
/MCU/TXD_MCU: R35.1; also elsewhere on the board

Notes on the sheet:
ESP32-S3 for compute, LSM6DSV320P IMU for +-320G accel, +-32G accel, and 4000dps gyro MS5607 Barometer UART output for attaching an external GPS module 800mW radio module for downlink 1gbit of flash storage for flight data CAN to talk to the rest of the vehicle

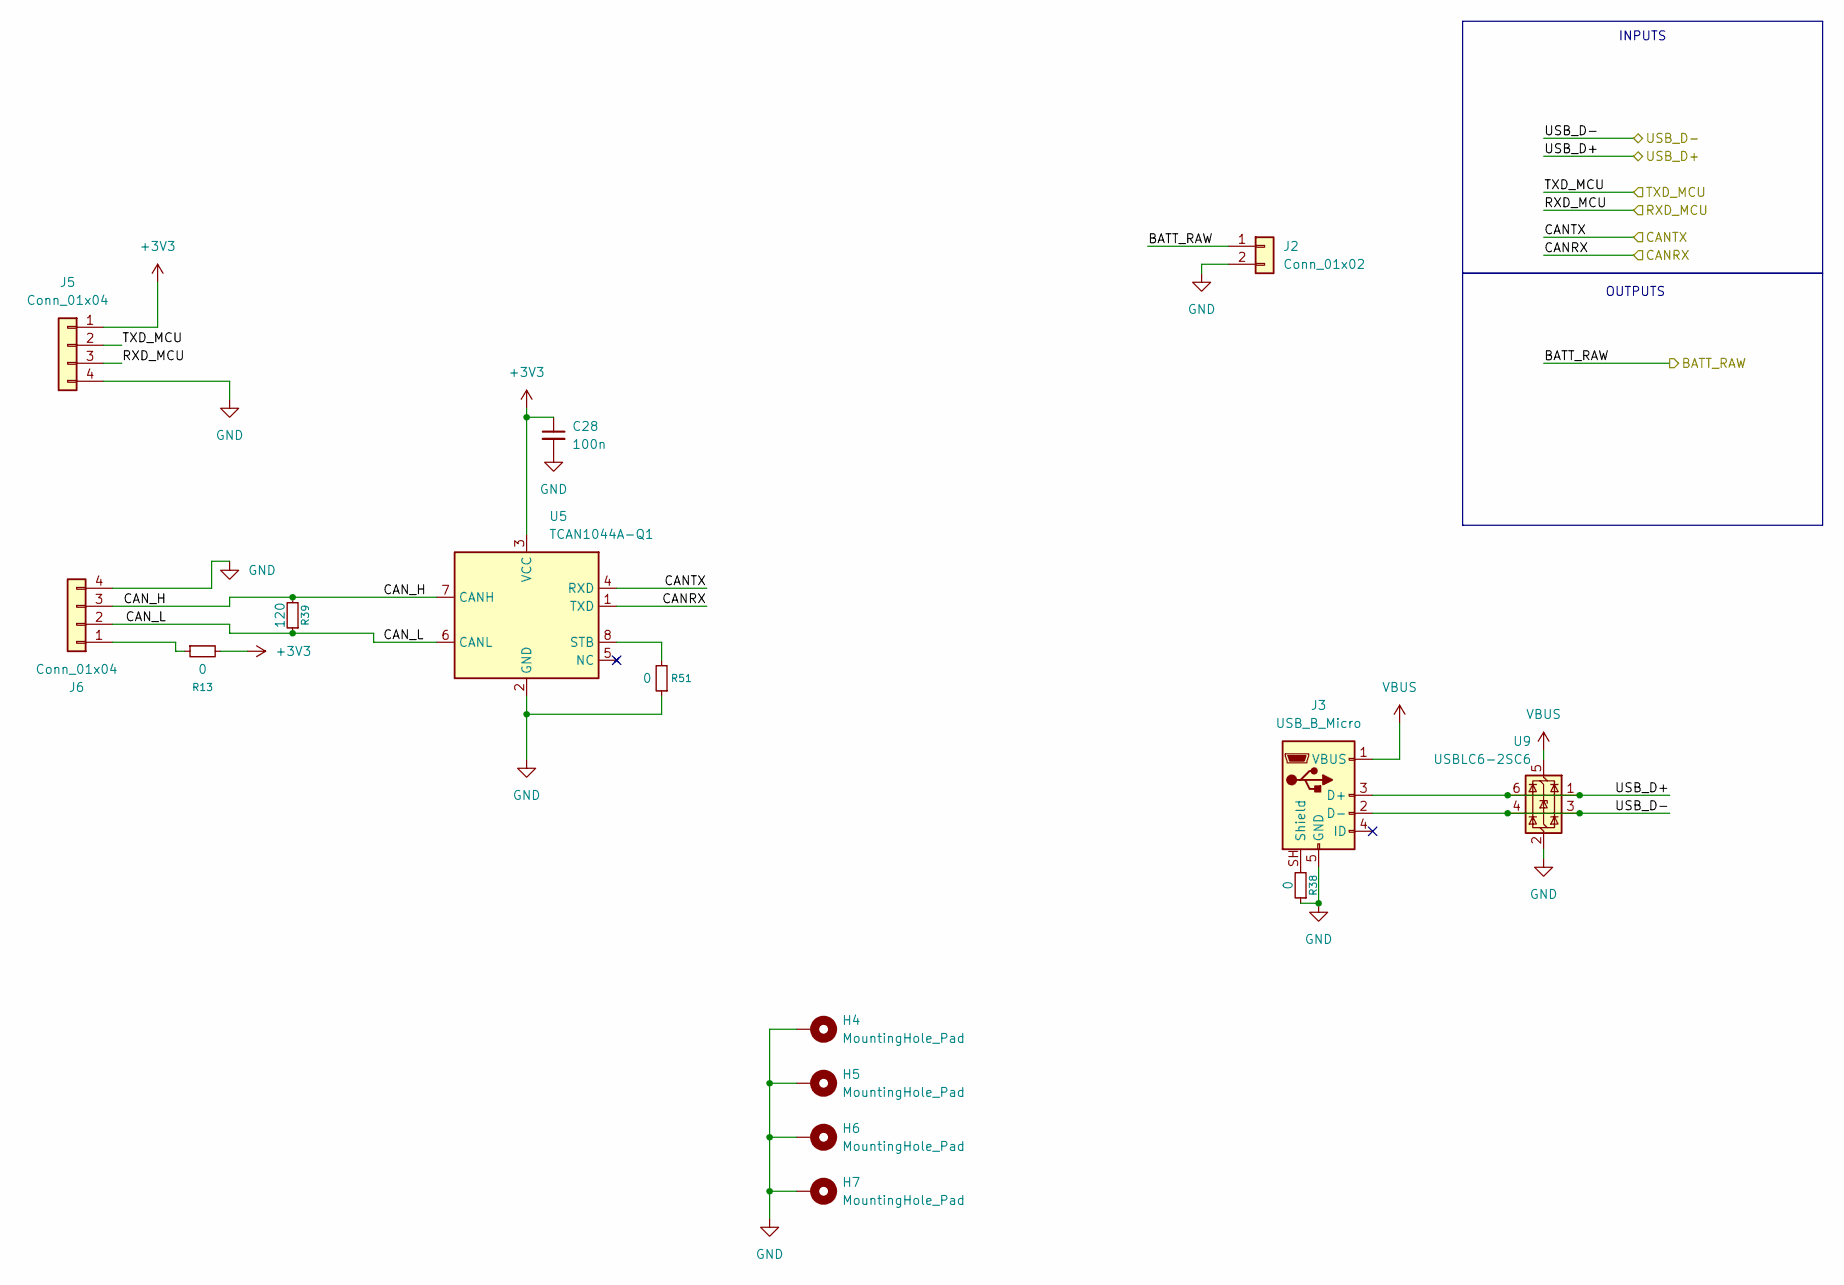
[picture p49: schematic IO.kicad_sch]

Parts:
C28: 100n; C_0402_1005Metric; LCSC_Part C307331
H4, H5, H6, H7: MountingHole_Pad; MountingHole_2.2mm_M2_DIN965_Pad
J2: Conn_01x02; Molex_Micro_Lock_2200980271_01x02_Horizontal
J3: USB_B_Micro; USB_Micro-B_Amphenol_10118193-0002LF_Horizontal; LCSC_Part C132562
J5, J6: Conn_01x04; Molex_MicroLock-2200980471-01x04-Horizontal
R13: 0; R_0603_1608Metric
R38, R51: 0; R_0402_1005Metric; LCSC_Part C17168
R39: 120; R_0402_1005Metric; LCSC_Part C25079
U5: TCAN1044A-Q1; VSON-8-1EP_3x3mm_P0.65mm_EP1.65x2.4mm; LCSC_Part C3234119
U9: USBLC6-2SC6; SOT-23-6; LCSC_Part C7519

Connections:
+3V3: C28.1, J5.1, R13.2, U5.3 (VCC); also elsewhere on the board
/IO/BATT_RAW: J2.1; also elsewhere on the board
/IO/CANRX: U5.1 (TXD); also elsewhere on the board
/IO/CANTX: U5.4 (RXD); also elsewhere on the board
/IO/CAN_H: J6.3, R39.2, U5.7 (CANH)
/IO/CAN_L: J6.2, R39.1, U5.6 (CANL)
/IO/RXD_MCU: J5.3; also elsewhere on the board
/IO/TXD_MCU: J5.2; also elsewhere on the board
/IO/USB_D+: J3.3 (D+), U9.1 (I/O1), U9.6 (I/O1); also elsewhere on the board
/IO/USB_D-: J3.2 (D-), U9.3 (I/O2), U9.4 (I/O2); also elsewhere on the board
GND: C28.2, H4.1 (1_1), H5.1 (1_1), H6.1 (1_1), H7.1 (1_1), J2.2, J3.5 (GND), J5.4, J6.4, R38.1, R51.1, U5.2 (GND), U9.2 (GND); also elsewhere on the board
unnamed: J3.SH (Shield), R38.2
unnamed: J6.1, R13.1
unnamed: R51.2, U5.8 (STB)
VBUS: J3.1 (VBUS), U9.5 (VBUS); also elsewhere on the board

Notes on the sheet:
OUTPUTS
INPUTS

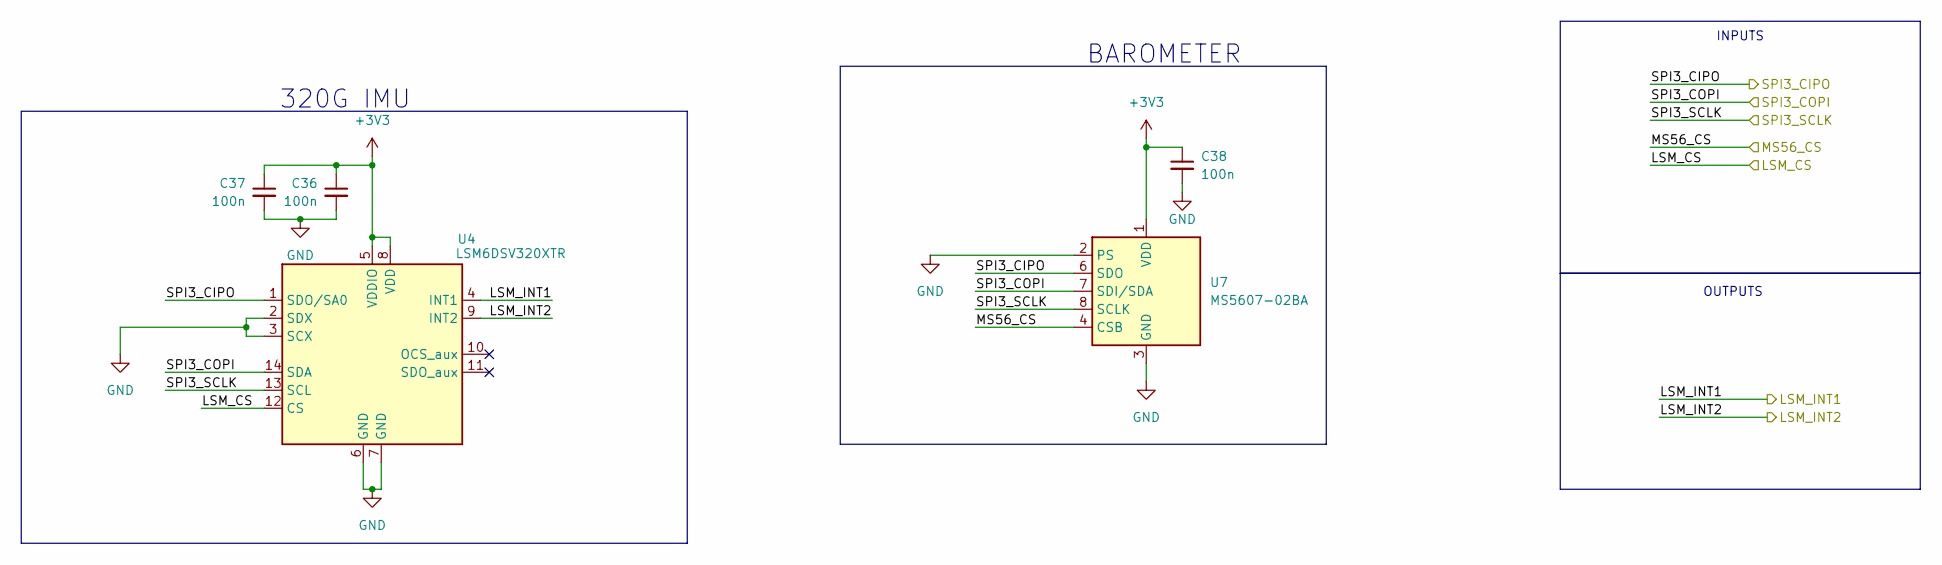
[picture p50: schematic Sensors.kicad_sch]

Parts:
C36, C37, C38: 100n; C_0402_1005Metric; LCSC_Part C307331
U4: LSM6DSV320XTR; Bosch_LGA-14_3x2.5mm_P0.5mm; LCSC_Part C26633007
U7: MS5607-02BA; LGA-8_3x5mm_P1.25mm; LCSC_Part C97627

Connections:
+3V3: C36.1, C37.1, C38.1, U4.5 (VDDIO), U4.8 (VDD), U7.1 (VDD); also elsewhere on the board
/MCU/LSM_CS: U4.12 (CS); also elsewhere on the board
/MCU/LSM_INT1: U4.4 (INT1); also elsewhere on the board
/MCU/LSM_INT2: U4.9 (INT2); also elsewhere on the board
/MCU/MS56_CS: U7.4 (CSB), U7.5 (CSB); also elsewhere on the board
/MCU/SPI3_CIPO: U4.1 (SDO/SA0), U7.6 (SDO); also elsewhere on the board
/MCU/SPI3_COPI: U4.14 (SDA), U7.7 (SDI/SDA); also elsewhere on the board
/MCU/SPI3_SCLK: U4.13 (SCL), U7.8 (SCLK); also elsewhere on the board
GND: C36.2, C37.2, C38.2, U4.2 (SDX), U4.3 (SCX), U4.6 (GND), U4.7 (GND), U7.2 (PS), U7.3 (GND); also elsewhere on the board

Notes on the sheet:
320G IMU
OUTPUTS
INPUTS
BAROMETER

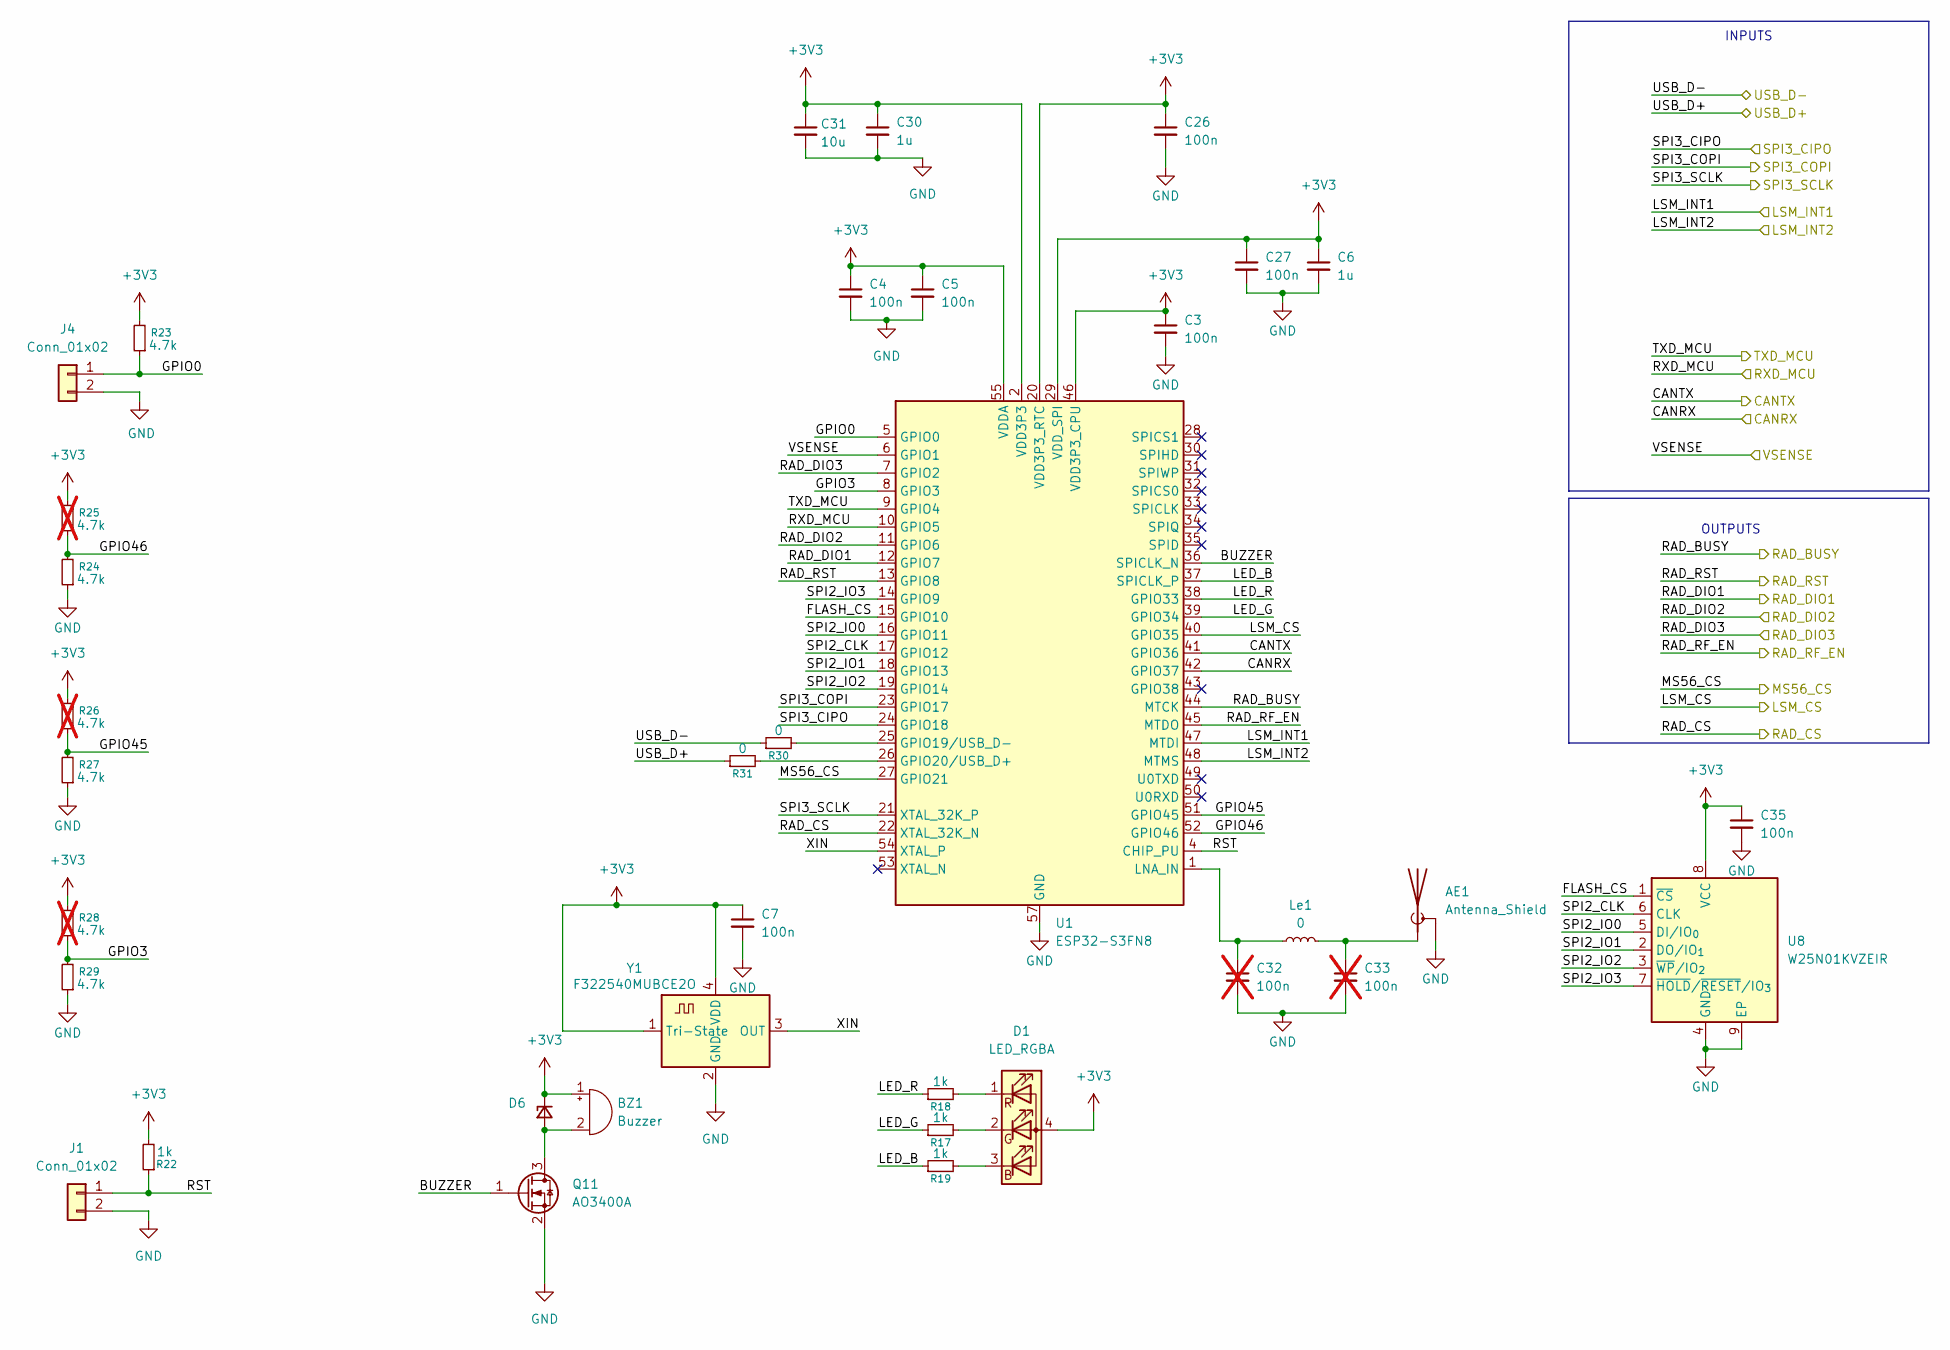
[picture p51: schematic MCU.kicad_sch]

Parts:
AE1: Antenna_Shield; U.FL_Molex_MCRF_73412-0110_Vertical
BZ1: Buzzer; OWMB-505020S-40-12D
C3, C4, C5, C7, C26, C27, C35: 100n; C_0402_1005Metric; LCSC_Part C307331
C6, C30: 1u; C_0402_1005Metric; LCSC_Part C52923
C31: 10u; C_0603_1608Metric; LCSC_Part C96446
C32, C33: 100n; C_0402_1005Metric; LCSC_Part C307331; not fitted
D1: LED_RGBA; 0603x2 RGB
D6: BZX584C10; D_SOD-523; LCSC_Part C22395577
J1, J4: Conn_01x02; SolderJumper-2_P1.3mm_Open_RoundedPad1.0x1.5mm
Le1: 0; L_0402_1005Metric
Q11: AO3400A; SOT-23; LCSC_Part C20917
R17, R18, R19, R22: 1k; R_0402_1005Metric; LCSC_Part C11702
R23, R24, R27, R29: 4.7k; R_0402_1005Metric; LCSC_Part C25900
R25, R26, R28: 4.7k; R_0402_1005Metric; LCSC_Part C25900; not fitted
R30, R31: 0; R_0402_1005Metric; LCSC_Part C17168
U1: ESP32-S3FN8; QFN-56-1EP_7x7mm_P0.4mm_EP4x4mm; LCSC_Part C2913196
U8: W25N01KVZEIR; WSON-8-1EP_8x6mm_P1.27mm_EP3.4x4.3mm; LCSC_Part C22472329
Y1: F322540MUBCE2O; Oscillator_SMD_Abracon_ASCO-4Pin_1.6x1.2mm; LCSC_Part C5917310

Connections:
+3V3: BZ1.1 (+), C3.1, C4.1, C5.1, C6.1, C7.1, C26.1, C27.1, C30.1, C31.1, C35.1, D1.4 (A), D6.1 (K), R22.2, R23.2, R25.2, R26.2, R28.2, U1.2 (VDD3P3), U1.3 (VDD3P3), U1.20 (VDD3P3_RTC), U1.29 (VDD_SPI), U1.46 (VDD3P3_CPU), U1.55 (VDDA), U1.56 (VDDA), U8.8 (VCC), Y1.1 (Tri-State), Y1.4 (VDD); also elsewhere on the board
/IO/USB_D+: R31.1; also elsewhere on the board
/IO/USB_D-: R30.1; also elsewhere on the board
/MCU/BUZZER: Q11.1 (G), U1.36 (SPICLK_N)
/MCU/CANRX: U1.42 (GPIO37); also elsewhere on the board
/MCU/CANTX: U1.41 (GPIO36); also elsewhere on the board
/MCU/FLASH_CS: U1.15 (GPIO10), U8.1 (~CS)
/MCU/GPIO0: J4.1, R23.1, U1.5 (GPIO0)
/MCU/GPIO3: R28.1, R29.2, U1.8 (GPIO3)
/MCU/GPIO45: R26.1, R27.2, U1.51 (GPIO45)
/MCU/GPIO46: R24.2, R25.1, U1.52 (GPIO46)
/MCU/LED_B: R19.1, U1.37 (SPICLK_P)
/MCU/LED_G: R17.1, U1.39 (GPIO34)
/MCU/LED_R: R18.1, U1.38 (GPIO33)
/MCU/LSM_CS: U1.40 (GPIO35); also elsewhere on the board
/MCU/LSM_INT1: U1.47 (MTDI); also elsewhere on the board
/MCU/LSM_INT2: U1.48 (MTMS); also elsewhere on the board
/MCU/MS56_CS: U1.27 (GPIO21); also elsewhere on the board
/MCU/RAD_BUSY: U1.44 (MTCK); also elsewhere on the board
/MCU/RAD_CS: U1.22 (XTAL_32K_N); also elsewhere on the board
/MCU/RAD_DIO1: U1.12 (GPIO7); also elsewhere on the board
/MCU/RAD_DIO2: U1.11 (GPIO6); also elsewhere on the board
/MCU/RAD_DIO3: U1.7 (GPIO2); also elsewhere on the board
/MCU/RAD_RF_EN: U1.45 (MTDO); also elsewhere on the board
/MCU/RAD_RST: U1.13 (GPIO8); also elsewhere on the board
/MCU/RST: J1.1, R22.1, U1.4 (CHIP_PU)
/MCU/RXD_MCU: U1.10 (GPIO5); also elsewhere on the board
/MCU/SPI2_CLK: U1.17 (GPIO12), U8.6 (CLK)
/MCU/SPI2_IO0: U1.16 (GPIO11), U8.5 (DI/IO_{0})
/MCU/SPI2_IO1: U1.18 (GPIO13), U8.2 (DO/IO_{1})
/MCU/SPI2_IO2: U1.19 (GPIO14), U8.3 (~WP/IO_{2})
/MCU/SPI2_IO3: U1.14 (GPIO9), U8.7 (~HOLD/~RESET/IO_{3})
/MCU/SPI3_CIPO: U1.24 (GPIO18); also elsewhere on the board
/MCU/SPI3_COPI: U1.23 (GPIO17); also elsewhere on the board
/MCU/SPI3_SCLK: U1.21 (XTAL_32K_P); also elsewhere on the board
/MCU/TXD_MCU: U1.9 (GPIO4); also elsewhere on the board
/MCU/VSENSE: U1.6 (GPIO1); also elsewhere on the board
/MCU/XIN: U1.54 (XTAL_P), Y1.3 (OUT)
GND: AE1.2 (Shield), C3.2, C4.2, C5.2, C6.2, C7.2, C26.2, C27.2, C30.2, C31.2, C32.2, C33.2, C35.2, J1.2, J4.2, Q11.2 (S), R24.1, R27.1, R29.1, U1.57 (GND), U8.4 (GND), U8.9 (EP), Y1.2 (GND); also elsewhere on the board
unnamed: AE1.1 (A), C33.1, Le1.2
unnamed: BZ1.2 (-), D6.2 (A), Q11.3 (D)
unnamed: D1.3 (BK), R19.2
unnamed: D1.2 (GK), R17.2
unnamed: D1.1 (RK), R18.2
unnamed: R30.2, U1.25 (GPIO19/USB_D-)
unnamed: R31.2, U1.26 (GPIO20/USB_D+)
unnamed: C32.1, Le1.1, U1.1 (LNA_IN)

Notes on the sheet:
OUTPUTS
INPUTS
