prs2026/Witness/Hardware/witnessv0.2/witness/witness.kicad_pcb

## KiCad design Hardware/witnessv0.2/witness/witness.kicad_pcb (continued)

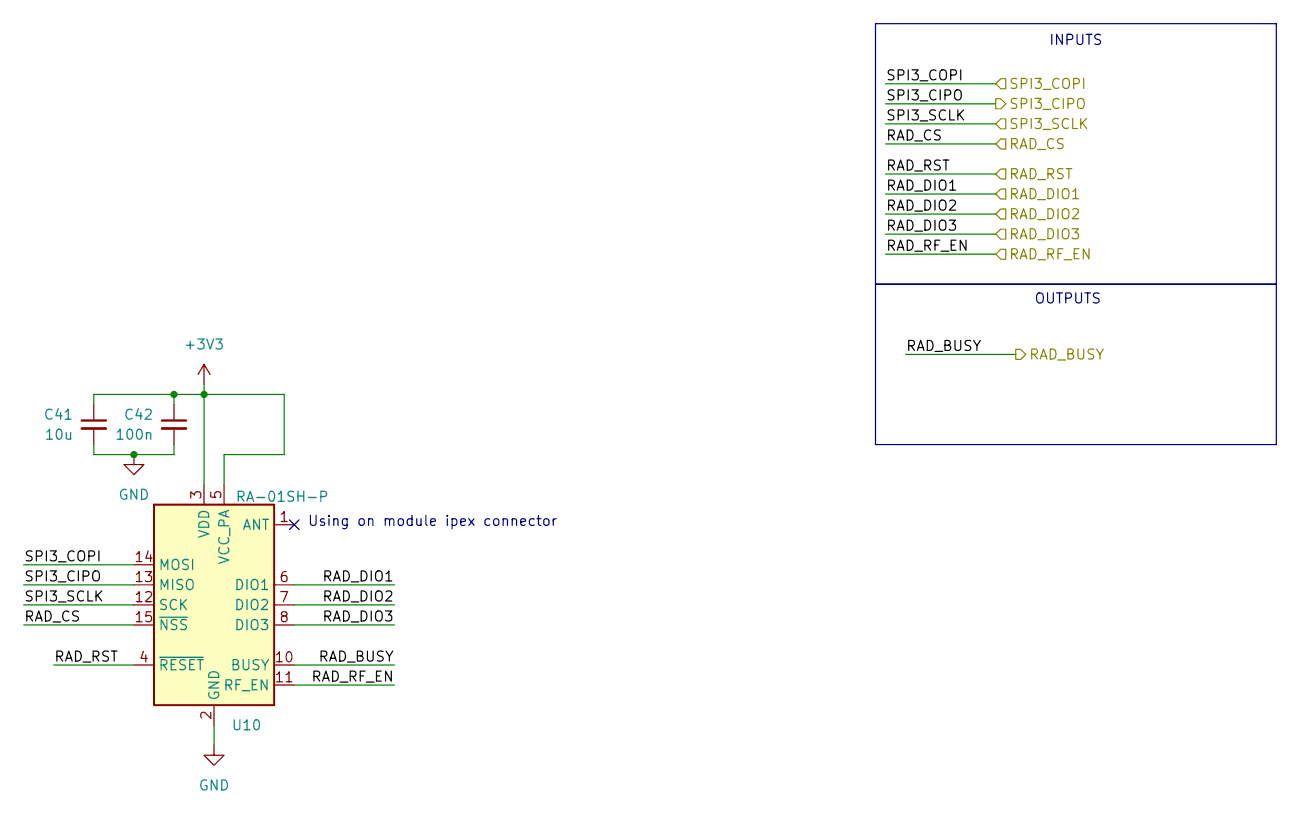
[picture p52: schematic radio.kicad_sch]

Parts:
C41: 10u; C_0603_1608Metric; LCSC_Part C96446
C42: 100n; C_0402_1005Metric; LCSC_Part C307331
U10: RA-01SH-P; Ai-Thinker-Ra-01-LoRa

Connections:
+3V3: C41.1, C42.1, U10.3 (VDD), U10.5 (VCC_PA); also elsewhere on the board
/MCU/RAD_BUSY: U10.10 (BUSY); also elsewhere on the board
/MCU/RAD_CS: U10.15 (~NSS); also elsewhere on the board
/MCU/RAD_DIO1: U10.6 (DIO1); also elsewhere on the board
/MCU/RAD_DIO2: U10.7 (DIO2); also elsewhere on the board
/MCU/RAD_DIO3: U10.8 (DIO3); also elsewhere on the board
/MCU/RAD_RF_EN: U10.11 (RF_EN); also elsewhere on the board
/MCU/RAD_RST: U10.4 (~RESET); also elsewhere on the board
/MCU/SPI3_CIPO: U10.13 (MISO); also elsewhere on the board
/MCU/SPI3_COPI: U10.14 (MOSI); also elsewhere on the board
/MCU/SPI3_SCLK: U10.12 (SCK); also elsewhere on the board
GND: C41.2, C42.2, U10.2 (GND), U10.9 (GND), U10.16 (GND); also elsewhere on the board

Notes on the sheet:
Using on module ipex connector
OUTPUTS
INPUTS

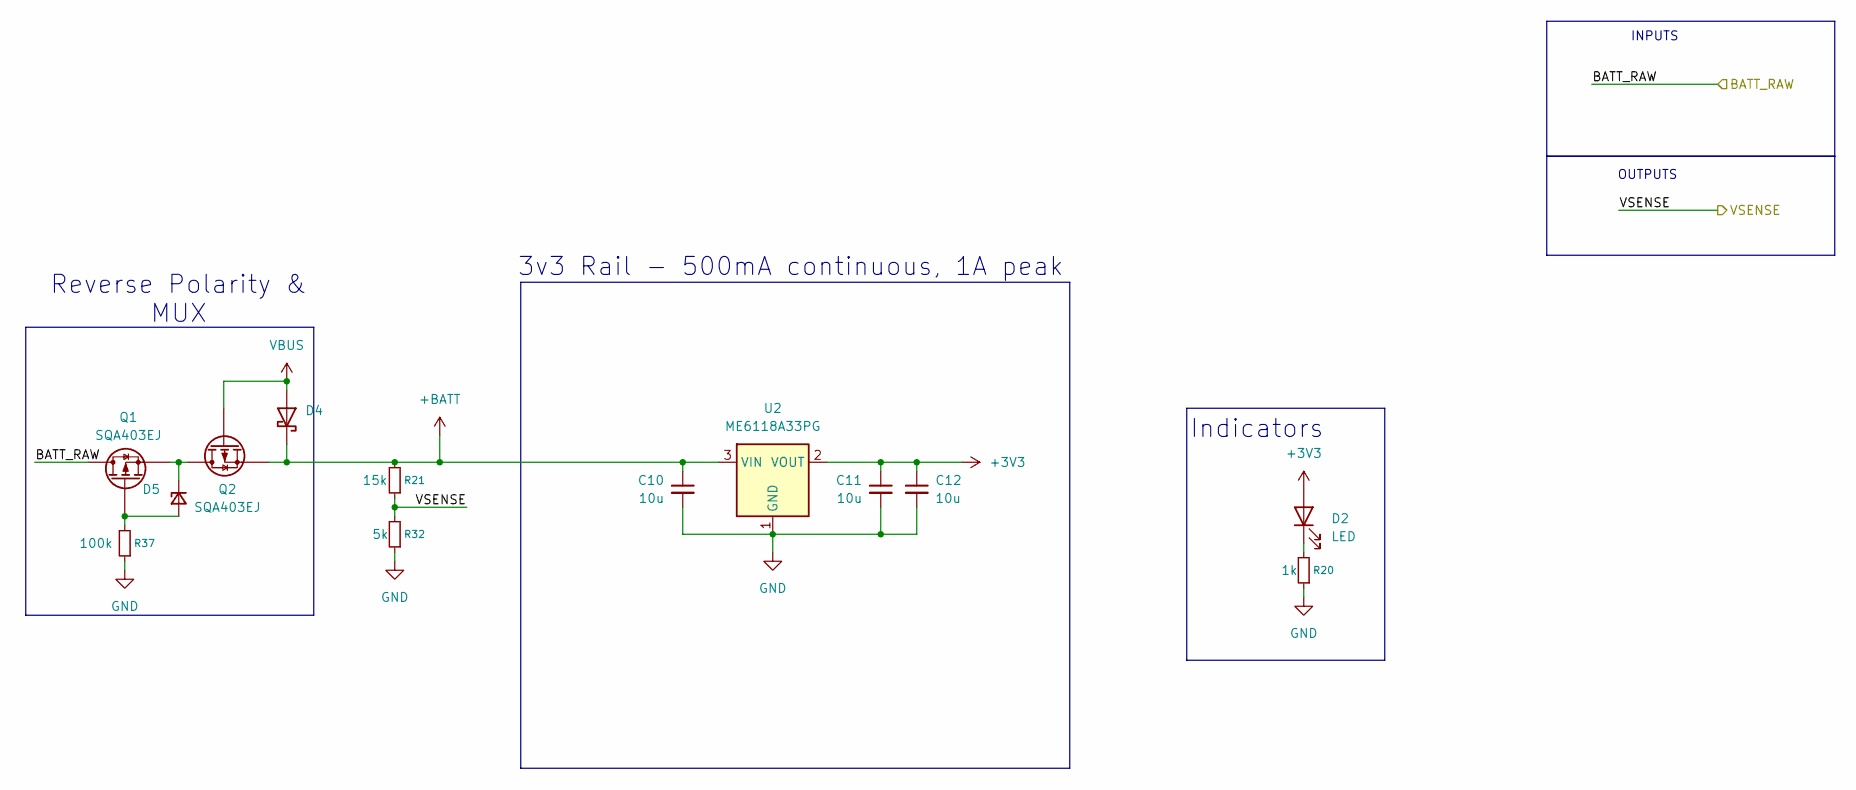
[picture p53: schematic power.kicad_sch]

Parts:
C10, C11, C12: 10u; C_0805_2012Metric; LCSC_Part C440198
D2: LED; LED_0603_1608Metric
D4: PMEG2020EH,115; D_SOD-123F; LCSC_Part C456104
D5: BZX584C10; D_SOD-523; LCSC_Part C22395577
Q1, Q2: SQA403EJ; Vishay_PowerPAK_SC70-6L_Single; LCSC_Part C7083947
R20: 1k; R_0402_1005Metric; LCSC_Part C11702
R21: 15k; R_0402_1005Metric
R32: 5k; R_0402_1005Metric
R37: 100k; R_0402_1005Metric
U2: ME6118A33PG; SOT-89-3; LCSC_Part C236721

Connections:
+3V3: C11.1, C12.1, D2.2 (A), U2.2 (VOUT); also elsewhere on the board
+BATT: C10.1, D4.1 (K), Q2.4 (S), R21.2, U2.3 (VIN)
/IO/BATT_RAW: Q1.1 (D); also elsewhere on the board
/MCU/VSENSE: R21.1, R32.2; also elsewhere on the board
GND: C10.2, C11.2, C12.2, R20.1, R32.1, R37.1, U2.1 (GND); also elsewhere on the board
unnamed: D2.1 (K), R20.2
unnamed: D5.2 (A), Q1.3 (G), R37.2
unnamed: D5.1 (K), Q1.4 (S), Q2.1 (D)
VBUS: D4.2 (A), Q2.3 (G); also elsewhere on the board

Notes on the sheet:
Indicators
OUTPUTS
INPUTS
Reverse Polarity & MUX
3v3 Rail - 500mA continuous, 1A peak

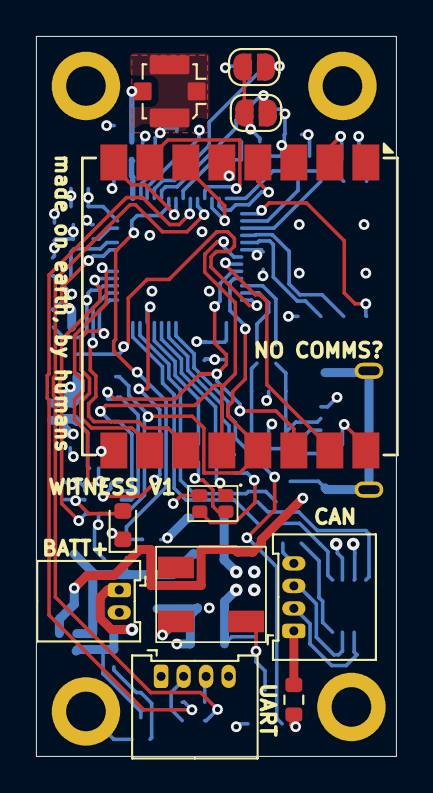
[picture p54: board witness.kicad_pcb from above]

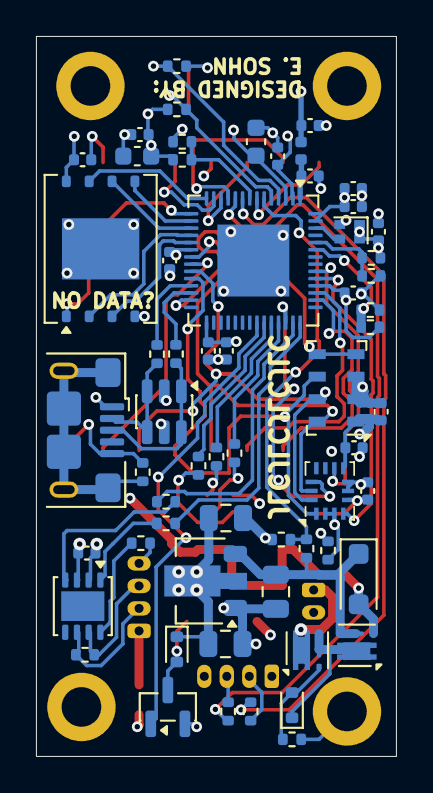
[picture p55: board witness.kicad_pcb from below]

Board: 4 copper layers, 20.0 x 40.0 mm, 76 parts (61 on the bottom side), 62 nets.
