prs2026/Witness/Hardware/witnessv0.2/aperture/aperture.kicad_pcb

## KiCad design Hardware/witnessv0.2/aperture/aperture.kicad_pcb (2026-09-07)

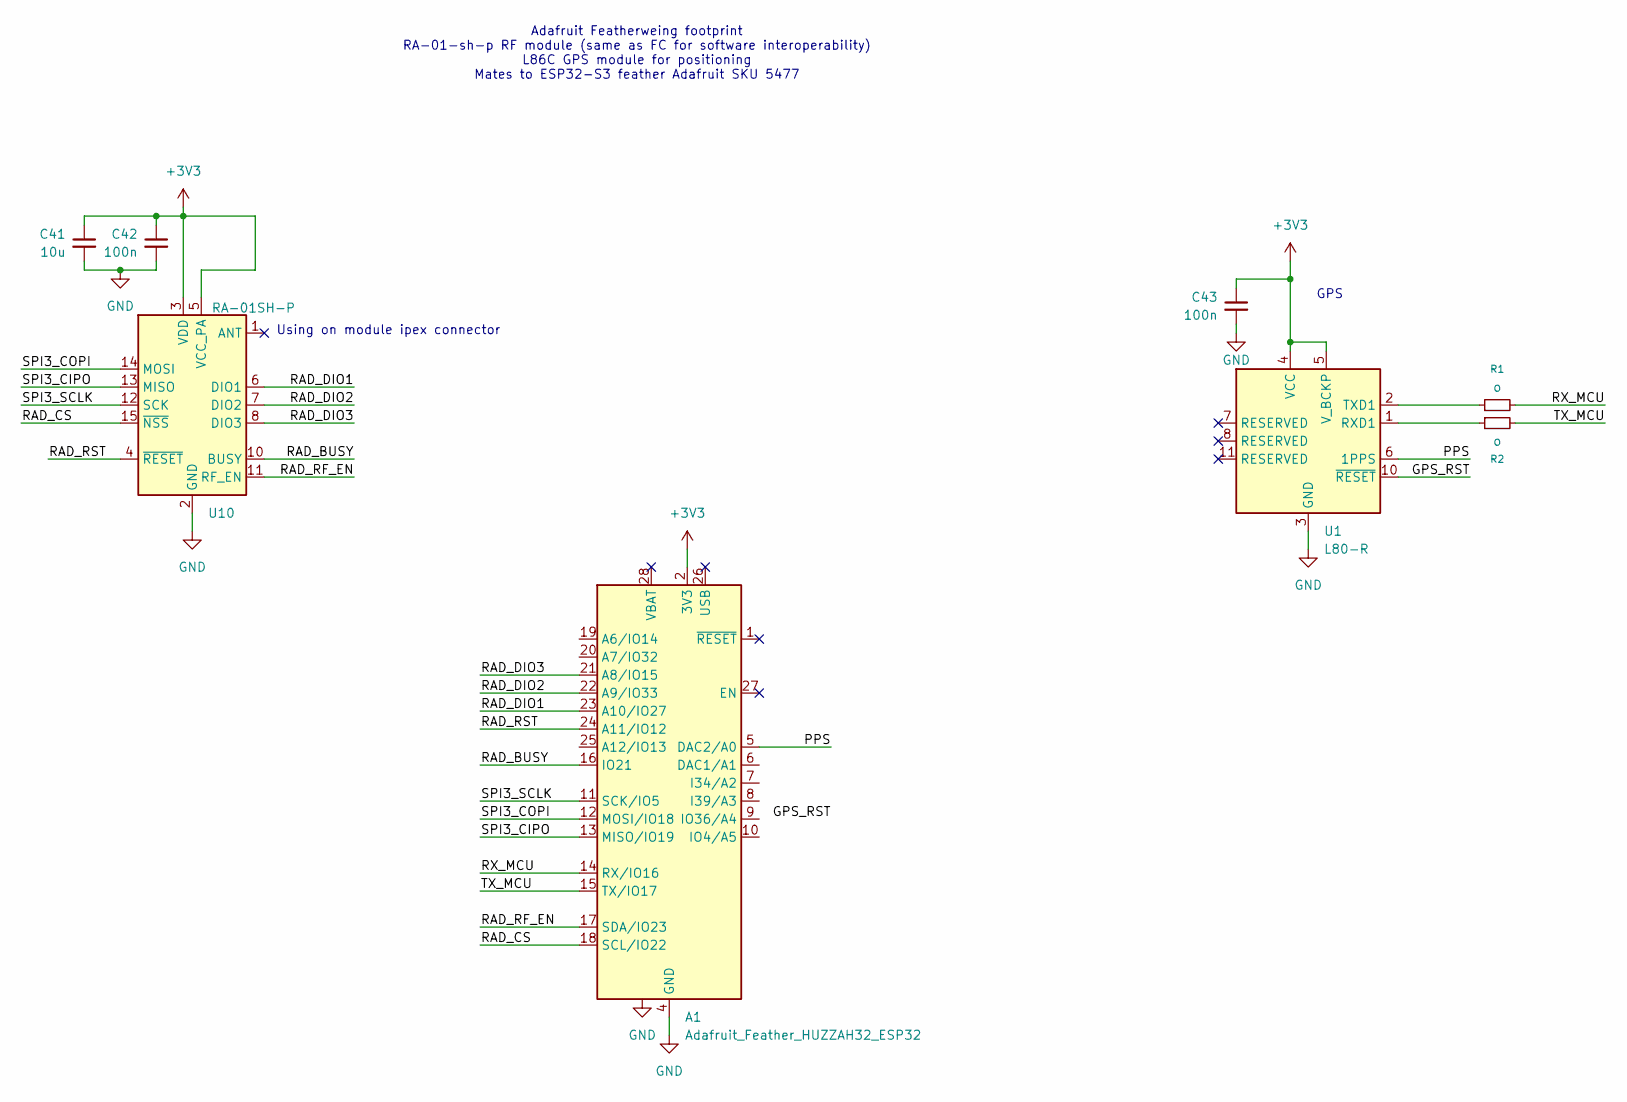
[picture p56: schematic aperture.kicad_sch]

Parts:
A1: Adafruit_Feather_HUZZAH32_ESP32; Adafruit_Feather
C41: 10u; C_0603_1608Metric; LCSC_Part C96446
C42, C43: 100n; C_0603_1608Metric; LCSC_Part C96446
R1, R2: o; R_0603_1608Metric
U1: L80-R; Quectel_L80-R
U10: RA-01SH-P; Ai-Thinker-Ra-01-LoRa

Connections:
+3V3: A1.2 (3V3), C41.1, C42.1, C43.1, U1.4 (VCC), U1.5 (V_BCKP), U10.3 (VDD), U10.5 (VCC_PA)
/GPS_RST: A1.9 (IO36/A4), U1.10 (~RESET)
/PPS: A1.5 (DAC2/A0), U1.6 (1PPS)
/RAD_BUSY: A1.16 (IO21), U10.10 (BUSY)
/RAD_CS: A1.18 (SCL/IO22), U10.15 (~NSS)
/RAD_DIO1: A1.23 (A10/IO27), U10.6 (DIO1)
/RAD_DIO2: A1.22 (A9/IO33), U10.7 (DIO2)
/RAD_DIO3: A1.21 (A8/IO15), U10.8 (DIO3)
/RAD_RF_EN: A1.17 (SDA/IO23), U10.11 (RF_EN)
/RAD_RST: A1.24 (A11/IO12), U10.4 (~RESET)
/RX_MCU: A1.14 (RX/IO16), R1.2
/SPI3_CIPO: A1.13 (MISO/IO19), U10.13 (MISO)
/SPI3_COPI: A1.12 (MOSI/IO18), U10.14 (MOSI)
/SPI3_SCLK: A1.11 (SCK/IO5), U10.12 (SCK)
/TX_MCU: A1.15 (TX/IO17), R2.2
GND: A1.4 (GND), C41.2, C42.2, C43.2, U1.3 (GND), U1.12 (GND), U10.2 (GND), U10.9 (GND), U10.16 (GND)
unnamed: R2.1, U1.1 (RXD1)
unnamed: R1.1, U1.2 (TXD1)

Notes on the sheet:
GPS
Using on module ipex connector
Adafruit Featherweing footprint RA-01-sh-p RF module (same as FC for software interoperability) L86C GPS module for positioning Mates to ESP32-S3 feather Adafruit SKU 5477

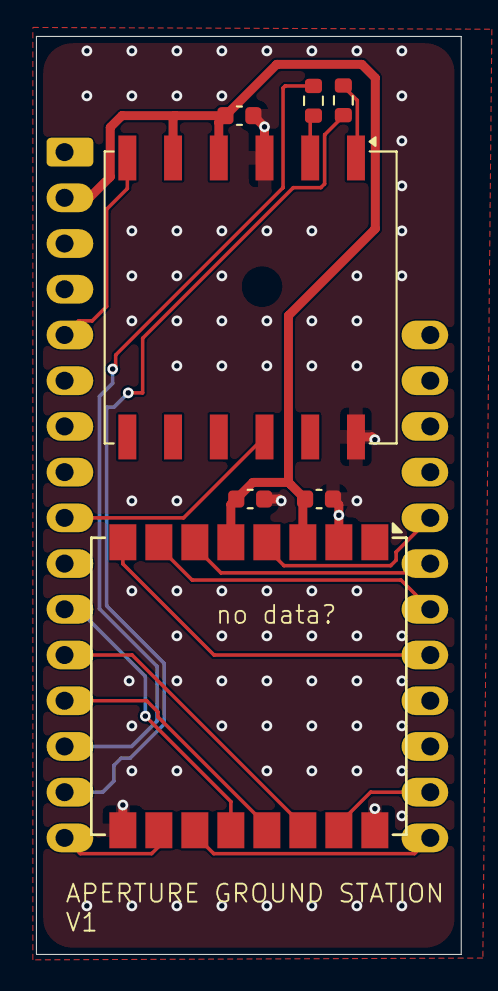
[picture p57: board aperture.kicad_pcb from above]

Board: 2 copper layers, 23.6 x 51.0 mm, 8 parts (0 on the bottom side), 18 nets.
