prs2026/Witness/Hardware/witnessv0.1/witnessv0.1.kicad_pcb

## KiCad design Hardware/witnessv0.1/witnessv0.1.kicad_pcb (2026-08-29)

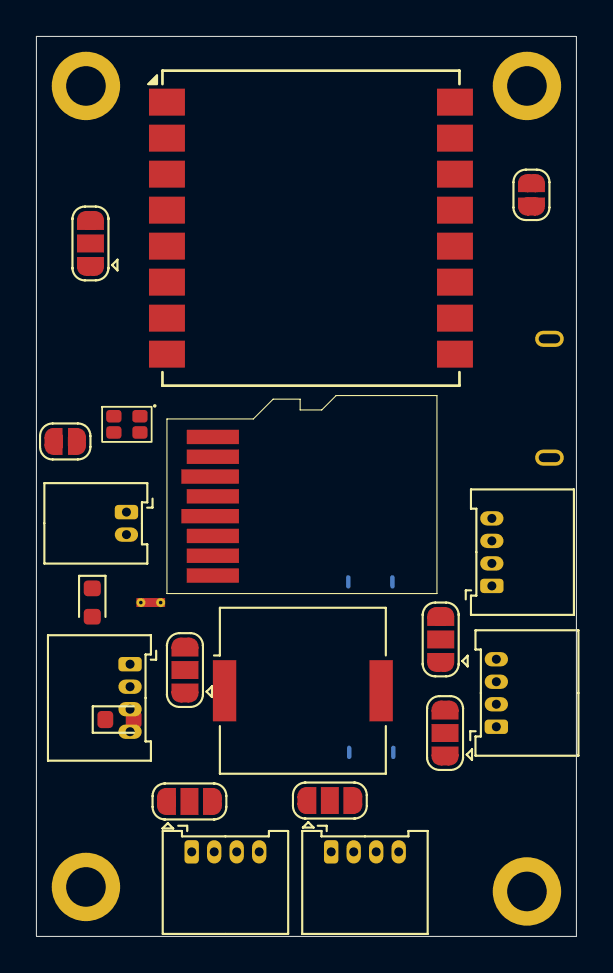
[picture p58: board witnessv0.1.kicad_pcb from above]

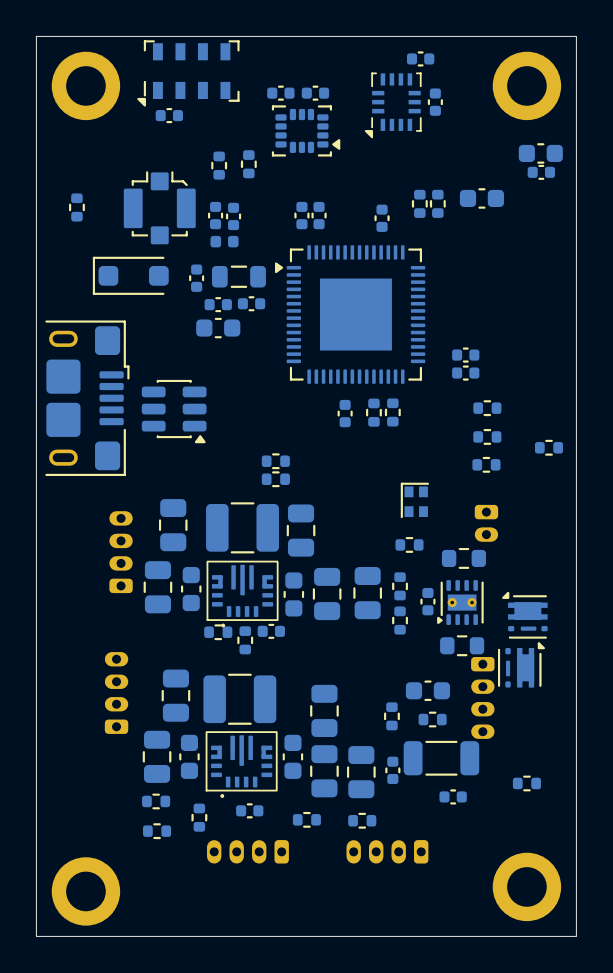
[picture p59: board witnessv0.1.kicad_pcb from below]

Board: 4 copper layers, 30.0 x 50.0 mm, 111 parts (87 on the bottom side), 57 nets, no tracks yet.

Parts:
AE1: Antenna_Shield; U.FL_Molex_MCRF_73412-0110_Vertical
BZ1: Buzzer; Buzzer_Murata_PKMCS0909E
C3, C4, C5, C7, C15, C16, C21, C26, C27, C28, C29, C32, C33, C34, C36, C37, C38, C39, C40, C42: 100n; C_0402_1005Metric
C6, C30: 1u; C_0402_1005Metric
C8, C9, C20, C22, C31, C41, C43: 10u; C_0603_1608Metric
C10, C11, C18, C19: 10u; C_0805_2012Metric
C12, C13, C14, C23, C24, C25: 22u; C_0805_2012Metric
C17: 470n; C_0603_1608Metric
D1: LED_RGBA; 0603x2 RGB
D2, D3: LED; LED_0603_1608Metric
D4: PMEG2020EH,115; D_SOD-123F
H4, H5, H6, H7: MountingHole_Pad; MountingHole_2.2mm_M2_DIN965_Pad
J1, J4: Conn_01x02; SolderJumper-2_P1.3mm_Open_RoundedPad1.0x1.5mm
J2: Conn_01x02; Molex_Micro_Lock_2200980271_01x02_Horizontal
J3: USB_B_Micro; USB_Micro-B_Amphenol_10118193-0002LF_Horizontal
J5, J6, J7, J8, J9: Conn_01x04; Molex_MicroLock-2200980471-01x04-Horizontal
J10: Micro_SD_Card; microSD_Card
JP1, JP2, JP3, JP4, JP5, JP6: SolderJumper_3_Open; SolderJumper-3_P1.3mm_Open_RoundedPad1.0x1.5mm
L1, L3: 1u; L_1210_3225Metric
L2: 2.2u; L_1206_3216Metric
L4: 10n; L_0805_2012Metric
L5: L_Small; L_0402_1005Metric
Q1, Q2: SQA403EJ; Vishay_PowerPAK_SC70-6L_Single
R1, R9: 100k; R_0402_1005Metric
R2: 470k; R_0402_1005Metric
R3: 150k; R_0402_1005Metric
R5: 4.7; R_0402_1005Metric
R6, R10, R12: 10k; R_0402_1005Metric
R7: 680k; R_0402_1005Metric
R8: 130k; R_0402_1005Metric
R11: 35k; R_0402_1005Metric
R17, R18, R19, R20, R21, R22: 1k; R_0402_1005Metric
R23, R24, R25, R26, R27, R28, R29: 4.7k; R_0402_1005Metric
R30, R31: 0; R_0402_1005Metric
R33, R34: 2.5m; R_0603_1608Metric
U1: ESP32-S3FN8; QFN-56-1EP_7x7mm_P0.4mm_EP4x4mm
U2, U6: TPS63070; RNM0015A
U3: INA2180A3IDSG; Texas_DSG0008A_WSON-8-1EP_2x2mm_P0.5mm_EP0.9x1.6mm_ThermalV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
U4: LSM6DSV320XTR; Bosch_LGA-14_3x2.5mm_P0.5mm
U5: ICM-45686; LGA-14_3x2.5mm_P0.5mm_LayoutBorder3x4y
U7: MS5607-02BA; LGA-8_3x5mm_P1.25mm
U9: USBLC6-2SC6; SOT-23-6
U10: RA-01SH-P; Ai-Thinker-Ra-01-LoRa
Y1: F322540MUBCE2O; Oscillator_SMD_Abracon_ASCO-4Pin_1.6x1.2mm

Connections:
+3V3: C3.1, C4.1, C5.1, C6.1, C16.1, C26.1, C27.1, C29.1, C30.1, C31.1, C34.1, C36.1, C37.1, C38.1, C39.1, C40.1, C41.1, C42.1, D1.4 (A), D2.2 (A), JP1.3 (B), JP2.3 (B), JP3.3 (B), JP4.3 (B), JP5.3 (B), JP6.1 (A), L2.2, L4.1, R5.1, R22.2, R23.2, R25.2, R26.2, R28.2, U1.20 (VDD3P3_RTC), U1.29 (VDD_SPI), U1.46 (VDD3P3_CPU), U1.55 (VDDA), U1.56 (VDDA), U3.8 (VS), U4.5 (VDDIO), U4.8 (VDD), U5.5 (VDDIO), U5.8 (VDD), U7.1 (VDD), U10.3 (VDD), Y1.1 (Tri-State), Y1.4 (VDD)
+5V: D3.2 (A), JP1.1 (A), JP2.1 (A), JP3.1 (A), JP4.1 (A), JP5.1 (A), JP6.3 (B), R34.2, U3.6 (-)
+BATT: J2.1, Q2.1 (D)
/IO/RXD_MCU: J5.3, J7.3, J8.3, J9.3
/IO/TXD_MCU: J5.2, J7.2, J8.2, J9.2
/IO/USB_D+: U9.1 (I/O1), U9.3 (I/O2)
/MCU/GPIO0: J4.1, R23.1, U1.5 (GPIO0)
/MCU/GPIO3: R28.1, R29.2, U1.8 (GPIO3)
/MCU/GPIO45: R26.1, R27.2, U1.51 (GPIO45)
/MCU/GPIO46: R24.2, R25.1, U1.52 (GPIO46)
/MCU/RST: J1.1, R22.1, U1.4 (CHIP_PU)
/MCU/XIN: U1.54 (XTAL_P), Y1.3 (OUT)
/Power/5VSENSE+: C22.1, C23.1, C24.1, C25.1, R7.1, R9.1, R34.1, U3.5 (+), U6.7 (VOUT), U6.8 (VOUT)
/Power/BATT_POSTSW: C9.1, C10.1, C11.1, C18.1, C19.1, C20.1, R6.1, R11.1, R12.1, R33.2, U2.12 (VIN), U2.13 (VIN), U3.2 (-), U6.12 (VIN), U6.13 (VIN)
/Power/ISENSE+: Q1.4 (S), R33.1, U3.3 (+)
/Sensors/I2C_SCL: U4.13 (SCL), U5.3 (MAS_CLK)
/Sensors/I2C_SDA: U4.14 (SDA), U5.2 (MAS_DA)
/Sensors/MS56_CS: U7.4 (CSB), U7.5 (CSB)
/Sensors/SPI1_CIPO: U4.1 (SDO/SA0), U5.1 (AP_SDO), U7.6 (SDO)
/Sensors/SPI1_COPI: U4.3 (SCX), U5.14 (AP_SDIO), U7.7 (SDI/SDA)
/Sensors/SPI1_SCLK: U4.2 (SDX), U5.11 (AP_SCLK), U7.8 (SCLK)
GND: AE1.2 (Shield), BZ1.2 (-), C3.2, C4.2, C5.2, C6.2, C7.2, C8.2, C9.2, C10.2, C11.2, C12.2, C13.2, C14.2, C15.2, C16.2, C17.2, C18.2, C19.2, C20.2, C21.2, C22.2, C23.2, C24.2, C25.2, C26.2, C27.2, C28.2, C29.2, C30.2, C31.2, C32.2, C33.2, C34.2, C36.2, C37.2, C38.2, C39.2, C40.2, C41.2, C42.2, C43.1, H4.1 (1_1), H5.1 (1_1), H6.1 (1_1), H7.1 (1_1), J1.2, J2.2, J3.5 (GND), J4.2, J5.4, J6.4, J7.4, J8.4, J9.4, Q1.3 (G), R3.2, R8.2, R10.2, R20.1, R21.1, R24.1, R27.1, R29.1, U1.57 (GND), U2.4 (GND), U2.6 (FB2), U2.10 (PGND), U2.15 (VSEL), U3.4 (GND), U3.9 (EP), U4.6 (GND), U4.7 (GND), U5.6 (GND), U6.4 (GND), U6.6 (FB2), U6.10 (PGND), U6.15 (VSEL), U7.2 (PS), U7.3 (GND), U9.2 (GND), U10.2 (GND), U10.9 (GND), U10.16 (GND), Y1.2 (GND)
unnamed: AE1.1 (A), C33.1, L5.2
unnamed: C8.1, C12.1, C13.1, C14.1, C15.1, L2.1, R1.1, R2.1, U2.7 (VOUT), U2.8 (VOUT)
unnamed: C17.1, R5.2
unnamed: C28.1, L4.2, U1.2 (VDD3P3), U1.3 (VDD3P3)
unnamed: D1.3 (BK), R19.2
unnamed: D1.2 (GK), R17.2
unnamed: D1.1 (RK), R18.2
unnamed: D2.1 (K), R20.2
unnamed: D3.1 (K), R21.2
unnamed: D4.1 (K), Q1.1 (D), Q2.4 (S)
unnamed: J3.3 (D+), U9.6 (I/O1)
unnamed: J3.2 (D-), U9.4 (I/O2)
unnamed: J5.1, JP1.2 (C)
unnamed: J6.1, JP2.2 (C)
unnamed: J7.1, JP3.2 (C)
unnamed: J8.1, JP4.2 (C)
unnamed: J9.1, JP5.2 (C)
unnamed: C43.2, JP6.2 (C), U10.5 (VCC_PA)
unnamed: R30.2, U1.25 (GPIO19/USB_D-)
unnamed: R31.2, U1.26 (GPIO20/USB_D+)
unnamed: C32.1, L5.1, U1.1 (LNA_IN)
unnamed: R10.1, R11.2, U2.14 (EN)
unnamed: R2.2, R3.1, U2.5 (FB)
unnamed: L1.1, U2.11 (L1)
unnamed: L1.2, U2.9 (L2)
unnamed: R1.2, U2.2 (PG)
unnamed: R12.2, U2.1 (PS/SYNC)
unnamed: C7.1, U2.3 (VAUX)
unnamed: R7.2, R8.1, U6.5 (FB)
unnamed: L3.1, U6.11 (L1)
unnamed: L3.2, U6.9 (L2)
unnamed: R9.2, U6.2 (PG)
unnamed: R6.2, U6.1 (PS/SYNC)
unnamed: C21.1, U6.3 (VAUX)
VBUS: D4.2 (A), J3.1 (VBUS), Q2.3 (G), U9.5 (VBUS)
