prs2026/Witness/Hardware/Ground Station/groundstation/groundstation.kicad_sch

## KiCad design Hardware/Ground Station/groundstation/groundstation.kicad_sch (2026-10-13)

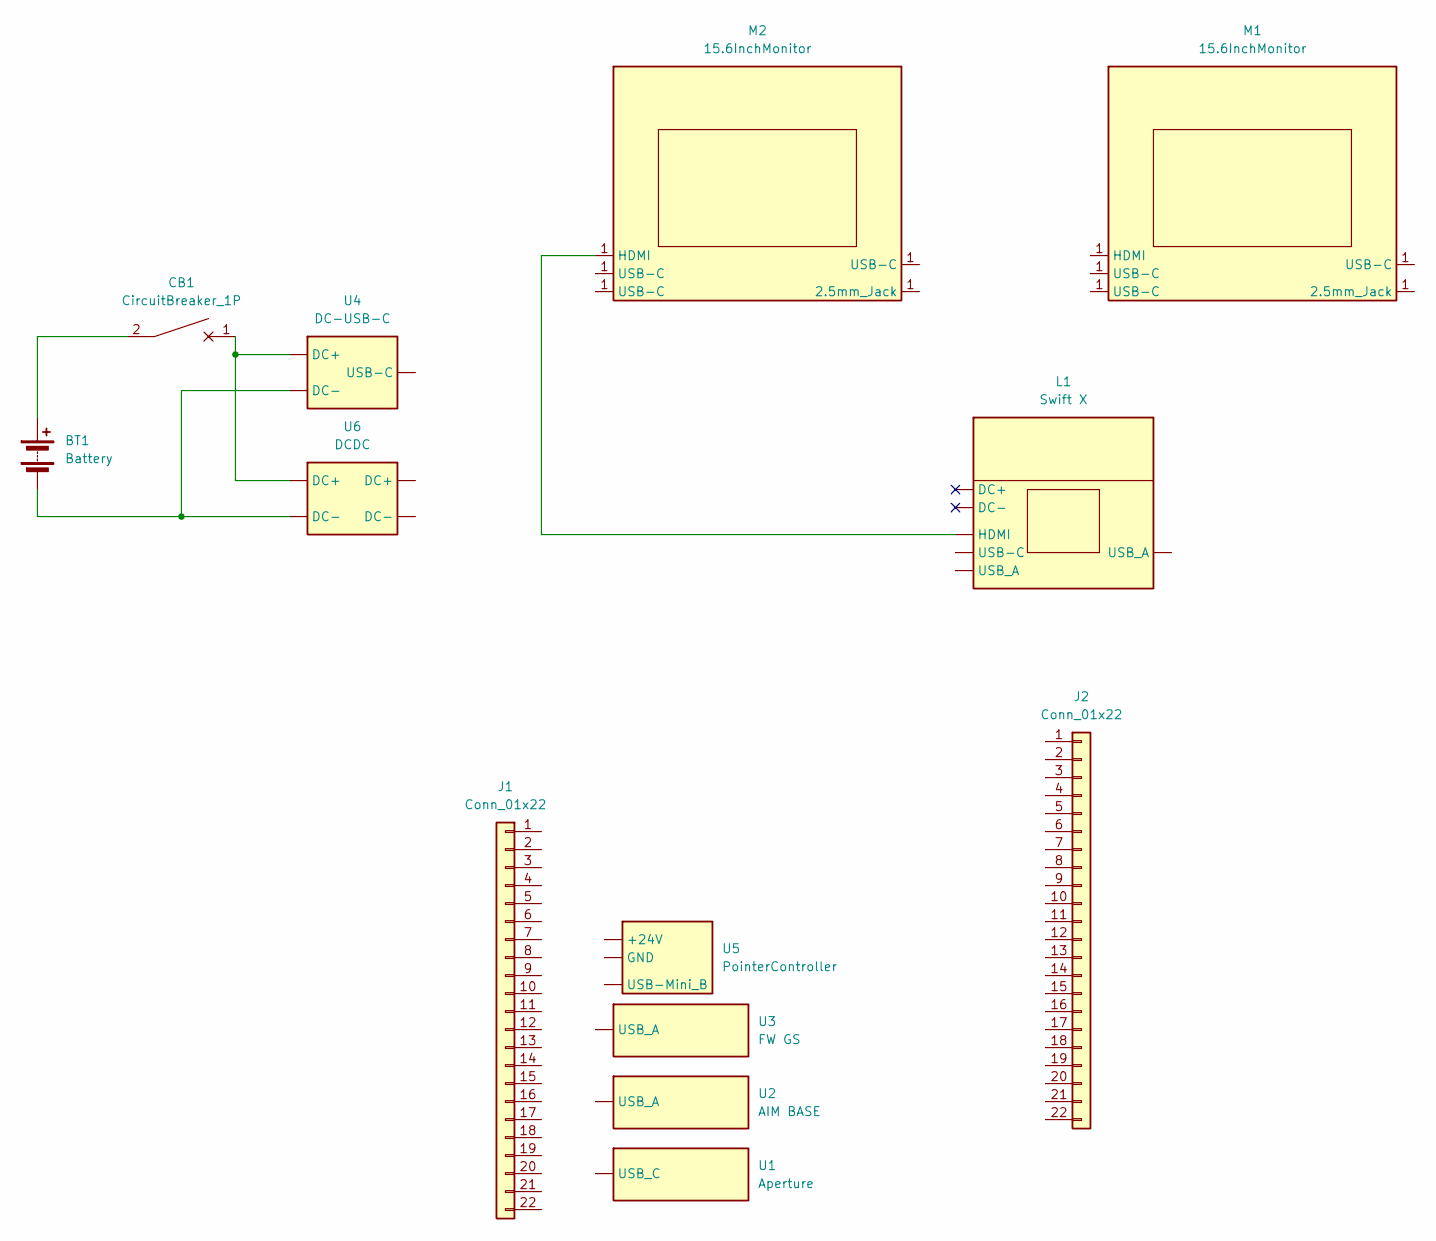
[picture p60: schematic groundstation.kicad_sch]

Parts:
BT1: Battery
CB1: CircuitBreaker_1P
J1, J2: Conn_01x22
L1: Swift X
M1, M2: 15.6InchMonitor
U1: Aperture
U2: AIM BASE
U3: FW GS
U4: DC-USB-C
U5: PointerController
U6: DCDC

Connections:
unnamed: BT1.1 (+), CB1.2
unnamed: BT1.2 (-), U4., U6.
unnamed: CB1.1, U4., U6.
unnamed: L1., M2.1
