prs2026/Witness/Software/Iris/softwarev1IRIS/main/hardware.h

#pragma once

#include "driver/gpio.h"
#include "driver/uart.h"

// Iris ESP32-C3FH4 board pin map.
// Keep all physical board connections here so application code does not use
// raw GPIO numbers.
#define IRIS_PIN_VSENSE GPIO_NUM_0
// The PCB net labels at U5 are reversed: the TCAN3414 TXD input is on the
// net named CANRX (GPIO3), and its RXD output is on CAN_TX (GPIO1). These
// definitions describe the TWAI signal direction, not the schematic net name.
#define IRIS_PIN_CAN_TX GPIO_NUM_3
#define IRIS_PIN_BUTTON GPIO_NUM_2
#define IRIS_PIN_CAN_RX GPIO_NUM_1
#define IRIS_PIN_I2C_SDA GPIO_NUM_4
#define IRIS_PIN_I2C_SCL GPIO_NUM_5
#define IRIS_PIN_UART1_TX GPIO_NUM_6
#define IRIS_PIN_UART1_RX GPIO_NUM_7
#define IRIS_PIN_LED_RED GPIO_NUM_8
#define IRIS_PIN_LOAD_SWITCH_ENABLE GPIO_NUM_9
#define IRIS_PIN_LED_GREEN GPIO_NUM_10
#define IRIS_PIN_USB_D_MINUS GPIO_NUM_18
#define IRIS_PIN_USB_D_PLUS GPIO_NUM_19
#define IRIS_PIN_UART0_RX GPIO_NUM_20
#define IRIS_PIN_UART0_TX GPIO_NUM_21

// UART1 is the secondary packet transport. Complete application packets are
// sent directly as byte streams using the same framing as USB.
#define IRIS_UART1_PORT UART_NUM_1
#define IRIS_UART1_BAUD_RATE 115200U

// ESP32-C3 Classical CAN controller connected to the 3.3 V TCAN3414.
// STB (pin 8) is strapped low; SHDN (pin 5) may use its internal pulldown.
// Both ESP32 peers use Classical CAN, not CAN FD, despite transceiver FD support.
#define IRIS_TWAI_BITRATE 500000U

// Battery voltage monitor on GPIO0/ADC1 channel 0. The battery is connected
// through a 15 kohm high-side and 5 kohm low-side divider (4:1 ratio).
#define IRIS_BATTERY_DIVIDER_HIGH_OHMS 15000U
#define IRIS_BATTERY_DIVIDER_LOW_OHMS 5000U
#define IRIS_BATTERY_ADC_SAMPLE_COUNT 16U
#define IRIS_BATTERY_VOLTAGE_READ_INTERVAL_MS 1000U

// MCP23008 I/O expander. A2:A0 are tied low, giving address 0x20.
#define IRIS_MCP23008_I2C_ADDRESS 0x20U
#define IRIS_MCP23008_PIN_OUT1_ENABLE 0U
#define IRIS_MCP23008_PIN_OUT2_ENABLE 1U
#define IRIS_MCP23008_PIN_OUT3_ENABLE 2U
#define IRIS_MCP23008_PIN_5V_ENABLE 3U
#define IRIS_MCP23008_PIN_LED_BLUE 7U

#define IRIS_MCP23008_MASK_OUT1_ENABLE \
    (1U << IRIS_MCP23008_PIN_OUT1_ENABLE)
#define IRIS_MCP23008_MASK_OUT2_ENABLE \
    (1U << IRIS_MCP23008_PIN_OUT2_ENABLE)
#define IRIS_MCP23008_MASK_OUT3_ENABLE \
    (1U << IRIS_MCP23008_PIN_OUT3_ENABLE)
#define IRIS_MCP23008_MASK_5V_ENABLE \
    (1U << IRIS_MCP23008_PIN_5V_ENABLE)
#define IRIS_MCP23008_MASK_LED_BLUE \
    (1U << IRIS_MCP23008_PIN_LED_BLUE)

// The expander RESET input shares the LS_EN net.
#define IRIS_PIN_MCP23008_RESET IRIS_PIN_LOAD_SWITCH_ENABLE

// PAC193x current monitor. ADDRSEL is tied to ground. Channels 1-3 each
// use a 20 milliohm shunt on the Iris board.
#define IRIS_PAC1931_I2C_ADDRESS 0x10U
#define IRIS_PAC1931_CHANNEL_COUNT 3U
#define IRIS_PAC1931_SENSE_RESISTOR_MICROOHMS 20000U
// Empirical board calibration: measured currents are five times the applied
// current when converted using only the nominal 20 milliohm shunt value.
#define IRIS_PAC1931_CURRENT_CALIBRATION_DIVISOR 5U
