prs2026/Witness/Software/Horizon/ground_settings.py

"""Connection defaults shared by the Witness app and Horizon unified app."""

# The Witness feed is receive-only (no command bridge). The local feed binds
# 127.0.0.1 only; the remote feed is a second, independent server bound to
# this PC's Tailscale address only (never the LAN or the internet), so
# another machine on the tailnet can watch telemetry.
WITNESS_FEED_HOST = "127.0.0.1"
WITNESS_FEED_PORT = 8766
WITNESS_REMOTE_FEED_PORT = 8767

DEFAULT_AIM_MQTT_HOST = "localhost"
DEFAULT_AIM_MQTT_PORT = 1883
DEFAULT_AIM_MQTT_UUID = "124"
DEFAULT_AIM_MQTT_BASE_PATH = "entacore/aim/1234"

# Embedded broker is local-only (no authentication/TLS). Independent of the
# subscriber host/port, which may point at an external broker instead.
DEFAULT_MQTT_BROKER_ENABLED = True
DEFAULT_MQTT_BROKER_PORT = 1883
