prs2026/Witness/Software/Horizon/gps_assist.py

"""GPS assistance for the Witness receiver: RINEX broadcast ephemeris ->
SkyTraq "Set GPS Ephemeris" (0x41) messages -> chunked 0x05 command frames.

Research summary (SkyTraq AN0037, Phoenix binary messages): the PX1120S has
no almanac-upload message. It does accept GPS ephemeris over UART, 0x41 "Set
GPS Ephemeris" (87-byte payload: SV id, then subframes 1-3, each a reserved
byte plus the 24 data bits of words 2-10), and answers ACK 83 41 / NACK 84 41.
Ephemeris is strictly better than almanac for time to first fix: with it the
receiver computes positions as soon as it has code phase and time, instead of
decoding subframes 1-3 from each satellite (18-30 s at best). The u-blox M8
would take UBX-MGA-GPS-ALM/EPH; that path is not implemented (firmware refuses
it with a log line).

Firmware path (Software/Witness/softwarev1/main/gps_assist.h): the blob is
records of [u16 length][SkyTraq body]; it is sent as 0x05 command frames
BEGIN (0x4741) / DATA (0x4744, 4 bytes each at a byte offset) / COMMIT
(0x4745), which work over USB, the radio and CAN. Witness verifies a CRC-16,
then writes each record to the receiver and logs ACK/NACK counts.

The same ephemerides drive gps-sdr-sim (HITL RF simulation): shift_to() moves
a RINEX file to the scenario start time (like gps-sdr-sim -T, but in one place
so the uploaded and transmitted ephemerides are identical) and write_rinex2()
writes the file gps-sdr-sim reads.
"""

from __future__ import annotations

import argparse
import dataclasses
import datetime as dt
import math
import re
import struct
import sys
import time
from pathlib import Path

# Command opcodes (comms.h IRIS_COMMAND_GPS_ASSIST_*).
CMD_BEGIN, CMD_DATA, CMD_COMMIT, CMD_STATUS = 0x4741, 0x4744, 0x4745, 0x4751
FORMAT_SKYTRAQ = 1
MAX_BLOB = 4096
CHUNK = 4
SKYTRAQ_SET_GPS_EPHEMERIS = 0x41
EPHEMERIS_BODY_LENGTH = 87
GPS_EPOCH = dt.datetime(1980, 1, 6)
SECONDS_IN_WEEK = 604800
GPS_UTC_LEAP_S = 18          # GPS - UTC since 2017-01-01
PI = 3.1415926535898         # IS-GPS-200 value (as gps-sdr-sim)


# ----------------------------------------------------------------- GPS time
def gps_from_datetime(t: dt.datetime) -> tuple[int, float]:
    """(week, seconds of week) for a GPS-time calendar date (no leap seconds)."""
    delta = (t - GPS_EPOCH).total_seconds()
    week = int(delta // SECONDS_IN_WEEK)
    return week, delta - week * SECONDS_IN_WEEK


def datetime_from_gps(week: int, sec: float) -> dt.datetime:
    return GPS_EPOCH + dt.timedelta(seconds=week * SECONDS_IN_WEEK + sec)
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
