prs2026/Witness/(commit log)

2026-08-24 inti layout
    [IO.kicad_sch, MCU.kicad_sch, Sensors.kicad_sch, power.kicad_sch, witnessv0.1.kicad_pcb, witnessv0.1.kicad_sch]
2026-08-25 esp32 mcu
    [MCU.kicad_sch, Sensors.kicad_sch, witnessv0.1.kicad_pcb]
2026-08-27 power updates and some esp32 stuff
    [10164359-00011LF.STEP, IO.kicad_sch, MCU.kicad_sch, Sensors.kicad_sch, power.kicad_sch, radio.kicad_sch, witnessv0.1.kicad_pcb, witnessv0.1.kicad_sch]
2026-08-27 mcu updates
    [MCU.kicad_sch]
2026-08-28 mcu work
    [MCU.kicad_sch, power.kicad_sch]
2026-08-28 lots of work
    [IO.kicad_sch, MCU.kicad_sch, Sensors.kicad_sch, power.kicad_sch, radio.kicad_sch, witnessv0.1.kicad_pcb, witnessv0.1.kicad_sch]
2026-08-29 micro lock conenctors and sd card soldered to baord and inital palcement done.
    [10118193-0001lfc.stp, 2200980271.stp, 2200980471.stp, IO.kicad_sch, MCU.kicad_sch, Micro SD Card.STEP, Sensors.kicad_sch, power.kicad_sch]
2026-08-30 first jlc export, moving to multi board
    [BOM-witnessv0.1.csv, IO.kicad_sch, MCU.kicad_sch, Sensors.kicad_sch, power.kicad_sch, radio.kicad_sch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]
2026-08-30 trying to split it, in progress
    [BOM-witnessv0.1.csv, IO.kicad_sch, MCU.kicad_sch, Sensors.kicad_sch, power.kicad_sch, radio.kicad_sch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]
2026-08-30 spliting more trying
    [BOM-witnessv0.1.csv, IO.kicad_sch, MCU.kicad_sch, Sensors.kicad_sch, power.kicad_sch, radio.kicad_sch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]
2026-08-31 witness in some state, iris init
    [BOM-witnessv0.1.csv, IO.kicad_sch, MCU.kicad_sch, Sensors.kicad_sch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]
2026-08-31 step export attempt
    [witnessv0.2.step]
2026-09-01 iris rework
    [IO.kicad_sch, MCU.kicad_sch, Sensors.kicad_sch, iris.kicad_pcb, iris.kicad_sch, power.kicad_sch, radio.kicad_sch, witness.kicad_pcb]
2026-09-02 trying to make cam board
    [2Aloadswitch.kicad_sch, MCU.kicad_sch, iris.kicad_sch, power.kicad_sch]
2026-09-02 lots of iris work
    [IO.kicad_sch, MCU.kicad_sch, iris.kicad_sch, loadswitches.kicad_sch]
2026-09-03 push for andrew
    [IO.kicad_sch, MCU.kicad_sch, iris.kicad_sch, loadswitches.kicad_sch]
2026-09-03 i2c io expander and repinning things
    [IO.kicad_sch, MCU.kicad_sch, loadswitches.kicad_sch]
2026-09-03 iris inital layout
    [IO.kicad_sch, MCU.kicad_sch, iris.kicad_pcb, iris.kicad_sch, loadswitches.kicad_sch, power.kicad_sch, witness.kicad_pcb]
2026-09-03 for foo & root
    [MCU.kicad_sch, RA-01 SH.step, iris.kicad_pcb, iris.kicad_sch, witness.kicad_pcb]
2026-09-03 step export of both
    [irisv0.2.step, witnessv0.2.step]
2026-09-03 exported drawings and step files
    [irisv0.2.step, witnessv0.2.step]
2026-09-04 root feedback
    [BOM-iris.csv, BOM-witness.csv, IO.kicad_sch, MCU.kicad_sch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]
2026-09-04 few layout updates
    [iris.kicad_pcb]
2026-09-05 updates from folks
    [IO.kicad_sch, MCU.kicad_sch, iris.kicad_pcb, iris.kicad_sch, loadswitches.kicad_sch, power.kicad_sch, witness.kicad_pcb]
2026-09-05 schematic notes on the sheets
    [iris.kicad_sch, witness.kicad_sch]
2026-09-06 aperture init, probabaly good to order
    [User Library-l86-1.STEP, aperture.kicad_pcb, aperture.kicad_sch]
2026-09-06 aperture ready for order probably
    [BOM-aperture.csv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]
2026-09-07 aperture release 1
    [aperture-CuBottom.gbr, aperture-CuTop.gbr, aperture-EdgeCuts.gbr, aperture-MaskBottom.gbr, aperture-MaskTop.gbr, aperture-NPTH.drl, aperture-PTH.drl, aperture-PasteBottom.gbr]
2026-09-07 witness release
    [BOM-witness.csv, IO.kicad_sch, iris.kicad_sch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]
2026-09-07 iris release
    [BOM-iris.csv, MCU.kicad_sch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]
2026-09-09 firmware init
    [iris.kicad_pcb]
2026-09-16 hella work, iris heats up hella.
    [AMA comms standard.xlsx]
2026-09-16 soldered new board, not heating up anymore
2026-09-16 update esp32 c3 build and flash script
2026-09-18 lsm6dsv driver attempt
2026-09-18 iris load switches flipping
2026-09-18 baro works, battery voltage works, horizon exists
    [AMA comms standard.xlsx]
2026-09-18 more comms protocol stuff and data viewing
    [AMA comms standard.xlsx]
2026-09-19 lots of stuff working, tailscale doing stuff over tcp so i can debug from wherever. parser working like enough for flight
    [AMA comms standard.xlsx, AMA_comms_standard.xlsx]
2026-09-21 flash chip reads back, ra-01 works on all boards
2026-09-23 can doesnt work, usb mass storage does
    [S0000006.csv, S0000009.csv, S0000010.csv]
2026-09-23 commands over uart might work
2026-09-24 it all works i think
    [S0000001.csv, S0000010.csv, S0000434.csv]
2026-10-30 iris r2 and various breakout boards
2026-11-01 ublox export and upload, 5.10 for 5 boards
2026-11-08 Untrack ESP-IDF build output, pin S3 targets, update bench port map
    - Stop tracking the committed build/ folders (Witness, Iris, Aperture v1,
    blink) and ignore build/. They carried another machine's absolute paths
    and broke configure on this one. Move skytraq_i2c_reference.pdf out of
    Witness build/ so it stays tracked.
    - Pin Witness and Aperture to esp32s3 in CMakeLists.txt, as Iris already
    pins esp32c3; a fresh checkout otherwise falls back to the plain ESP32.
    - Aperture sdkconfig.defaults: console on USB Serial/JTAG.
    - Bench port map: Aperture 7000/7100, Iris 7001/7101 in flash scripts,
    bench_check.py, setup notes and handoff docs.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
2026-11-08 Detect PX1120S or u-blox M8 GPS and configure airborne 4 g at max rate
    GpsReceiver identifies the UART GPS by which binary protocol answers a
    poll (SkyTraq 64 18 or UBX MON-VER). A receiver already streaming at
    115200 is never baud-probed; only a silent link is retried at 9600 and a
    u-blox found there is moved to 115200 with CFG-PRT.
    - PX1120S: airborne mode 5, 25 Hz, NMEA GGA+RMC; mode and rate read back.
    - NEO-M8N: dynModel 8 (airborne <4 g), 10 Hz, NMEA GGA+RMC; CFG-NAV5 and
    CFG-RATE read back.
    - HW_MCU_UART_SWAP_RX_TX (currently 1) swaps UART1 RX/TX for the fitted
    u-blox harness.
    - Host tests in tests/gps_receiver_test.cpp; docs list every frame and
    the reduced NAND time for raw G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
2026-11-08 Add GPS satellites and lock bit to telemetry; add Witness HITL mode
    Protocol (all four comms.h copies):
    - State packet 0x02 gains uint8 GPS satellites at payload offset 62;
    frame grows from 64 to 65 bytes (still 13 CAN fragments).
    - Witness status byte 1 bit 3 = GPS locked, bit 4 = HITL active.
    - Commands 0x4849 HITL enter (USB only, Pad Idle only) and 0x4858 exit.
    - New 0x0C HITL sensor input packet (47 bytes, host -> Witness, USB only):
    native IMU, baro, GPS and battery counts.
    Firmware:
    - NmeaGps parses GGA fix quality and satellites; state packet and lock
    bit fed from the fresh fix.
    - HITL: hitl_input decodes 0x0C frames and owns enter/exit/1 s timeout;
    Sensors substitutes the s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
2026-11-08 Horizon: decode 65-byte state packet, show GPS sats/lock and HITL
    - Decode gps_satellites and status byte 1 gps_locked / hitl_active in the
    monitor, Flight View, telemetry tab and converter (new CSV columns).
    - Monitor shows "GPS sats N lock 0/1" plus lock and HITL indicators;
    Flight View GPS panel shows sats with lock next to it, and the state row
    shows a red HITL ACTIVE - SIMULATED SENSORS line.
    - Echoed 0x0C HITL frames are recognized and skipped.
    - Legacy 64-byte state frames still decode when unambiguous.
    - Monitor buttons for HITL enter/exit (manual only).
    - Test data uses 65-byte frames; new tests in test_gps_hitl_protocol.py.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
2026-11-08 Add HITL simulation tool (Tkinter GUI and headless runner over TCP)
    Software/HITL streams simulated sensor data to Witness as 0x0C frames at
    100 Hz over the bench's raw TCP port, decodes the returned telemetry and
    compares Witness's flight-state transitions with a reference model of the
    firmware rules. Presets cover nominal, long burn, high-g, GPS dropout, no
    fix, sea level, pad abort and a quick test hop. Runs are saved under
    runs/ (ignored). Only HITL enter/exit and 0x0C frames are ever sent.
    Tests run against a local fake Witness. Verified on the bench: the
    "Quick hop (test)" preset passes headless against real Witness.
2026-11-08 Add 100 Hz gyro attitude estimator; non-blocking LoRa TX; 500 Hz tick
    Quaternion convention (all comms.h copies): Hamilton, body->world, world
    ENU, body +X = nose, all-zero = unavailable.
    - attitude_estimator: on the pad, 1 s stationary windows (accel-gated,
    gyro median/MAD with bounded outliers) set tilt by shortest-arc
    alignment and the gyro bias (median); snap-back per window. Gyro is
    propagated through the >10 g launch window, then integrated (exact
    quaternion exponential, real dt) from Boost to Landed and held there.
    5-sample running median rejects 1-2 sample gyro spikes (20 ms lag).
    - Quaternion now populated in state 0x02 and debug 0xE0.
    - Sensors loop runs on a 10 ms deadl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
2026-11-08 Horizon: add Attitude tab for Witness quaternion verification
    Separate tab (Flight View unchanged) rendering a 3D wireframe rocket from
    the live 0xE0/0x02 quaternion, with quaternion/norm, tilt, azimuth, spin
    and ZYX Euler readouts and a strip chart. File mode replays converter or
    HITL attitude CSVs with a truth ghost and heading-aligned error. Pure
    math in attitude_math.py with tests.
2026-11-08 HITL: drive runs from trajectory CSVs and verify Witness attitude
    trajectory_csv converts a 6-DOF trajectory export (units parsed from
    headers) to 100 Hz 0x0C frames: specific force from differentiated ENU
    velocity, velocity-aligned truth attitude held after apogee, gyro derived
    from the truth quaternion, multi-layer ISA pressure, pad hold and
    post-landing hold. Attitude is compared via tilt and heading-aligned
    error; attitude.csv uses the Horizon Attitude-tab layout. The tool may
    now also send the Witness debug start command 0x00E0. Bundled fixture:
    trajectories/a3241569-trajectory.csv.
2026-11-08 LSM6: accel anti-aliasing LPF2, fix CTRL6 bit 3; enable 0xE0 over USB
    From the LSM6DSV320X datasheet (DS14623 Rev 3):
    - Low-g accel now runs at 960 Hz with LPF2 at ODR/45 = 21.3 Hz
    (CTRL1 0x09, CTRL8 0x63, CTRL9 0x08), so it is band-limited below the
    50 Hz Nyquist rate of the 100 Hz read (LPF1 alone was ODR/2 = 60 Hz).
    - CTRL6 bit 3 must be 1 (Table 64); firmware wrote 0x04. Now 0x0C.
    - Gyro LPF1 stays off. Bench A/B (same session, radio on): LPF1 raised
    z noise from 76 to 114 dps sd at 120 Hz and to 177 dps at 960 Hz, and
    turned the interference into a -38/-60 dps bias; the estimator never
    initialized. Results tabulated in FIRMWARE_HANDOFF.md.
    USB: a canonical 05 .. 00 E0 0A fram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
2026-11-09 Witness monitor: keep up with fast streams; capture GPS NMEA
    The monitor did all display work per event inside a 20 ms budget per
    50 ms tick: a console insert and log flush per line, a hex dump per raw
    chunk, every label and a full graph redraw per packet. A fast stream
    queued faster than it drained, so the display fell ever further behind
    (bench, 500 pkt/s: lag grew 0.93 s per second, 7.5 s after 8 s, 7,448
    events queued). Graph times were also taken at display time.
    - Each tick drains the whole queue. Graph history keeps every sample,
    stamped with its arrival time; labels and status indicators show the
    newest packet of each type; graphs redraw at most 10 times a second;
    console line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
2026-11-09 Witness: 1 kHz tick and 500 Hz sensor/attitude loop
    - CONFIG_FREERTOS_HZ 500 -> 1000 (the ESP-IDF maximum).
    - Sensors::kTaskRateHz 100 -> 500 (2 ticks). The estimator steps once
    per fresh gyro sample; its timing (nominal 2 ms, late > 3 ms, 250-
    sample minimum window) comes from Sensors::attitude_config(). Window
    buffer 200 -> 1024 samples.
    - Gyro 120 -> 960 Hz with LPF1 code 100 (100 Hz bandwidth, Table 66).
    Bench, radio on: 499.7-500.0 Hz, max dt 8.5 ms (~8 late steps and ~15
    deadline overruns per 10 s, max pass 2.9 ms vs 2 ms), no resets,
    attitude valid and matching accelerometer tilt. FIRMWARE_HANDOFF.md
    records these results, the 500 Hz flash-logging estimate and open
    issues.
    Co-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
2026-11-09 Witness: 960 Hz FIFO IMU path, core pinning, flash store v3
    - LSM6DSV320X gyro and low-g at 7.68 kHz ODR with on-chip low-pass
    filters (gyro LPF1+LPF2 407 Hz, low-g LPF2 384 Hz), high-g at 960 Hz,
    all batched into the FIFO at 960 Hz. The sensor task drains the FIFO
    each 2 ms pass in one DMA SPI burst, groups words by TAG_CNT, and steps
    the attitude estimator and the NAND IMU log once per sample. The
    sample clock uses the INTERNAL_FREQ_FINE-corrected period, steered
    toward esp_timer.
    - Pin the sensors task to core 1 (reserved for estimation and the
    planned Kalman filter); everything else goes to core 0. Core-1 SPI uses
    polling transactions. Add a 10 s CPU load monitor from Fre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
2026-11-09 Witness: stored IMU calibration and calibrated telemetry
    The bench showed consistent gyro offsets (x about +0.6 to +0.9 dps,
    z about -0.4 to -0.9 dps, drifting with warm-up) and the low-g accel
    reading 0.992 g.
    - imu_calibration: gyro bias from a 4 s still capture (median, so
    interference spikes don't skew it), and a six-face accelerometer
    calibration. A Gauss-Newton fit makes every face exactly 1 g, so a
    tilted face doesn't bias the scale. Also gives the high-g offset.
    Host-tested.
    - Stored in NVS (namespace imu_cal) by a short core-0 task. Applied to
    the values the estimator, state machine and telemetry use; the NAND
    IMU stream and HITL data stay raw.
    - Telemetry gyro also sub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
2026-11-09 Horizon: download Witness flash logs through the bench Pi
    witness_download.py runs on this computer. It sends the existing
    05 68 68 USB export command over the Witness raw TCP data port, waits
    for the read-only WITNESSLOGS disk on the Pi, and reads it over SSH with
    witness_pi_agent.py. That stdlib FAT16 reader is piped to python3 -, so
    nothing is installed or mounted on the Pi. Files are saved under
    logs/witness_<timestamp>/, with optional conversion to CSV, viewer.py
    launch, and a hub power-cycle to bring Witness back. `setup` installs a
    udev rule (group plugdev) so the Pi user can read the disk.
    No firmware changes.
2026-11-09 Witness: filtered acceleration with instant low-to-high-g switch
    Filtered accel (accel_filter.{h,cpp}) runs on every 960 Hz FIFO sample:
    - Uses calibrated low-g. From the first sample where any axis of either
    sensor reaches 15 g it uses high-g for all three axes, on that same
    sample. Back to low-g after 10 samples with all axes below 13 g. Both
    sensors feed the trigger because the chip filters the low-g after its
    ADC clips.
    - 2nd-order Butterworth low-pass at 100 Hz (about 2.5 ms delay). Its
    state carries across a switch, so switching adds no step.
    - Feeds the 0x01/0xE0 filtered_accel fields and launch detection. NAND
    IMU status bit 7 marks high-g samples; the converter writes it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
2026-11-09 Witness: fix flash log failure from USB backpressure and stale ring pages
    Flash-log-failed (status bit 7) was latching about an hour after
    power-on and stopping the text log:
    - With no USB host reading (no cable in flight, or no ser2net client),
    the forwarder retried each write forever. Its queue filled, and every
    sensor/state/debug packet logged "packet queue failed:
    ESP_ERR_NO_MEM" at 10-20 Hz. That was 77% of the text log (890 B/s).
    The 3.1 MB text stream filled, and a full stream sets the failure bit.
    Now the forwarder drops packets once USB stops draining (one 20 ms
    wait, then no wait until a write succeeds) and reports drops every
    10 s. The UART forward warning is limited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
2026-11-09 Witness: position Kalman filter; ISA altitude to 47 km, geometric
    Position filter (position_filter.{h,cpp}, host-tested):
    - Linear KF with a constant-acceleration kinematic model, ENU, origin at
    the pad. It runs as three independent [p, v] filters.
    - Predict on every 960 Hz IMU sample: the filtered accel is rotated to
    ENU by the attitude quaternion and gravity removed. Process noise is
    0.5 m/s^2 + 5% of |a|.
    - Update at 25 Hz with the newest baro and any new GPS fix, so a 25 Hz
    PX1120S uses every fix and a 10 Hz u-blox every 2nd-3rd tick.
    - Baro trust: zero from Mach 0.8 (back below 0.75). Otherwise its sigma
    scales with altitude accuracy, sigma_p / (rho g): 1 m at sea level,
    2.5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
2026-11-09 Docs: position Kalman filter, flash log fix, ISA altitude
    FIRMWARE_HANDOFF.md:
    - New "Position Kalman filter" section: model, rates, baro trust, gating,
    pad/landed holds, outputs, host test and HITL results, limitations.
    - The flash-log-failed root cause and fixes, the circular text stream,
    and the session tags on page sequences.
    - Barometric altitude now uses the full ISA and is geometric.
    - The position filter host test command.
    GROUND_STATION_PROTOCOL.md (both copies): 0x02/0xE0 position and
    velocity are now the filter estimate; the MS5607 altitude definition.
2026-11-09 Witness: log state at 100 Hz and all CAN traffic to NAND (store v4)
    New circular P*.BIN packet stream: 120 blocks, ~15.6 MB, ~32 min. Each
    record is [u32 us][source][length][complete frame], with four sources:
    - Witness 0x02 state packets at 100 Hz, built in the sensor task for
    the log (USB/radio stay at 1 Hz);
    - every packet reassembled from CAN (from Iris), forwarded or not;
    - every packet sent to Iris over CAN (commands, heartbeat);
    - radio commands.
    log_packet() never blocks; a 128-packet queue counts and warns on drops.
    Store v4 layout: IMU 96, sensors 40, text 24, packets 120, GPS 221
    blocks. v3 sessions still export through their own layout.
    Circular streams (text, packets, GPS) w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
2026-11-09 witnessOS: tabbed HITL bench, CSV viewer and Witness relay
    New Software/witnessOS app (witnessos.py) with one tab per tool, reusing
    the existing modules by import:
    - HITL bench: hitl_gui.HitlApp now embeds in a parent frame (standalone
    and --headless unchanged); HitlSession gains an rx_tap byte hook.
    - CSV viewer: viewer.py split into an embeddable CsvViewerPanel; the
    standalone CsvGraphViewer wraps it.
    - Witness relay: RelayEngine decodes TCP/serial/shared-HITL bytes with
    main.PacketDecoder and publishes via witness_link.WitnessPublisher.
    Rendering fixes: viewer graphs redraw at the real width (no 650 px floor),
    adaptive graph height, nice x/y ticks with overlap-free labels, measured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
2026-11-09 Witness: sensor records at 100 Hz, trimmed to unique fields (WL v2)
    S*.BIN records go from 48 bytes at 50 Hz to 24 bytes at 100 Hz, so the
    data rate and the 40-block (36 min) budget are unchanged. Dropped are the
    fields other streams already log: raw low-g/high-g/gyro (I*.BIN at
    960 Hz), and barometric altitude and battery (100 Hz state packets in
    P*.BIN). Kept are the magic, version, both Witness status bytes (adding
    flight state, GPS lock and HITL), sequence, uptime ms, LSM6 temperature,
    MS5607 pressure and MS5607 temperature. The prelaunch ring is now 200
    records (2 s).
    The converter decodes v2, picking the size from the version byte, and
    still reads v1 files; tests added.
    Bench, comman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
2026-11-09 Witness: log sensor records and state packets at 50 Hz
    The MS5607 delivers new pressure at about 50 Hz, so 100 Hz sensor
    records only repeated it (52% repeats; 6% at 50 Hz). Sensor records (WL
    v2) and the state packets in P*.BIN are both logged at 50 Hz now. The
    sensor stream lasts ~72 min and the packet stream ~70 min after launch;
    the prelaunch ring is 100 records (2 s).
    Bench, commanded flight: sensor records 50.03 Hz with no sequence gaps,
    state packets 50.02 Hz; the only gap is 70 ms at boot.
2026-11-09 witnessOS: embed the Witness monitor; overlay several CSVs in the viewer
    Witness monitor tab: Horizon main.py's monitor (telemetry readout, status
    decoders, graphs, console, commands, test source, JSON feed) now embeds via
    MonitorPanel; SerialMonitor is unchanged for python main.py. The tab can
    mirror the HITL tab's Witness connection (stream_feeder + rx_tap), since
    ser2net serves one client. Replaces the RelayEngine/RelayTab.
    Monitor rendering: scrollable, wheel-able graphs sized to the view, round
    value ticks, non-overlapping wall-clock ticks, vector legends, debounced
    resize redraw, min/max decimation; telemetry tiles sized to their content
    so status flags are not clipped; no bind_all; c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
2026-11-09 Viewer: shared zoom across graphs and hover readout of exact values
    All graphs now share one x range (all plotted data, or the zoom), so
    time axes line up. Zoom by dragging across any plot (band shown on every
    graph), Ctrl+wheel about the cursor, Shift+wheel to pan, Zoom out /
    Reset zoom buttons or double-click to reset. Traces are clipped to the
    view with points interpolated onto the edges; each y axis refits to the
    data in view.
    Hovering a plot draws a crosshair in every graph, rings each trace's
    nearest sample and lists the exact CSV values (value @ sample x) beside
    the pointer; logs that have not started or have ended there are omitted.
    The graph buttons moved onto the status line so th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
2026-11-09 HITL: 960 Hz synthesized IMU, run comparisons, FC log fetch; gyro saturation
    960 Hz IMU synthesis (desktop, HITL/imu_synth.py, numpy/scipy/soundfile):
    - 100 Hz trajectory truth -> 7.68 kHz.
    - Add the flight vibration recordings from launch (thrust on body x,
    lateral on y, delayed lateral on z).
    - Add LSM6DSV320X datasheet worst-case zero levels and gyro sensitivity,
    and white noise at the datasheet densities.
    - Clip at full scale, low-pass at the chip's configured bandwidths
    (407 / 384 / ~400 Hz), keep every 8th sample to give 960 Hz, quantize.
    New 0x0E HITL frame: 8 samples at 960 Hz. Witness runs them through the
    same path as real FIFO samples (filtered accel, attitude, position
    pre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
2026-11-09 Witness: resolve the pad gyro bias below the quantization step
    The pad bias was the per-axis median of each stationary window. Gyro
    counts are 0.07 dps, and with ~1.2 counts of noise the median snaps to a
    whole count, leaving up to ~0.035 dps of bias. In the 960 Hz HITL run
    with worst-case offsets that drifted the attitude 10.6 deg by landing.
    The bias is now the median refined by the mean of the samples within 3
    robust sigmas of it. The refinement is clamped to one quantization step
    (gyro_quantum_rad_s) so dense interference cannot pull it further than
    one count.
    Host: a new quantized test gives 0.0002-0.0017 dps error. The bench
    interference model gives 0.012-0.029 dps radio off (was 0.0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
2026-11-09 HITL: vibration profiles per trajectory; loud missing-deps error; safer log fetch
    - The eayf vibration recordings move to vibration/eayftrajectory/ with a
    profile.json (file names, 150.67 g full scale). A CSV run uses the
    profile named after its trajectory; trajectories without one get no
    vibration. vibration_profile chooses "none" or another profile folder.
    The run log and summary record the profile used.
    - A CSV run with synthesis on now refuses to start when numpy, scipy or
    soundfile is missing. The error names the interpreter and the pip
    command for it. Before, it silently fell back to 100 Hz IMU values
    (a run from the ESP-IDF venv's Python did this).
    - The FC log fetch is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
2026-11-10 Viewer: per-file time axis (column, units, offset) for each CSV
    Each loaded CSV now has its own time axis: the time column (or auto
    Witness uptime: uptime, then fc_uptime, then time_seconds), its units
    (s/ms/us/ns, inferred from the column name) and an offset in seconds
    applied after unit conversion. The shared x axis, zoom and hover use the
    converted, offset times.
    Defaults put Witness-clock files on one clock: auto for P/S/packet logs,
    uptime_ms for comparison*.csv, timestamp_us for I*.csv; sim_s/sim_ms
    files (truth.csv, sent.csv) are slid on with an offset.
    A Time axis box for the selected CSV (column and units dropdowns, offset
    spinbox, -1/-0.1/+0.1/+1 buttons) redraws live and shows t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
2026-11-10 Viewer: numpy columns, background loading, per-pixel envelope drawing
    Large converted logs (960 Hz I*.csv) made the viewer unusable: every row
    was kept as a dict of strings (~11x the file size in RAM) and parsing ran
    on the UI thread. Measured on a 139 MB, 536k-row I log:
    before: 12.8 s parse on the UI thread, +1.5 GB held, 22.9 s UI freeze
    adding it, 4.1 GB peak
    after: 3.1 s parse on a worker thread, +104 MB held, 0.26 s on the UI
    thread, 229 MB peak
    A 557 MB / 2.1M-row file now loads in 12 s in the background with 403 MB
    held.
    - csv_columns.load_table: numeric columns as float64 arrays via numpy's
    C loadtxt on ~4 MB chunks (empty fields filled at the byte level)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
2026-11-10 HITL tab: vibration profile picker; build runs off the UI thread
    Vibration: vibration_profile is now a dropdown (Auto = profile for this
    trajectory, None, or any vibration/<folder>/profile.json) beside
    vibration_scale; both are saved in hitl_settings.json and seed new CSV
    sources. A line under the parameters shows what the choice resolves to
    before a run and which profile the last run used (from the IMU report).
    Lag: predict (CSV parse + state track) and prepare_run (CSV build, 960 Hz
    IMU synthesis, 0x0E encoding) run on a worker thread with a busy
    indicator; Start/Load CSV/presets are disabled while building or
    streaming so nothing competes with the send loop. While a worker runs,
    the GIL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
2026-11-10 Viewer: open raw Witness .bin logs directly
    "Open .BIN..." decodes I*.BIN (IMU records), P*.BIN (packet log), WL
    S*.BIN (flash records) and wire captures with converter.py's own
    decoders and adds them as datasets, labelled by file name, with the same
    columns, paired .TXT flight state and per-file time-axis defaults as the
    converted CSV. "Save CSV" writes the selected decoded log next to it,
    byte-identical to the converter CLI.
    converter.py: each decoder is now a generator (iter_imu_log,
    iter_packet_log, iter_flash_log, iter_log) and decode_* wrap them, so the
    viewer streams rows into numpy columns without holding them (a 2.1M-record
    I*.BIN decodes in ~28 s on the worker, ~400 MB held). sele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
2026-11-10 Audit: trim dead code, leftovers and obsolete files in Software/
    - Witness: drop vendored _tmp_pdf_tools (pypdf), _tmp_w25n01gw.pdf,
    duplicate "flashit copy.ps1", and four unused members
    (filter_lag_samples, gyro_mean, kSeaLevelPressureMbar, kFactoryBaudRate).
    - Iris/Aperture: drop "flashit copy.ps1" wrappers around flashit.ps1.
    - Intercomm: untrack the built can_transport_test.exe; ignore *.exe.
    - HITL/Horizon: remove unused imports, write-only attributes, an unused
    constant and helper, and a duplicated dict key in the fake Witness.
    - .gitignore: drop per-file __pycache__ entries already covered.
    No behaviour or wire-protocol changes.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
2026-11-10 Kalman altitude + KF flash log; Aperture LC86 GPS in 0xF0; viewer any-CSV + FFT
    Witness:
    - 0x02/0xE0 altitude slot now carries the Kalman altitude above the pad
    (raw pressure stays in 0x01/0xE0/S*.BIN).
    - New 0xE2 Kalman log packet (flash P*.BIN only, source 5, 25 Hz): ENU
    state, P00/P11/P01 per axis, baro/GPS innovations, baro S and sigma,
    Mach, gate/hold flags and counters. Filter records per-cycle innovations.
    Aperture:
    - LC86 GPS on UART1 (RX 38, TX 39, PPS 18, RESET_N 14), 10 Hz GGA+RMC via
    PAIR with PMTK fallback; host-tested NMEA parser.
    - 0xF0 status grows to 29 bytes with fix quality, sats, lat/lon (1e-7 deg),
    MSL altitude, GPS time, HDOP and fix age; legacy 13-byte frame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
2026-11-10 Horizon: Visualizer window (orientation + pad map), AGL altitudes, protocol audit
    Visualizer (Windows > Visualizer / F9 in horizon.py), a separate toplevel:
    - Orientation tab: live Witness quaternion (fresh 0xE0, else 0x02) as the
    Attitude tab's 3D rocket with large tilt / roll / heading readouts. An
    all-zero quaternion is explained: not initialised on the pad, or LOST in
    flight after gyro saturation (last valid attitude drawn dashed).
    - Map tab: top-down, north-up, centred on the pad. Range rings, north arrow,
    scale bar, tracks for Witness Kalman ENU / Witness GPS / Featherweight
    tracker (distinct styles), range, bearing, AGL and age per source. Pad
    source shown; "Set pad here"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
2026-11-10 Rebuild all GUIs in PyQt6 + pyqtgraph; HITL bench and Witness monitor live in witnessOS
    - Shared Qt foundation (Horizon/qt_common.py): one QApplication, plot
    defaults with clip-to-view + peak downsampling, ShiftableCurve, Throttle,
    GuiQueue, run_in_thread.
    - CSV viewer: Qt UI over Qt-free viewer_data.py. Offsets move curves
    (no rebuild), lazy plot creation, linked x axes, zoom floor, memory
    guard before loading, background load/FFT, pyqtgraph spectrogram.
    - Horizon: Qt-free witness_protocol / monitor_core / telemetry_model /
    attitude_scene / flight_layout_draft; Qt main window, ground tabs,
    Flight View, AIM, Attitude; Visualizer with 3D attitude (GL, 2D
    fallback) and the pad ma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
2026-11-10 Visualizer: AIM Xtra track and attitude overlay, stale fading, map auto range, light mode
    - Map plots the AIM Xtra GNSS track (gnss_payload/v1, >= 4 sats) beside the
    Witness and Featherweight tracks; AIM altitude shown raw (unit unverified).
    - AIM orientation drawn as a translucent purple rocket over the Witness rocket,
    with AIM tilt/roll/heading readouts.
    - Stale samples (> 3 s) fade instead of hiding: Witness 30%, AIM 12%.
    - Map "Auto range" (default on): pad-centred, 500 m to 20 km in fixed steps to
    fit the farthest rocket; manual zoom/pan turns it off.
    - All Qt apps forced to light mode (white background, black text).
2026-11-10 CSV viewer: redraw only when input settles, tiled/resizable graphs, stall recorder
    - Ctrl/Shift+wheel zoom and pan are accumulated and applied once the wheel
    stops (150 ms); touchpad deltas scale as fractions of a notch. Shift/middle
    drag pan applies on pause or release. Page scrolling builds new graphs once
    scrolling stops; the hover readout updates once the mouse is still (80 ms).
    - Traces over 5000 points use a 1 px pen (~2.5x faster paint); at most 16 live
    plots (was 40), so fewer graphs re-clip on every zoom.
    - "Graphs per row" (1-4) tiles graphs side by side; drag a graph's bottom edge
    to resize it (its row when tiled, applied on release); double-click or
    "Auto heights" res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
2026-11-10 Remote Witness feed over Tailscale; Horizon connects to it; Map & Attitude tab
    - witnessOS's Witness monitor publishes the receive-only horizon.witness.v1
    feed on this PC's Tailscale address, port 8767, in addition to
    127.0.0.1:8766 ("Share over Tailscale", on by default in witnessOS; retries
    every 10 s while Tailscale is down; --remote-feed / --remote-feed-port).
    - The remote feed is a separate WitnessPublisher (own socket, thread, queue and
    8 MB per-client buffer): a slow or dead remote viewer is dropped from it and
    never delays the local feed. Binds Tailscale ranges only (100.64.0.0/10,
    fd7a:115c:a1e0::/48), never the LAN/internet. TCP keepalive on remote links.
    - Horizon's Wi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
2026-11-11 GPS RF simulation for HITL, ephemeris upload, fast log clear, DOP-weighted Kalman GPS
    Firmware (Witness):
    - Fast log clear (05 68 6A): erases only the two session headers; the
    session number keeps counting; untagged-page fallback no longer adopts
    other sessions' pages. Full erase (05 68 69) unchanged.
    - GPS ephemeris upload (0x4741/44/45/51 chunked command frames, USB or
    radio, CRC-checked) written to the PX1120S as SkyTraq 0x41 with ACK/NACK
    counting. SkyTraq has no almanac upload; ephemeris is the better aid.
    - GPS cold start (0x4752, Pad Idle only): SkyTraq 0x01 mode 3 / u-blox
    CFG-RST, then reconfiguration.
    - HDOP (GGA) and VDOP (GSA) scale the Kalman GPS sigmas; every 25 Hz fi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
2026-11-11 Kalman GPS weighting for receiver lag, Horizon pad freeze and GPS altitude trace, HITL bench activity and split logs
    - Witness position filter: GPS sigma = DOP term combined in quadrature with
    receiver-lag terms, 0.1 s x speed and 0.5 s^2 x a decaying (5 s) peak of the
    net acceleration. RF HITL showed the PX1120S lagging 44-78 m in boost and
    coast; lagging fixes had pulled the sustainer velocity down by 216 m/s.
    Re-fly of eayftrajectory: -40 m/s, worst altitude error in the GPS gap
    1.5 km instead of 6.9 km. Upper sigma clamp 1000 m. Synthetic-GPS test
    bound relaxed 25 -> 30 m.
    - Horizon: the Witness-derived pad updates only in Pad Idle with GPS lock and
    freezes from the first p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
2026-11-11 Galileo E1 in HITL RF sim, all-constellation GPS config, report error surfacing
    - galileo_rf.py: build galileo-sdr-sim (witness-windows branch) with MinGW, shift
    Galileo I/NAV ephemerides to the scenario hour, generate E1 along the same
    trajectory and mix it into the GPS L1 IQ at equal per-satellite power
    - gps_rf: --galileo / build-galileo CLI, per-constellation GSA parsing (NMEA 4.10
    system ID), static test reports satellites used per system
    - witnessOS HITL tab: "Add Galileo E1" option
    - Witness firmware: enable GPS+GLONASS+Galileo+BeiDou, QZSS, SBAS and a 3 deg
    elevation mask on the PX1120S (optional commands, NACKs logged and skipped)
    - hitl_session: report generation failures s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
2026-11-11 GPS reacquisition: 100 Hz RF simulation, restart handling, fixed 115200 baud, report
    - gps_rf: gps-sdr-sim built with -DSIM_UPDATE_HZ=100 and 100 Hz motion files
    (Galileo gets a 10 Hz copy); check_motion_rate refuses a build for another
    rate; hot_restart_body/frames; make_player + RemoteHackRFPlayer for a HackRF
    on the bench Pi (IQ copied first, then played over SSH)
    - hitl_session: hot_start and remote HackRF options
    - witnessOS HITL tab: "HackRF is on the bench Pi"
    - Witness: a host-sent 0x01 System Restart through the assist path makes
    Witness reconfigure the receiver; kFixedBaud keeps the PX1120S at 115200
    (no scan, hint, 0x05 switch or rescan); host tests for both
    - GPS_REACQU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
2026-11-12 Altitude filter to <5 % on eayf; replay/Monte Carlo tuning tools; launch-day GPS findings
    Filter (Witness):
    - High-g accelerometer calibrated against the low-g in flight (scale and
    offset per axis from overlap samples; block means, clipping hold-off) and
    in the six-face calibration (layout 2, layout 1 still loads)
    - Barometer scale state (EKF, (1 + k) x height), estimated while GPS altitude
    is recent, a consider parameter otherwise
    - GPS: stronger de-weighting under acceleration, no 1 km sigma cap, optional
    latency term, vertical resync blocked while the barometer is healthy
    - Accelerometer handoff margins for vibration (12 g up, 10 g / 100 ms down)
    - Tuned defaults; host tests updat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
2026-11-13 Wi-Fi OTA via maintenance boot, SF7/500 LoRa, acks, heading alignment
    Witness firmware
    - Wi-Fi OTA and log download: two OTA slots on the 8 MB flash (NVS kept in
    place), rollback with self-test, soft-AP + small HTTP server
    (/info /ota /logs /reboot /wifi/off). Wi-Fi runs only in a maintenance
    boot (RTC one-shot flag) where the flash logger mounts read-only, freeing
    the RAM Wi-Fi needs; status byte 1 bit 5 flags it (not flight ready), a
    5 s state beacon keeps the flag visible over LoRa, a watchdog restores
    LoRa if the Wi-Fi start hangs, and leaving Wi-Fi reboots to flight mode.
    - Command acks (0x06) and resumable GPS-assist transfers with status
    bitmap (0x07); pad heading comman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
2026-11-13 Fix audit criticals: FSM glitch/resume, radio command gating, Iris load restore
    From the software audit (Software/AUDIT/, Haiku first pass, Sonnet
    evaluation, coordinator review):
    - C1 Witness FSM: the tracked maximum and the Coast->Descent test now use a
    median-of-5 barometer altitude with a physical rise limit, pause while the
    position filter gates the baro (Mach >= 0.8 or out of range), and need a
    downward filtered velocity. Velocity-only Descent fallback (< -30 m/s for
    2 s, after a seen climb) when the baro is unusable. FSM re-baselined on
    HITL entry/exit. HITL eayf 120 s: Descent 5 s after true apogee via the
    velocity path (baro out of range above ~31 km), no false Descent.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
